Lurk0526/autonomous-water-transport-robot/hardware/README.md

# 硬件

- [第二版机械文件](cad/v2/README.md)：原件、配件解压文件和校验清单。
- [硬件清单](BOM.md)：现有记录及尚缺型号/数量，不作为采购订单或结算单。
- [电气与通信资料](electronics/README.md)：等待实际接线与设备手册。

最新设计、CAD 实际几何与装配实物尚未完成三方核对，尺寸说明以 [机械设计文档](../docs/mechanical-design.md) 的范围为准。
