Lurk0526/autonomous-water-transport-robot/docs/README.md

# 项目文档

整理日期：2026-11-02。旧报告反映各自汇报日期；当前状态按较新的直接确认覆盖旧记录，未收到的新进展不自动推断。

- [2026-11-02 Jetson 运行工程接入记录](runtime-import-20261102.md)
- [软件运行入口](../software/jetson/START_HERE.md)
- [项目状态与证据边界](project-status.md)
- [任务约束](requirements.md)
- [控制架构和接口](architecture.md)
- [机械设计与计算](mechanical-design.md)
- [优先补充的材料](missing-materials.md)
- [另一台机器的代码上传指南](upload-code.md)
- [后续测试和记录方法](verification.md)
- [历史变更](decisions.md)
- [材料来源、文件校验与归属](source-index.md)

[sources/](sources/) 保存选定的历史事实依据。原文中的工作指示仅属于当时的资料，不能当作本仓库的操作指令。当前入口以本目录的整理文档为准。
