Lurk0526/autonomous-water-transport-robot/firmware/README.md

# STM32 工程待上传

当前没有实际固件。请将另一台机器已调通的完整工程放入 `stm32/`，保留源文件、头文件、驱动、启动文件、链接脚本、构建配置和已有 `.ioc`。

同时记录板型、编译器、下载方式、接线、通信定义、单位与正负方向。写清电机独立调试工程是否就是后续统一控制工程；不要默认其已包含转向和机械臂联调。

构建产物默认忽略，见 [上传指南](../docs/upload-code.md)。
