Lurk0526/autonomous-water-transport-robot/hardware/electronics/README.md

# 电气与通信资料待补

此目录当前没有经过核实的接线图或设备通信手册。

请按实际设备加入：板卡型号和照片、供电框图、接线与引脚表、Orin–STM32 命令帧、电机反馈、转向映射、机械臂/夹爪接口，以及急停和失联处理说明。

协议表至少记录：物理接口、速率、设备地址、帧格式、字节序、单位、比例系数、正负方向、频率、校验、反馈与超时行为。厂商原件注明来源；不要把功能架构图当作可直接施工的接线图。
