Lurk0526/autonomous-water-transport-robot/assets/images/README.md

# 图像来源与用途

| 文件 | 来源 | 能说明什么 |
| --- | --- | --- |
| [vehicle_cad_reference.png](vehicle_cad_reference.png) | P5 已有的整车/机械臂 CAD 截图 | 历史布局参考；未经核对，不当作本次 v2 或 650 mm 制造尺寸证据 |
| [gripper_prototype.jpg](gripper_prototype.jpg) | P5 用户提供的四爪实物照片 | 夹具实物外观；基于供应商设计，不证明安装完成或承载通过 |
| [vision_bench.jpg](vision_bench.jpg) | P4 用户提供的台架照片 | 台架设备布置，原照片保留 |
| [vision_tracking.jpg](vision_tracking.jpg) | P4 用户提供的近景照片 | 台架近景；动态随动依赖团队报告，视频和日志待补 |

没有为图片添加检测框或合成试验结果。原始来源路径及文件哈希记录在 [导入清单](../../docs/import-manifest.json)。
