Lurk0526/autonomous-water-transport-robot/hardware/cad/v2/README.md

# 第二版机械文件

2026-11-02 接收，原始文件修改时间为 2026-10-26。版本“v2”沿用用户本次描述，没有通过 SolidWorks 几何比较确认与旧版的差异。

| 路径 | 内容 |
| --- | --- |
| `native/成品车.SLDASM` | 用户提供的整车总装，原字节保留 |
| `source_archives/机械臂配件.zip` | 用户提供的配件原包，原字节保留 |
| `arm_parts/机械臂配件/` | ZIP 解压的 25 个零件与 7 个子装配，保留原名称 |
| [manifest.json](manifest.json) | 原件、解压文件的大小、SHA-256 和 ZIP 目录信息 |

ZIP 的文件完整性已检查，中文文件夹名按原包的 GBK 编码还原。原有下划线文件名保持原样；未经 CAD 引用核对不改名。

**未完成 SolidWorks 打开、引用解析、装配重建、尺寸测量或干涉检查。** 当前不能保证配件 ZIP 包含整车所有依赖，也不能把文件名“成品车”当作实物整车完工证明。

优先补充从整车总装生成的完整 Pack and Go ZIP，以及同版 STEP。具体要求见 [待补材料](../../../docs/missing-materials.md)。
