Lurk0526/autonomous-water-transport-robot/docs/mechanical-design.md

# 机械设计与计算依据

## 最近确认的设计输入

2026-10-25 修订：2 根 650 mm 的 6060 纵梁，3 根 240 mm 的 4545 横梁；亚克力板 650 × 360 × 4 mm。供应商米重分别按 2.38 kg/m 和 1.50 kg/m。实际型材合金、热处理状态、整车孔位和完整质量尚未核对。

P5 此前确认车架已装配，但没有证明已装配的就是切短后的版本。2026-11-02 收到的第二版 CAD 尚未在 SolidWorks 中打开测量，不自动视为上述尺寸的制造定稿。

设备布置意图是前部机械臂、中部 Orin、后部电池，利用已有电池质量平衡前部载荷。没有角载称重或重心测量。悬架载荷应通过金属连接件传给型材，不能把亚克力板作为悬架承力支架。

## 型材与铺板质量估算

旧版型材按用户后来更正的 4545、1.50 kg/m 计算，不能沿用更早的 4040/0.94 kg/m。

```text
旧型材长度 = (840 + 2×760 + 4×310 + 4×140 + 8×61.42) / 1000
           = 4.65136 m
旧型材质量 = 4.65136 × 1.50 = 6.97704 kg
新型材质量 = 2×0.650×2.38 + 3×0.240×1.50 = 4.17400 kg

亚克力参考密度 = 1190 kg/m³
旧铺板 = 2×0.560×0.175×0.004×1190 = 0.93296 kg
新铺板 = 0.650×0.360×0.004×1190 = 1.11384 kg
```

| 范围 | 旧版估算 | 新版估算 |
| --- | ---: | ---: |
| 型材 | 6.977 kg | 4.174 kg |
| 亚克力板 | 0.933 kg | 1.114 kg |
| 合计 | 7.910 kg | 5.288 kg |

相同统计范围的估算减少约 2.622 kg，即 33.15%。未计角码、紧固件、金属安装板、橡胶和全部设备，不能写成整车实测减重 33%。旧结构也未确认实际制造。

## 四爪与末端载荷

四爪来自供应商基础设计，团队修改机械臂末端连接接口。PLA 打印件、钢适配件和橡胶接触垫的选择已经讨论；用户称实心打印，不推定为某个具体填充率。

夹具总成约 250 g 是用户回忆估计，包含舵机、连杆及紧固件，未含钢适配件，未称重。加约 650 g 碗水后为约 900 g 加适配件的初步清单，不能作为机械臂承载能力已经满足的依据。

## 支承垫与悬架初选

设备板支承垫的较新方案：4 块 60 × 60 × 5 mm 纵梁角部垫，4 块 45 × 45 × 15 mm 横梁垫。P5 确认尚未安装；硬度、预压、挠度和隔振效果待测。

汇报中的四根 6 N/mm 弹簧是初选值，允许与最终实物不同。示例假设：15–20 kg 全部视作簧载质量，四轮均分，轮端行程 50 mm，运动比 r=弹簧压缩/轮心位移=0.7，忽略预载和摩擦。

```text
轮端刚度 kw = 6 × 0.7² = 2.94 N/mm
单轮静载 = m × 9.81 / 4
静态下沉 = 单轮静载 / kw ≈ 12.5–16.7 mm
```

该计算只能解释初选思路。真实轮荷、运动比、阻尼、非簧载质量、动态冲击和触底风险都还未测量。旧记录约 720 mm 支撑跨度属于 800 mm 车架，不能用于 650 mm 新版。

原始确认见 [质量重算](sources/p5/frame_mass_recalculation_confirmed.md)、[悬架初选](sources/p5/suspension_preliminary_choice_6Nmm.md) 和 [P5 较新修订](sources/p5/revision_v4_current_basis.md)。
