Lurk0526/autonomous-water-transport-robot/software/jetson/requirements-jetson.txt

-c constraints-jetson.txt
-r requirements-cuda129.txt
torch @ https://pypi.jetson-ai-lab.io/jp6/cu129/+f/f36/0db283b1249b3/torch-2.8.0-cp312-cp312-linux_aarch64.whl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
torchvision @ https://pypi.jetson-ai-lab.io/jp6/cu129/+f/255/341cb5beb4673/torchvision-0.23.0-cp312-cp312-linux_aarch64.whl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
ultralytics==8.4.178
onnx
onnxruntime
onnxslim
pyorbbecsdk2==2.0.18
pyserial
pyyaml
scipy
matplotlib
cuda-python>=13.2,<13.3
cffi
