Lurk0526/autonomous-water-transport-robot/software/jetson/requirements-labelme.txt

# Independent annotation environment; do not install into the Jetson Torch venv.
labelme==7.8.1
