Lurk0526/autonomous-water-transport-robot/software/jetson/requirements-road.txt

-c constraints-jetson.txt
transformers==4.57.1
huggingface-hub==0.35.3
safetensors==0.6.2
tokenizers==0.22.1
tqdm==4.67.1
