Lurk0526/autonomous-water-transport-robot/reports/p5/speaker-script.md

# AstraGO P5 中英讲稿

对应修改后的10页正文，英文约589词。建议按每分钟115—120词排练，配合翻页与指图停顿，目标约5分半。只朗读英文；中文用于理解。第11—12页为备用页。

## 第1页 开场

**English**

Good morning. We are Group Two. AstraGO transports an open water bowl through continuous robotic gripping. Our design combines lightweight construction with vibration control, focusing on material selection, frame geometry, load distribution, manufacturing and battery sizing.

**中文**

大家好，我们是第二组。AstraGO通过机械臂持续夹持敞口水碗完成运输。我们的设计将轻量化与振动控制结合，重点介绍材料选择、车架结构、载荷分布、制造方法和电池容量。

---

## 第2页 材料选择

**English**

Each material serves a specific function. Aluminium profiles provide a low-density frame with reusable mounting slots. PLA enables low-cost custom fingers and supports our lightweight arm-end design. Steel is concentrated at the arm interfaces to retain the required connections. Acrylic makes the equipment deck convenient to cut and drill. This combination considers material, geometry and manufacturing together, giving each part a clear role in the vehicle.

**中文**

每种材料承担明确功能。铝型材提供低密度车架和可重复使用的安装槽；PLA便于低成本制作定制夹指，服务于末端轻量化设计；钢件集中用于机械臂接口，保留所需连接；亚克力便于铺板切割和钻孔。这样的组合把材料、几何和制造方式一起考虑，让每个部件各司其职。

---

## 第3页 车架减重

**English**

The frame provides our main calculated weight reduction. The original design used forty-five-millimetre profiles throughout. We removed the uprights and braces, reducing profile pieces from nineteen to five and brackets from eighteen to eight. Both longitudinal rails were shortened from eight hundred to six hundred and fifty millimetres, together with the deck. Calculated profiles plus acrylic decrease from seven point nine one to five point two nine kilograms, a saving of about two point six two kilograms, or thirty-three percent.

**中文**

车架是主要的计算减重来源。旧版全部采用4545型材，我们取消立柱和斜撑，型材从19件减少到5件，角码从18个减少到8个。两根纵梁由800毫米缩短到650毫米，铺板同步缩短。型材与亚克力的计算质量由7.91公斤降到5.29公斤，减少约2.62公斤、约33%。

---

## 第4页 载荷平衡

**English**

The battery also contributes through its position. The front arm and suspended bowl place load towards the front, so we position the battery at the rear to help balance them. One necessary component then performs two functions: energy storage and load balance. This is our approach to avoiding a separate ballast block and the extra mass added solely for balance.

**中文**

电池的位置也参与轻量化设计。前端机械臂和悬空水碗使载荷趋向前部，因此把电池放在后端参与平衡。这样一个必需部件同时承担储能和配重两个功能，目标是避免专门增加配重块，省去只为平衡而增加的质量。

---

## 第5页 3D打印与行业参考

**English**

Three-dimensional printing suits our small batch and custom finger geometry. We adapted the supplier-based mechanism at its arm interface. Solid PLA forms the fingers, while rubber pads provide bowl contact. A 2025 Fraunhofer IWU and MOSOLF vehicle shelf shows how integrated printing can reduce extra attachments. The useful principle is to consider geometry and mounting together.

**中文**

3D打印适合我们的小批量定制夹指。我们在商家机构基础上适配机械臂接口，实心PLA形成夹指，橡胶垫用于接触水碗。Fraunhofer IWU与MOSOLF在2025年的汽车置物架案例表明，集成打印能够减少额外安装件。我们借鉴的是将几何形状与安装功能一起考虑的原则。

---

## 第6页 电池选择

**English**

We select a forty-eight-volt, twenty-amp-hour pack for our design. The two motors reach a combined two-kilowatt peak only during acceleration. We therefore distinguish short power demands from the energy required over the task. The selected pack offers thirty amps continuous and a specified sixty-amp peak, with nine hundred and sixty nominal watt-hours. A forty-amp-hour pack doubles that stored energy. Our sizing approach uses the smaller capacity within its operating envelope, avoiding capacity beyond the task requirement.

**中文**

本次设计选择48伏20安时电池。两个电机合计两千瓦是加速时的短时峰值，因此选型时区分瞬时功率与整个任务的能量需求。所选电池持续放电30安、标示峰值60安，标称储能960瓦时；40安时则使储能翻倍。我们的选型思路是在工作范围内采用较小容量，避免超出任务需求的容量配置。

---

## 第7页 扰动传递

**English**

We control disturbance along its transmission path: from the road, through the wheels and suspension, to the frame, arm and bowl. Suspension responds to bumps, deck pads provide compliance, and rubber jaw pads support stable contact. Smooth starts and stops complement these mechanical measures.

**中文**

我们沿扰动传递路径布置措施：从路面到车轮与悬挂，再到车架、机械臂和水碗。悬挂响应颠簸，铺板垫块提供柔性，夹爪橡胶垫保持接触稳定，并通过平缓起停配合这些机械措施。

---

## 第8页 悬挂设计

**English**

Our preliminary spring selection is six newtons per millimetre at each wheel. Using a design mass of fifteen to twenty kilograms, fifty millimetres of wheel travel and an assumed motion ratio of zero point seven, calculated static sag is thirteen to seventeen millimetres. This uses about twenty-five to thirty-three percent of the travel, leaving upward movement for bumps. The spring provides support and compliance, while damping controls rebound, balancing rough-ground response with carrying stability.

**中文**

四轮弹簧初选为每根6牛每毫米。按15至20公斤设计质量、50毫米轮心行程及0.7的运动比假设，计算静态下沉约13至17毫米，占总行程约25%至33%，保留应对颠簸的上跳空间。弹簧提供支撑和柔性，阻尼控制回弹，兼顾越野响应和持碗稳定性。

---

## 第9页 橡胶支撑

**English**

Our deck-support design uses eight rubber pads: four at the rail corners and four on the crossmembers. The two sizes match these different interfaces. The pads form a compliant layer between the frame and equipment deck. Their placement combines distributed support with the aim of reducing transmitted disturbance, while the jaw pads address bowl contact.

**中文**

设备板支撑方案采用八块橡胶垫：纵梁四角四块、横梁四处四块，两种尺寸分别匹配不同接口。垫块在车架与设备板之间形成柔性层，通过分布支撑减少传递扰动；夹爪垫片则处理与碗的接触。

---

## 第10页 总结

**English**

Our design combines a shorter frame, functional material choices, balanced equipment placement, custom printing and appropriate battery capacity. The profiles and deck achieve about thirty-three percent calculated mass reduction. Suspension and compliant interfaces complete our approach to stable water-bowl transport. Thank you.

**中文**

我们的设计结合了缩短车架、按功能选材、平衡设备布局、定制打印和适当电池容量。型材与铺板的计算减重约33%，悬挂和柔性接口共同服务于稳定运水。谢谢。
