Lurk0526/autonomous-water-transport-robot/docs/project-status.md

# 项目状态

> 2026-11-02 运行工程更新：已补 Jetson 软件、相机/ROS 感知、训练工具、模型索引及本机仿真证据。下面保留此前资料整理时的逐项状态；同日软件与相机更新以 [接入记录](runtime-import-20261102.md) 为准，未完成的实车验证继续有效。

汇总日期：2026-11-02。物理进度的最近文字依据主要来自 2026-10-19 的 P4、2026-10-24/25 的 P5。2026-11-02 新增的是机械文件接收与整理，不能据此推定硬件功能已有新进展。

“团队报告”表示此前由用户说明；“材料在库”表示本次收录了文件；“待验证”表示没有收到足够的运行、测量或测试证据。

| 子系统 | 目前能确认的内容 | 尚缺内容 |
| --- | --- | --- |
| 车架 | P5 团队报告车架已装配；纵梁后续改短至 650 mm | 当前整车照片、最新版孔位、完整 BOM、实测质量；装配记录未说明是否为切短后的版本 |
| 第二版 CAD | 收到 `成品车.SLDASM` 和 `机械臂配件.zip`，原件及校验值已归档 | 总装关联的全部车体零件、SolidWorks 重建与依赖检查、STEP 导出 |
| 四爪 | 已加工；有实物照片；修改了与机械臂连接的接口 | 是否已安装、开合范围、工具中心、质量/重心、持续承载及防滑测试 |
| 视觉模型 | 团队报告 500 多张图像，YOLO11n-seg 微调，随机 8:1:1 划分 | 确切数量、标注、训练配置、权重、评估输出；随机划分不能替代独立场景验证 |
| 视觉跟踪 | 团队报告 OpenMV 图像经 Orin 处理、STM32 控制机械臂随动；台架照片在库 | 原始代码、动态视频、延迟与跟踪误差记录；未确认三维定位与抓取 |
| 驱动 | 团队报告 STM32 已实现电机启停、正反转、调速、转速读取 | 工程、命令帧、原始日志、反馈单位；未确认速度闭环 |
| 转向 | 前轴舵机转向为当前方案 | 舵机型号、接口、电源、标定、闭环与驱动转向联调 |
| Orin | 已购 Jetson Orin Nano 8GB，启用 Super 模式并刷机 | JetPack/L4T、依赖版本和实际环境检查输出 |
| 导航相机 | P4 报告 Orbbec Gemini Pro Plus 已到货 | 准确 SKU、SDK、固件、取流及户外深度效果 |
| Isaac Lab | P4 报告环境已安装 | 机械臂导入、URDF/资产、场景配置、实际仿真日志 |
| ROS 集成 | 已讨论作为后续集成框架 | 工作空间、节点、启动配置与运行证据 |
| 电源 | P5 偏向 48 V 20 Ah；供应商称 30 A 持续、最高 60 A 峰值 | 是否已购、化学体系、BMS、峰值持续时间、整车功耗和接线 |
| 急停 | 人工远程紧急下电为计划功能 | 实际接线、停止行为、通信失联和断电测试 |

以下均没有在现有材料中得到完整验证：自动取放碗、整车自主导航/绕障、持续载水运输、达到课程速度要求、振动改善、整车减重比例、Sim-to-Real 完成。

## 本次仓库整理完成的内容

第二版文件原样归档并生成 SHA-256 清单；配件 ZIP 完整性检查和文件目录整理；选定 P1–P5 汇报归档；整理阶段事实、设计计算、照片来源、补件清单及跨机器代码目录。当前新增的是资料组织，不是运行功能。
