Lurk0526/autonomous-water-transport-robot/docs/runtime-import-20261102.md

# Jetson 运行工程接入记录

日期：2026-11-02。来源：自动运水项目在 Jetson 上已有的工作工程。按仓库原有代码上传约定，完整放入 `software/jetson/`，保留模块导入和配置间的相对路径。

## 本次新增

- 小车输入适配、黑/白/黄循迹、无标线备用导航、参数来源校验、录制与只读监测。
- 道路语义分割的训练/评估/导出、ROS RGB-D 几何关联、TensorRT 部署与故障处理工具。
- OpenMV 主机取流、碗实例分割、机械臂跟随、串口通信、标注与 Windows/4060 工具。
- 无硬件导航仿真、抓放任务流程和奖励审计、现有测试及配置。
- 原 Jetson 部署、相机与跟随记录、测定表、模型/数据索引和软件测试证据。
- 本机已有 CAD 资产及其原始清单，保存在运行工程内部，未覆盖仓库第二版 CAD。

原仓库 `hardware/`、`reports/`、`assets/images/` 及其校验记录保持原样。`software/jetson/README.md` 保留原工作工程说明；先从 [START_HERE](../software/jetson/START_HERE.md) 进入。

## 状态修订与证据

| 历史待补项 | 本机补充的内容 | 仍未完成 |
| --- | --- | --- |
| Jetson 与 ROS 仅为方向 | Python 依赖锁、ROS launch/参数、环境验证程序与部署记录 | 新机器重新安装与环境验收 |
| 导航相机型号待确认 | 本机记录为 Gemini MAX；RGB-D、内部 TF、回放与故障恢复记录 | 与机械资料中的 Pro Plus 名称差异须按同一实物铭牌核对；最终外参、户外及装车精度 |
| 没有视觉运行代码 | 碗识别、OpenMV 主机链路和机械臂随动实现 | 独立板上脚本、完整标注数据和动态实机视频；自动三维抓取 |
| 没有导航/仿真实现 | 循迹主方案、备用路径控制、绕障、输入失效及任务模拟 | 真实底盘驱动、反馈闭环、实测车体与制动参数 |
| 没有训练/评估材料 | 道路/碗训练工具、道路部署清单与已有测试指标 | 本仓库未收录模型二进制与完整原始数据；现场测试 |
| 只有机械二版材料 | 本机另有命名为 chassis-v3 的 CAD 资产 | 跨版本对应、650 mm 实车一致性与 SolidWorks 重建 |

道路记录中的 2,095 张独立测试、排除水类后的六类 mIoU 79.62%、铺装 IoU 94.41% 来自既有离线评估输出，本次整理没有重新训练或重算精度。测试图像仍含水面场景；不能解读为专用砖路现场性能。

截至 2026-11-01 的任务优先级为循迹主导航、无标线备用。原记录里更早的“未确认赛道线”保留为历史背景，以后续更新为准。旧 P1–P5 汇报继续反映各自日期，不能用本次代码上传回写当时成果。

## 文件选择

收录实际源码、配置、依赖、文档、相关原生 CAD 和小型软件证据。不上传虚拟环境、`work/` 全目录、ROS build/install/log、完整公开数据集、rosbag、重复发行 ZIP、训练权重或 TensorRT engine。模型和原始记录使用文件大小与 SHA-256 索引；它们仍存原 Jetson/训练交付文件中，索引不是可下载权重。

厂家资料目录不等于团队定制底盘固件，本次不把厂家 STM32 例程填成已完成的实车控制工程。所有导入动作只操作文件；验证不启动相机服务、不打开串口、不发送机器人运动目标。

## 仍需联调

STM32 协议与真实转向/速度/IMU/里程计、相机到车体的实测安装关系、赛道线形和站点规则、有效距离参考、机械臂与夹爪的关节/负载/工具坐标、真实抓放和洒水记录仍待补。仿真假设继续明确标注，未知实车参数保持 null。
