Lurk0526/autonomous-water-transport-robot/docs/decisions.md

# 主要历史变更

| 日期 | 变更或澄清 | 当前如何使用 |
| --- | --- | --- |
| 2026-09 | 必须用自制铝型材底盘，不能直接用 RC 成品底盘 | 作为结构要求保留 |
| 2026-09 | 碗不能加盖，运输全程机械臂持续夹持，禁止车载碗托 | 不引入托碗卸载方案 |
| 2026-10-10 起 | 方案改为双电机后驱、皮带传动、前轮机械转向 | 覆盖旧四独立电机/滑移转向讨论 |
| 2026-10-15 | Orin 和众灵 MV4 机械臂已购；导航相机名称按用户原称保留 | 覆盖旧“尚未购入”状态；不擅自改相机 SKU |
| 2026-10-19 | STM32 统一承担下位指令；四爪加工但安装未确认；视觉随动和电机独立控制已有报告 | 功能架构与已实现链路分别标明 |
| 2026-10-24 | P5 确认车架已装配；实际夹具照片在库 | 不再把车架一概写成待加工；仍需新装配照片 |
| 2026-10-24 | 抓碗后相对车体保持姿态 | 不写成已实现主动调平、主动减振或自动收臂 |
| 2026-10-24 | 垫片改为 60×60×5 mm 和 45×45×15 mm，尚未安装 | 覆盖早期 50×50 / 40×40 平面尺寸 |
| 2026-10-25 | 旧型材更正为全 4545；新纵梁 800→650 mm，铺板随之缩短 | 覆盖更早质量对比与旧支撑跨度 |
| 2026-10-25 | 48 V 20 Ah 作为倾向方案，6 N/mm 弹簧作为汇报初选 | 均不视为实测性能或已装车参数 |
| 2026-10-26 | P5 汇报采用用户修改及案例合并版 | 归档该版，保留历史计算假设 |
| 2026-11-02 | 用户提供第二版整车总装和机械臂配件 ZIP，要求整理 GitHub，代码另机上传 | 原件保留，依赖待核实，代码目录标待补 |

较新的文字设计输入不自动证明 CAD 和实物已同步；三者需要版本对照。
