Lurk0526/autonomous-water-transport-robot/software/jetson/docs/bowl-follow-fast-20261022.md

# 重新摆姿后的第二档跟随测试（2026-10-22）

用户确认手动重新摆过机械臂，肘部由原标定区间移动至约 P1741。
旧配置的关节范围及图像响应不能直接用于该姿态。期间未因报错而扩大肘部范围；
已经停止的主轴执行过受限测量、记录实际位置后才恢复跟踪。

## 本次实际采用的标定

新主轴双向标定已通过，测量数据为
`work/bowl-follow/calibration-20261022-213842/report.json`。
局部图像响应矩阵（行 x/y，列 000/003，单位 px/实际 P）：

```
[ 1.966956, -0.027066 ]
[-0.073875,  0.969621 ]
```

条件数 2.0364。对应测量姿态约：000 P1627、001 P1331、002 P1742、
003 P959、004 P1473、005 P1508。肩部曾在新姿态下的小幅试动中出现回落，
并导致目标移出完整画面，故本轮没有把未通过的新五轴数据标为成功。
当前只有底座和腕部执行图像纠偏，其他四轴查询位置并保持。

## 第二档速度策略

底座和腕部单步指令上限 100 P，位置指令时间 500 ms。图像偏差小则降低有效位移，
并在中心区停止，不把所有动作都强制放到最大。主轴正在运动、图像偏差至少 30 px、
方向不变且查询确认已经位移至少 3 P 时，允许约 0.4 s 后提前续接同向轨迹。
小误差、停滞、旧图像、承重关节动作不启用续接。反向移动、居中及丢失目标可以中断。
续接仍检查软限位、参考姿态窗口、单步位移与累计行程，不自动回中或释放力矩。
行程按实际位移与剩余目标计数，避免多次续接重复累计同一段运动。

另修复接近窗口边缘时，最小死区补偿步长可能大于剩余可用位移的问题；
不能发送的最小动作显示受限，不再发出动作后触发会话位置窗口故障。
腕部参考窗口覆盖当前软件范围，所有目标仍受绝对边界限制。

## 实机结果及后续上移暂停诊断

高速档已触发实际提前续接，首轮连续记录中 `retarget_count` 达到 21。
用户明确反馈“这次速度可以了”，但随后报告仍不能抬头。该时刻读取状态为
`low_confidence`，腕部约 P979、正向剩余约 69 P，控制仍使能；因此该段暂停
有直接的识别门槛证据，不能直接归为关节到限位。
诊断和完整状态分别保存在 `work/speed-validation-current/upward-stop-diagnostics.json`
及 `live-test.json`。

已添加同一碗的短时连续性门槛：先由至少两帧置信度 0.75 的有效检测建立信任；
最近 0.35 s 内，中心距离不超过 40 px、框重合度至少 0.3、面积比 0.5～2 时，
允许置信度降至 0.60。低分检测不能建立新目标，也不能延长信任有效期；
无检测、多个无法区分的目标或超过宽限时间仍停止。重启会话的目标锁定仍需 0.85。
这仅缓解模型已输出的同一目标短暂降分，不提供看不见目标时的盲目运动。

修改后 91 项离线测试通过。后续上移实机记录保存在
`work/speed-validation-current/upward-continuity-test.json`；应结合最后用户反馈评估。
没有把测试数目或启动成功当成实机跟随验收。

## 肘部接力与范围实测（后续）

用户再次报告上移卡住后，完整状态捕获到 `limited`：腕部 P1044、正向余量 2 P，
肘部 P1727、负向余量 2 P。此前置信度下降的暂停也存在，但不能将它说成全部原因。
停住时的原始连续状态保存为 `upward-continuity-test.json` 与 `elbow-handoff-live.json`。

用户把碗放远后，底座、肘部、腕部的双向标定全部通过；当前启用轴为 000、002、003，
其余三个轴保持并读回位置。肩部未在这次重新启用。成功测量文件为
`work/bowl-follow/calibration-20261022-220301/report.json`，响应矩阵列顺序 000/002/003：

```
[1.635474, -0.139658, 0.031597]
[0.004349, -1.245609, 1.146236]
```

条件数 1.0878。肘部负向约 45 P 指令偏差使原始小范围限制过早耗尽有效位移。
肘部指令单步上限 65 P，并进入有边界的分配器；底座、腕部仍为 100 P，
保留图像闭环减速、居中停止、失去观测停止和反馈故障停止。

补测分步扩展：对肘部最多每步 65 P、600 ms 指令，约 950 ms 后读取位置，
同时检查新鲜目标、非移动关节稳定性和图像方向。最低实际发送 P1600，
位置反馈 P1643（起点 P1659），碗中心纵坐标约 76.09→96.05，
响应 1.2475 px/P，与双向标定方向一致。因此将肘部软件下界从 P1679 改为 P1600。
上界 P1859 保持。所有原始步骤、图像响应及时间记录保存在
`work/speed-validation-current/elbow-extension*.json`。

采用 `apply_measured_elbow_extension()` 校验同一模型、测量时效、步幅、实际位置，
并重新计算图像响应，只有通过的原始记录才能扩展配置。失败或不一致记录不能扩大范围。
软件下界不等于机械硬限位，也不承诺在任意碗位置都有剩余自由度。

标定恢复同时修正了两个问题：保留各轴原始测量锚点，不能被中断后重新启动时的位置覆盖；
没有实际位移的试验不能成为方向样本。中断报告也保留名义正负幅度及原始锚点。
标定窗口会剔除超过时间范围的旧帧，避免低一些的帧率被旧的第九帧长期卡住。
对同一碗的高度重叠重复检测，沿用已锁定框关联；无法区分的多个候选仍拒绝。

新配置已实际启动。等待用户向上越过原停止点的验证，连续状态保存在
`work/speed-validation-current/expanded-range-live.json`。不以启动成功替代移动验收。

## 腕部与肘部协同扩展（又一轮）

用户反馈仍在“90 度附近”卡住，当时状态腕部约 P1048、肘部约 P1650，
两轴均接近软件边界。不能根据用户角度描述把它认作机械硬停。

进行小幅腕部正向与肘部正向补偿的协同试动。已完成并核对的一段数据：
腕部 P1120→P1156，指令 P1185；肘部 P1779→P1810，指令 P1798。
碗中心约 (173.22,85.03)→(172.59,85.56)，实际图像位移很小，与两轴相互补偿一致。
所有其他关节反馈保持稳定。这证明实际腕部能够继续运动到 P1156，
不证明协议全范围都是本机可用的机械行程。

后续更小的一步在发出前被指令边界检查拒绝，未把那一步计入可用范围。
原始中止报告保留于 `work/speed-validation-current/pitch-extension.json`；
已完成前缀的独立记录 `pitch-extension-completed-prefix.json` 带原报告 SHA256、
中止原因与完成范围说明。`apply_measured_pitch_extension()` 重新校验每步位置、
模型、图像位移和实际最大指令，只将腕部软件上界改到已发出且完成核对的 P1185。
其他未经测量的上界没有放开。肘部范围仍为 P1600～1859。

这一轮恢复后已居中约 (159.71,121.67)，腕部实际约 P1151，控制仍使能。
上移验收等待用户实测确认，记录位于 `pitch-extension-live.json`。

## 本轮最终验收

用户最终确认：“能越过原位置，停后也稳”。本轮上移卡点及停稳测试按该实机反馈记为通过。
101 项离线测试通过，完整配置与证据已保留。验收状态和时间见
`work/speed-validation-current/final-acceptance.json`。跟随保持运行，GUI 停止按钮仍可随时停止。
