Lurk0526/autonomous-water-transport-robot/software/jetson/docs/bowl-transport-simulation-20261023.md

# 满水碗搬运：仿真与训练方案 v0.1

> 历史初稿：当前决策以 [v0.2 复审](bowl-transport-review-v0.2.md) 为准。行驶中展开现默认关闭；本机验证入口为 `sim/bowl_transport/preflight.py`。不能将此稿中的设想或示例时长视为已验收性能。

2026-10-23。目标是底盘接近平台时提前准备机械臂，停稳后抓取；抬离平台后平滑回收并降低携碗高度；接近目的平台时提前准备放置，停稳、承托确认后松爪。优先减少洒水，再在合格动作中缩短任务及停车时间。

## 已知条件与当前交付范围

用户确认：碗口外径约 156 mm，高约 60 mm，碗加满水总重 650 g，水加到碗口；抓取与放置接触阶段车辆静止。示意图平台高度约 300–400 mm；顶面长宽未定，路线起伏没有实测尺寸。

总装 ZIP 已解压到 `assets/cad/chassis-v3/`：77 个文件，其中 64 个 CAD 文件。已读取本次包内总装的引用树，按文件名核对 64 项引用全部存在。这仅证明引用文件覆盖，尚未证明完整几何转换、配合、关节轴线或动力学正确。文件校验清单位于该目录的 `manifest.json`。

| 本次产物 | 已完成内容 | 能证明什么 |
| --- | --- | --- |
| 参数表 `sim/bowl_transport/scenario.json` | 已知尺寸、总重、满水条件与待测项分开 | 输入来源清晰；未知值不冒充测量 |
| `flow.py` | 13 阶段监督逻辑，包含停车、时效、夹持、承托、超时条件 | 可测试阶段切换逻辑；没有硬件连接 |
| `demo.py` | 合成观测驱动的流程预演、CSV 与 HTML 报告 | 演示提前准备的顺序；不是机器人仿真结果 |
| `build_scene.py` / `.usda` | 参数化碗、两个平台、地面、质量与碰撞定义 | 可作为 Isaac 场景起点；碗型为暂定截面 |
| 云端安装/场景启动脚本 | 固定 Lab 源码提交及其 Sim 依赖，提供启动命令 | 已核对上游版本和语法，待 RTX 机器运行验收 |
| 机器人及训练策略 | 本次只完成设计 | 尚无验证过的机器人 USD/URDF、PPO 任务或训练权重 |

当前生成的水面是明确标记的视觉圆盘，没有流体物理。USD 中留有空的 RobotMount，尚未接入你们的机械臂。流程预演里的成功信号是合成输入，不能用于宣称抓取成功或减少了多少实际停车时间。

## 工具分工与租赁建议

本项目采用 Isaac Sim 做机器人接触、相机、场景和少量液体验证，Isaac Lab 做批量任务、随机化、策略训练和评估。Isaac Lab 新版本也有不依赖 Sim 的后端；这里选 Sim/PhysX 是为了保持场景、接触和液体验证路径一致。已有 YOLO 分割继续负责检测，不因加入 Lab 就重新训练一个端到端视觉模型。

租赁优先：单张 RTX 4090 24GB，Ubuntu 24.04 x86_64，64GB 系统内存，至少 16 个可用 CPU 线程，300GB 持久 SSD；若要长期保存相机训练数据，建议 500GB。RTX 5080 16GB 也可作为候选，但先以显存余量选择 4090；这不是声称 4090 对所有算子都更快。首轮只租按小时计费的一台，先通过驱动、Vulkan/RTX、场景和训练示例检查，再开始长任务。

机器需要实际 GPU 图形/Vulkan 能力、可用的远程桌面或 Isaac 远程显示方式、SSH、持久磁盘和出站 HTTPS。仅能运行 CUDA 的 notebook 服务未必满足要求。A100/H100 没有该渲染路径所需 RT 核，不作为本方案的替代选择。驱动按所选 Isaac Sim 版本的官方兼容检查通过后记录；不在未知租赁镜像上盲目升级驱动。

当前 Jetson Orin Nano 用于已有视觉和最终执行、本次逻辑预演；官方当前 Isaac Sim ARM 支持列为 DGX Spark，不能把它等同于支持 Orin Nano 本地完整 Sim。

已固定的候选软件组合：Isaac Lab `release/3.0.0` 在提交 `961760bcb91e3af48e7d116292e57e8ecaefc31e` 的快照，上游 pyproject 指定 Isaac Sim `6.2.0.0`、Python 3.12、RSL-RL 5.5.1。详见 `versions.json`。云端尚未安装和测试，不宣称已验证这组依赖在租赁镜像上可运行；遇到兼容问题按固定提交排查，不混用旧版 2.x 教程。

## 对原始思路的调整

### 定位：分割、碗沿和标记各自承担清楚的任务

已有模型的碗轮廓与置信度用于找目标、保持跟踪。分割掩膜的质心不是倾斜视角下的三维碗口中心，不能直接作为机器人抓取点。近距离应提取碗沿候选、拟合椭圆，并结合标定过的相机、已知直径和平台几何求目标位姿；遮挡或残差过大时拒绝进入接触阶段。

已验收的碗跟随 v1.0.0 是机械臂的图像跟随。它可复用识别和已有串口控制经验，但尚不提供底盘导航、车辆停靠或三维抓取坐标。底盘驱动、里程计、定位和制动反馈需要独立接入；本方案中的行驶阶段还没有连接到实体车辆。

碗底中心的红色标记保留为辅助观测：颜色候选只能在目标碗区域内关联，过滤反光、多个红色物体、突跳和遮挡。装水后折射会改变所见位置，水面反光/波纹也会导致误差；应分别采集空碗和满水的验证数据。不能用水下红点的像素位置当作准确的三维位置或独立深度传感器。

若规则允许，在平台边缘或碗外侧贴干燥的 AprilTag/ArUco 类标记作为定位基准更容易标定。它不能被默认为比赛允许；不允许时使用碗沿与已知平台。已有 OpenMV 是单目相机，当前项目尚无已核实的深度和手眼外参；如换深度相机，对水和亮面碗的失效区域仍须实测。相机若随臂移动，定位必须使用图像时刻对应的关节位置和相机外参。

### 抓取角度：以碗口法线作为接近方向，搜索可行的车位和夹爪转角

首选候选是碗保持水平、夹爪从上方接近、各指在碗沿外侧向下进入夹持区。这里“从上方”指工具接近轴对准碗口法线，不能直接换算成某个舵机 P 值。转动夹爪朝向及调整车辆停靠位置，以避免夹指碰碗沿、平台或机械臂本体，并让机械臂尽量缩短承重力臂。

最终角度需同时满足：开口能包络 156 mm 碗及定位误差；闭合时接触稳定；不会把手指伸入满水区域；关节可达且远离限位；路径不碰撞；载荷有余量。CAD 的配合状态不能替代实际夹爪开度测量。若当前夹爪无法容纳碗口，应评估在较低外壁夹持或增加托底/托沿附件，不能依靠算法弥补几何不匹配。

外壁斜度、釉面和湿润会影响夹持，夹紧后可能滑动。对于满水碗，带软垫的承托结构值得优先做机械验证；不能仅依据摩擦假设就认定不会掉落。抓取姿态搜索先枚举停靠位置、工具方向与接触高度，过滤可达性和碰撞，再比较接触稳定、关节力矩、轨迹平滑程度和动作耗时。

650 g 负载在肩部水平力臂 0.25 m 时，单独由碗贡献的静态力矩约为 `0.65 × 9.81 × 0.25 = 1.59 N·m`，还未包含夹爪、臂段与运动负载。这个估算用于提醒必须核对真实关节能力，不作为现有舵机可承受的结论。现有标准控制链是五个臂关节加夹爪，不应假定能任意实现六维末端位姿。

### 携碗：降低位置、缩短力臂，控制加速度和晃动

抬起时先给碗底留出平台边缘的净空，再回收并下降。最低携带位置由车体、轮胎、路面净空、关节可达范围和稳定性共同决定；不会预设一个高度就是最优。

轨迹采用连续速度和加速度、受限 jerk 的时间参数化，同时控制碗口姿态。车速稳定但经过凸起仍可引起碗倾斜；因此最终携带控制需用底盘姿态/角速度观测（例如 IMU）和关节反馈。若没有 IMU，先验证固定低位姿态与较保守的底盘速度，不宣称已具备主动抗颠簸能力。

工程筛查可使用小角度近似：半径 r 的水平容器在水平加速度 a 下，液面单侧上升量约 `r·a/g`；静态倾角 θ 对应约 `r·tan(θ)`。程序把二者及一个简化波动项相加，作为偏保守的风险代理，既不是完整流体解，也不能换算为洒水克数。

用碗口半径 78 mm 粗估，1° 倾斜就对应约 1.36 mm 的边缘高差。加到碗口时名义余量为 0，轻微姿态与加速扰动都可能洒水。表面张力、真实内壁、碗沿和润湿会影响结果，因此不能声称任何非零加速度必然产生某个固定洒水量，也不能保证零洒水。目标应是最小化实际损失，并明确比赛允许的损失指标。

## 动作阶段与减少停车时间的方法

| 阶段 | 车辆 | 机械臂/碗 | 转移依据 |
| --- | --- | --- | --- |
| APPROACH_PICK | 接近并制动 | 在验证过的空间内展开至预抓取姿态，保持净空 | 预抓取动作完成，进入停靠区域 |
| PICK_WAIT | 静止 | 最后定位修正 | 目标新鲜、位姿可信、路径清晰、底盘和臂已稳定 |
| DESCEND | 静止 | 沿接近方向进入夹持位置 | 到达预定位置 |
| CLOSE | 静止 | 闭爪并确认夹持 | 夹持证据成立，不能只靠计时 |
| LIFT | 静止 | 水平抬离台面 | 碗底和边缘净空确认 |
| RETRACT | 静止 | 平滑回收到低位携碗状态 | 碗固定、车体碰撞净空确认 |
| CARRY | 行驶 | 保持低位、限制晃动 | 进入可提前准备放置的路段 |
| PREPLACE | 减速接近 | 平滑抬升/展开至预放置位置 | 预放置完成，保持平台净空 |
| PLACE_WAIT | 静止 | 最后定位与稳定检查 | 目的平台位姿及稳定条件成立 |
| LOWER | 静止 | 缓慢下降直到承托成立 | 碗已由平台支撑 |
| OPEN | 静止 | 松爪 | 承托持续成立、松脱验证 |
| RETREAT | 静止 | 撤离碗与平台 | 不再干涉，允许底盘离开 |

首版只将预抓取和预放置与底盘行驶重叠，抓后回收也先保持停车。待实机证据和联合仿真充分，再评估是否允许在低速直线路段同步回收。PREPLACE 不在急转弯、路面凸起、视野丢失或受载姿态不稳时展开。

准备时机根据到达时间估计与机械臂动作时间决定：当剩余行驶时间接近“准备动作时间 + 制动/定位裕量”，且扫掠空间清晰时启动准备。越过平台或姿态不满足时，减速或延后接触；不是无条件靠近固定距离就展开。

静止判断使用底盘线速度、角速度、加速度和连续稳定窗口。配置中的 5 mm/s、约 1°/s、0.05 m/s²、0.5 s 是最初调试门限，不是已验收值；策略不得为追求快而取消检查。若存在轮滑或悬架震动，零轮速不等于机械臂基座已稳定。

夹持、承托和松脱需要定义实机可获取的证据：夹爪开合位置结合视觉跟随/小幅试抬；如有可靠电流/力传感则增加接触证据。现有串口位置回读不能冒充力传感器。保持抓力的 HOLD 是监督逻辑状态，实际停车和稳定姿态控制需由底层控制器实现，不能直接把实验程序的 HOLD 映射成卸力。

## 三层仿真与训练安排

### 第一层：机构与动作基线

导入总装后，按一起运动的刚体合并固定零件，省略不影响碰撞的螺纹和细小紧固件。保持机械臂、夹爪连杆、底盘和轮悬架的必要运动关系，建立关节轴、零位、正方向、限位、质量惯量和驱动。

夹爪中的连杆/齿轮耦合要明确独立驱动自由度与从动关系，不能把每个 CAD 配合都当成可独立控制关节。闭链需要仿真支持的约束建模或经验证的等效机构。首先验证空载运动，再验证夹持接触和 650 g 等效负载；不直接用刚性“粘住碗”作为抓取成功的证据。

现有 USD 起始场景给碗整体设置 0.65 kg，并用分片凸碰撞保留碗口空腔。几何内外壁、壁厚和碗底尺寸均为占位；加真实水粒子前必须改成实测空碗质量，再添加相应水质量，避免重复计重。场景无机器人时只用来检查资产加载和单位。

### 第二层：Isaac Lab 批量训练

先用已验证的逆运动学/规划和状态机收集成功示范。若这一基线已能达到比赛指标，可以直接部署它；若对地形、定位误差或时机变化仍不够稳，再使用候选方案“基线动作 + 有界残差 PPO”。训练主要改善速度缩放、携带高度/姿态的小幅修正与提前准备时机。

策略输入：关节位置/估计速度、夹爪状态、底盘线角速度和 IMU、阶段、目标相对位姿及不确定度、到平台距离/到达时间、最近动作。任何未安装的传感器不能直接出现在部署策略输入中。仿真可给教师/价值函数额外真值，但部署学生必须使用实际观测，并验证噪声、延迟和丢帧。

策略输出：受限的关节目标修正或可达任务空间小幅修正、底盘速度倍率、准备动作触发建议。关节目标仍由限位、碰撞、可达性与平滑轨迹约束检查；闭爪、松爪和接触准入由监督器决定。不会以力矩控制训练后直接部署到现有仅已验证位置指令的串口控制链。

代价考虑任务完成、洒水风险代理、夹持滑动、碗倾斜/角速度、末端水平/垂直加速度、jerk、关节负载、用时和停车时间。掉碗、碰撞、失去夹持、关节越界属于失败；不要用高完成奖励抵消大量洒水。最终评估按约束与指标逐项报告，不能只看训练 reward。

课程从固定平台和明确目标位姿开始，依次加入定位扰动、目标位置变化、低速直线路面、转弯制动、实测起伏、满水边界。可在学习早期用较低水位，但最后测试必须使用加到碗口工况。当前随机化总重 0.60–0.70 kg 只是初始鲁棒性设计范围，中心为实测总重 0.65 kg；空碗质量和水质量不能在未知时虚构。

先 16 个环境检查重置/接触/观测，再按显存与吞吐测试扩到 64、256、512，数量由性能实测决定。物理步长 1/240 s、策略 20 Hz 是候选起点，接触和执行链路校准后调整。相机不必在所有并行环境全分辨率实时渲染，可先训练结构化状态，之后少量相机环境验证感知闭环。

### 第三层：少量物理液体与实机验证

在 Isaac Sim/PhysX 中选少量场景加入 GPU PBD 水粒子，核对壁面漏水、粒子间距、接触偏移、碗口几何和有效容量。减小粒子间距及时间步后结果应趋于稳定；否则洒水估计不能采信。该验证不与数百并行训练环境同时全量开启。

统计越过碗沿后离开容器的粒子质量并检查质量守恒；与实机同轨迹前后称重对比，标定简化晃动模型。满水650 g只确定总重，空碗未称前无法给出真实水质量和水保留百分比。绝不能把视觉水面圆盘、固定附着水块或风险代理当作实际液体损失。

实机先确认夹爪和 650 g 载荷，再做低水位、平地慢速验证，最后按满水比赛工况测试。低位携带、制动和预放置抬升要分别测试；先核对实机执行延迟、回差和目标跟踪，再验证联合流程。

## 验收与对照实验

对照方案 A：车完全停下后才准备抓/放；方案 B：在行驶中提前准备，但接触准入条件与 A 相同。使用相同路线、初始水量、碗位置和随机种子，不通过放宽安全条件让 B 看起来更快。

记录完整任务时间、两处停车各阶段用时、抓放成功率、掉碗/碰撞次数、前后水质量差、最大姿态误差、关节跟踪误差。分别报告均值、离散程度和高分位，不只取最好一次；仿真留出未参与训练的碗位置、地形和光照组合。初步设计每个主要工况至少 20 次重复，正式样本量按波动和比赛要求调整。

最终目标数值等待赛事的洒水评分/容忍度和实机测量确定。本次不承诺某个抓取成功率、训练小时数或停车缩短百分比。

## 尚需补齐的实测项

1. 空碗重量、碗底/内壁截面；水质量由 650 g 减空碗重量取得。
2. 夹爪最大/最小开口、闭合映射、湿碗夹持稳定性，650 g 负载下各关节跟踪能力。
3. 关节轴线、工具中心、实际安装变换，底盘外形和机械臂扫掠空间。
4. 平台高度/顶面范围和路线起伏；未知平台先扫 30/35/40 cm，顶面和间距明确为占位参数。
5. 相机标定、时序、IMU/里程计可用性，定位标记是否允许。

现在已有完整原生 CAD 包，不需要重复上传相同零件。云端可用兼容 CAD 转换器转换几何；若该环境不支持原生 SolidWorks，才由 SolidWorks 导出保留部件的 STEP，或使用明确关节轴的机器人导出流程。几何转换后仍必须建立关节和验证驱动，不能宣称改扩展名就完成数字孪生。

## 官方资料

- [Isaac Sim 硬件与平台要求](https://docs.isaacsim.omniverse.nvidia.com/latest/installation/requirements.html)
- [Isaac Lab 版本兼容表](https://github.com/isaac-sim/IsaacLab/blob/main/README.md)
- [Isaac Lab 安装](https://isaac-sim.github.io/IsaacLab/release/3.0.0/source/isaaclab/installation.html)
- [固定提交的 pyproject](https://github.com/isaac-sim/IsaacLab/blob/961760bcb91e3af48e7d116292e57e8ecaefc31e/pyproject.toml)
- [机器人关节、驱动和抓放验证流程](https://docs.isaacsim.omniverse.nvidia.com/latest/robot_setup_tutorials/tutorial_manipulator_workflow.html)
- [PhysX GPU 粒子与液体](https://docs.omniverse.nvidia.com/kit/docs/omni_physics/latest/dev_guide/particles/particles.html)
- [RTX 5080 官方规格](https://www.nvidia.com/en-us/geforce/graphics-cards/50-series/rtx-5080/)
- [RTX 4090 官方架构与规格](https://images.nvidia.com/aem-dam/Solutions/geforce/ada/nvidia-ada-gpu-architecture.pdf)
