Lurk0526/autonomous-water-transport-robot/software/jetson/docs/smooth-current-pose-follow-20261023.md

# 当前位置启动与平顺三轴跟随

本版承接 2026-10-23 后续要求：保留底座、肘、腕三轴，改善交接与速度，程序重启后无需恢复初始姿态。
此前限位、串口恢复及中间版本记录见 `current-pose-follow-20261023.md`。

普通“开始/继续跟踪”读取六路实测位置，从已通过双向测量的姿态模型库中选取最接近当前肩、肘、腕、相机旋转姿态的响应矩阵。
模型来自 `work/bowl-follow/calibration-*/report.json`；启动前重新用原始试验计算矩阵，失败或不一致记录不参与选择。
锁定新鲜目标、以当前六路位置建立会话后即可运动，不要求摆回保存的位置，不在普通重启时重新探测。
`--calibrate` 保留为主动重新测量入口。没有任何有效三轴模型时才需要先测量；本项目已经保存了多组模型。

运动仍使用昨晚的主控制结构、500 ms 位置指令与实测方向偏差补偿。
主轴单步指令上限 100 P；肘部正向指令 65 P、负向补偿指令最多 100 P，预计实际位移仍限制为每步 65 P。
额外负向指令量用于补偿实测约 42～46 P 的负载偏差，不允许把更大指令直接当作更大实际位移。
本版在腕部接近边界前连续调整分配权重，让肘部提前分担，平滑相邻规划的实际位移向量。
用户反馈肘部仍不积极后，正常分配权重改为底座/肘/腕 `[1,1.35,1]`，接近腕部边界时肘部进一步参与。
无法实现的过小承重关节动作不强行放大成明显跳动，微小误差交给其他可用关节。
居中、丢目标和操作员停止仍立即中断动作，不等待平滑尾部。

同向续接间隔由 0.4 s 改为 0.22 s，允许已读到真实进展的肘部参与协同续接。
续接也能缩短仍在运动方向上的目标，实现减速；停滞、反向、旧图像、过大位移仍拒绝续接。
规划周期为 0.08 s；这些是软件更新间隔，不表示舵机能在该间隔完成动作。

命令范围维持底座 P1100～1900、肘部 P1437～2447、腕部 P650～1800，保持关节与反馈保护不变。
肘部下界来自已成功的 `calibration-20261022-200630`：命令 P1437、实测 P1473，
避免把昨晚另一姿态的 P1600 局部下界错误当作这台舵机的固定机械下界。
这里的“当前位置启动”适用于该运行范围和相机可见的目标；不会取消机械范围、串口及反馈检查。
打开界面仍只开启视觉，重启后点击“开始跟踪”即可，不设置开机自动运动。

131 项离线测试通过，覆盖模型选择、改变姿态后的直接重启、渐进肘腕交接、承重轴续接、减速、停滞与立即停止，
并验证额外偏差补偿指令不会突破实际单步位移上限。
肘部停止后已重复捕获约 14 P 的负载回弹；其最后已知运动轨迹使用不超过 25 P 的回弹包络，
并要求相邻反馈变化、实际位移与绝对范围同时通过检查。其他关节不扩大该包络。
首次直接启动与再次启动的时间、是否生成探测记录，以及连续运行状态分别保存在
`work/smooth-follow-20261023/`。实机平顺性与速度以本轮用户实测反馈评估，不以测试数代替验收。

实机已完成“停止→重新启动”：7.11 s 恢复就绪，`new_probe_reports=0`，
没有恢复初始姿态或重新探测。重启后的前 36 条运动命令中已实际续接 14 次，
随后丢失目标时状态为 `no_target` 并保持停止，控制会话未故障。

## 初版验收

用户最终确认：“不卡了，成功，把这次调参定位初版”。据此定为 **v1.0.0**。
参数与三个通过校验的实测姿态模型已经保存到 `config/`，不依赖临时工作目录中的模型记录。
启动缺少 `work/bowl-follow/current-trial.json` 时，也可从初版参数读取当前位置并建立会话；
固定参数不保存或强制某个初始关节位置。
132 项离线测试通过，版本源码、参数、模型与实机验收记录保存在 `releases/bowl-follow-v1.0.0.zip`。
