Lurk0526/autonomous-water-transport-robot/docs/sources/p5/content_basis_v2.md

# AstraGO P5 / Week 9 V2 content basis — 2026-10-24

This file records direct confirmations in the current P5 conversation. These override older P4 procurement and frame records. No full-vehicle performance has been established.

## Delivery

- 10 slides, 7–8 minutes, English slide copy and bilingual speaker notes.
- Continue warm ivory, graphite and burnt-orange style.
- Required: lightweight justification; four explicit approaches (material selection, load distribution, simpler joints, additive manufacturing); disturbance path and intervention locations; concise recent-technology critique; validation.
- V2 narrative: task need, four design approaches, disturbance transmission, rubber supports, critical appraisal, validation. Mass audit sits within simpler joints, with follow-up decisions about section size and deck coverage.
- No additional Vehicle Materials method or reference-format requirements reported.

## Revised frame and mass

- Single layer, 800×360 mm overall frame plan.
- 2×800 mm 6060Q single-slot rails, supplier mass 2.38 kg/m.
- 3×240 mm 4545Q crossmembers, supplier mass 1.50 kg/m.
- Supplier labels nominal wall thickness 1.3 mm; this is not a claim that every rib has identical thickness. Extrusion alloy/temper unknown.
- Crossmembers vertically centred relative to 60 mm rails; upper face 7.5 mm lower.
- 8×4545 brackets, ADC12 die-cast aluminium, sandblasted. Each uses 2 bolts and 2 slot nuts. Bolt size and hardware mass unknown.
- Revised acrylic deck: 800×360×4 mm. Four corner bolts fix it to longitudinal rails.
- 4×50×50×5 mm rubber pads at rail-corner deck bolts.
- 4×40×40×15 mm rubber pads at crossmembers: front/rear midpoint one each; middle crossmember ends one each. Nominal 2.5 mm interference before compression. No measured preload. Rubber grade/hardness unknown; isolation performance unverified.

## Previous frame

- User calls it a double-layer design. All profile pieces 4040Q at supplier mass 0.94 kg/m.
- Lengths: 840×1, 760×2, 310×4, 140×4, 61.42×8 mm.
- The last 8 pieces are additional braces, NOT 8 weld joints. Original 11-piece count omitted them; total is 19 pieces.
- 18×4040 brackets, 4.3 mm version, ADC12 die casting. Each uses 2 bolts and 2 nuts. Other support plates/hardware need inventory.
- Welded upright/brace connections were discussed as intended construction. Physical old-frame completion is not established.
- Two side-by-side acrylic panels, each 560×175×4 mm, split by middle rail. Earlier 560×390 description was corrected; there are no upper/lower deck panels.
- Mass calculations (1190 kg/m³ acrylic reference density): old profiles 4.3722784 kg, old deck 0.93296 kg, subtotal 5.3052384 kg. New profiles 4.888 kg, new deck 1.37088 kg, subtotal 6.25888 kg. Increase 0.9536416 kg within this limited scope. Not a complete frame or vehicle mass.

## Equipment and gripper

- Arm front centre; Orin Nano middle; battery rear, resting on its largest face on the acrylic deck. Lower installation height and balancing the front arm are design intentions, no measured balance.
- User confirms transport posture: arm extends, downward-facing gripper takes the bowl, then holds its pose relative to the vehicle during transport. Bowl remains suspended. No arm retraction, active levelling or active vibration compensation implemented.
- Arm retains a 2 mm cold-rolled steel base. Six outer bolts fix it to acrylic deck. Hole span 230×140 mm; plate outline and steel grade unknown.
- Acrylic chosen mainly for ease of fabrication.
- Four-finger parts use PLA 3D printing; steel arm adapter; rubber bowl-contact pads. Chosen for low cost, convenient manufacture and intended end-effector mass reduction.
- Gripper manufactured, not installed or load-tested. Supplier CAD is a reference model, not a photo of team manufacture. Team contribution is adapted mounting interface, not whole gripper invention.
- All four wheels have spring-damper units of the same stated dimensions, not proven equal rates. Rear belt-driven modules: supplier 6374 outrunner, 1000 W each, 36–48 V, 8-inch pneumatic tyre, claimed 45 km/h. No achieved vehicle-speed claim.
- 48 V battery is planned only. Capacity, current capability, chemistry and model not selected. Controller advertisement: up to 16S/67.2 V and 70 A, 95×70 mm; electrical meanings and purchased variant unverified.
- Smooth starts/stops and secure gripping are planned. No measured vibration reduction.

## Suspension connection and analysis boundary

- Support bolt locations reported about 40 mm from rail ends, giving approximately 720 mm longitudinal support spacing. This is not verified wheelbase.
- Corrected from one bolt per module to four mounting holes in a 2×2 pattern.
- Initial proposal was tapping into the profile's thin wall. This has NOT been accepted as adequate.
- User accepted a metal adapter approach with anti-rotation location, to be fitted/verified before fabrication. Exact plate thickness, hole layout, fastener specification and section-local strength remain open. Deck must not be treated as the suspension bracket.
- 100 kg load rating was admitted to be a guess. 40 kg equipment mass also unsubstantiated. Neither is a measured/design-approved load.
- Prior calculations are conditional beam-screening examples only, with assumed 6063-T5, simple supports, equal rail load, chosen factor 2 and 2 mm deflection. They do not validate complete-frame strength, joints, PMMA, or dynamic use, and are omitted from the deck's headline claims.

## Latest assembly status and evidence

- User now confirms frame assembled. Arm/gripper installation incomplete. No new assembly photographs received in this turn; V2 keeps CAD and labels it as design evidence.
- User previously expected frame, arm and gripper photographs before Week 9.
- No actual complete-mass, gripping load, vibration or vehicle-speed results supplied.
- The latest assembled-frame confirmation supersedes the 23 October anticipated-delivery status. It does not establish whole-vehicle operation.

## Images and sources

- image-01.png: P4 chassis isometric CAD, reference.
- image-02.png: current conversation arm-on-deck CAD, reference.
- image-03.png: old frame CAD with uprights and braces.
- image-04.png: P4 updated-frame plan CAD, reference.
- image-05.png: arm steel-base CAD, outer six-hole arrangement.
- image-06.jpg: supplier four-finger model, reference.
- image-07.png: supplier rear suspension-drive module, unverified performance claims remain supplier claims.
- External material/engineering sources are cited in each slide's notes and the bilingual script.

## Review corrections

- Repaired embedded images using concrete data URLs; original source bytes preserved.
- Slide 5 footnote moved below table; steel adapter not assigned an unconfirmed cold-rolling process.
- Slide 10 says weigh revised frame and reconcile complete BOMs, since old hardware existence is unknown.

## V2 graphics

Native editable engineering schematics show approximate front/middle/rear equipment layout, a mechanical disturbance transmission path, and all eight pad support locations. Footprints and pad positions are explanatory, not released fabrication drawings. Four-corner pad sizing and crossmember height facts follow user confirmations.
