Lurk0526/autonomous-water-transport-robot/docs/sources/p5/frame_mass_recalculation_confirmed.md

# 第四页质量重算：已确认输入

## 本次用户更新（2026-10-25）

- 原第二页删除，等待统一改稿时执行。
- 旧版型材全部是4545，用户确认与现版4545横梁同款，米重1.50 kg/m；覆盖此前4040及0.94 kg/m的记录。
- 新版两根6060纵梁分别从800 mm切短至650 mm。
- 新亚克力铺板同步改为650×360×4 mm。
- 保留此前确认的旧版长度清单、旧铺板尺寸、新版三根240 mm横梁以及6060米重2.38 kg/m。

## 计算

旧版型材总长=(840+2×760+4×310+4×140+8×61.42)/1000=4.65136 m。

旧版型材=4.65136×1.50=6.97704 kg。

新版型材=2×0.650×2.38+3×0.240×1.50=4.17400 kg。

沿用亚克力参考密度1190 kg/m³：旧铺板=2×0.560×0.175×0.004×1190=0.93296 kg；新铺板=0.650×0.360×0.004×1190=1.11384 kg。

| 统计项 | 旧版 | 新版 | 新减旧 |
| --- | ---: | ---: | ---: |
| 型材 | 6.977 kg | 4.174 kg | -2.803 kg |
| 亚克力铺板 | 0.933 kg | 1.114 kg | +0.181 kg |
| 小计 | 7.910 kg | 5.288 kg | -2.622 kg |

同一统计范围内估算减量2.622 kg，约33.15%。仅型材减量2.803 kg，约40.18%。

## 后续PPT同步修订

- 旧第4页及质量计算备用页更正全部数据，原“5.31→6.26 kg”和“尚未减重”的结论已被最新输入取代。
- 建议标题改为：A shorter, simpler frame reduces estimated mass。正文可用7.91→5.29 kg；减重约2.62 kg、约33%，旁注明Profiles + acrylic only / calculated estimate。
- 页面删减后统一重排页码和备注，不提前修改当前PPT。
- 新版650 mm车架的设备布置和图示需要同步核对。现有800 mm CAD不得无说明作为650 mm尺寸证据，也不通过拉伸图片伪造更新后的几何。
- 不沿用原约720 mm悬挂支撑间距；新孔位与间距未提供。
- 全部质量是供应商米重、几何尺寸及参考密度的计算估算，未包含角码、螺栓、槽内螺母、其他安装件、橡胶垫或车载设备，不能称为整车减重约33%。
