Lurk0526/autonomous-water-transport-robot/docs/sources/p5/revision_v4_current_basis.md

# V4 current authority — 2026-10-25

User authorised the accumulated edits with 开始优化ppt吧. This file and the confirmed calculations supersede older materials where they conflict.

Old frame: all 4545 at 1.50 kg/m, historical lengths unchanged. New frame: two 650 mm 6060 rails at 2.38 kg/m plus three 240 mm 4545 crossmembers; acrylic now 650×360×4 mm. Estimated profiles plus acrylic: 7.910→5.288 kg, −2.622 kg (33.15%); no complete-vehicle claim.

Delete old slide 2. Retain and refocus load-distribution page: use existing rear battery mass to balance the front arm/bowl and avoid dedicated ballast. Do not claim measured avoided ballast. Add separate 48 V 20 Ah versus 40 Ah battery selection. The user prefers 20 Ah for short acceleration peaks; 30 A continuous confirmed, ≤60 A peak advertised with duration unresolved. Treat suitability as proposed sizing within the stated duty envelope, not validated load/energy sufficiency. No measured pack weights.

Add suspension page using suspension_selected.jpg supplied in the authorising message, replacing the earlier proposed suspension photo. Preliminary four equal springs: 6 N/mm. Mass 15–20 kg and wheel travel 50 mm are estimates. r=0.7, uniform corner loads and no preload are explicit modelling assumptions. Calculated wheel rate 2.94 N/mm; sag 12.5–16.7 mm (about25–33%). This is an illustrative preliminary selection, not an optimised or tested suspension.

13 slides: 11 main and 2 backup. English presentation with bilingual notes and expanded Q&A. Former full-vehicle CAD is a component-arrangement concept; new native schematics carry the 650 mm dimensions without distorting source CAD.
