Lurk0526/autonomous-water-transport-robot/docs/sources/p5/suspension_preliminary_choice_6Nmm.md

# 悬挂弹簧：汇报初选值

用户授权在缺少运动测量的情况下，选一个计算自洽、与最终实物可不同的汇报方案。

初选：四根同规格线性弹簧，每根k=6 N/mm（6000 N/m）。该值为设计选择，不是实测值。

计算假设：整车15–20 kg为用户估算，暂全部按簧载质量四轮均分；轮端总行程50 mm为用户估算；运动比r=弹簧压缩量/轮心垂直位移，暂取0.7，明确为未测量的设计假设；忽略预载、摩擦和局部几何非线性。

轮端等效刚度kw=6×0.7²=2.94 N/mm。

15 kg时单轮负载36.7875 N，静态下沉12.5128 mm，占50 mm的25.03%。
20 kg时单轮负载49.05 N，静态下沉16.6837 mm，占50 mm的33.37%。

汇报可取整：静态下沉约13–17 mm，约占总行程25–33%，留下约33–37 mm上跳行程。这里只是静态初筛，不能推出越野不触底或减振效果已经验证。

建议英文：Preliminary spring selection: 6 N/mm per wheel. With an assumed motion ratio of 0.7, the estimated static sag is 13–17 mm for a 15–20 kg vehicle. This balances compliance with remaining bump travel; the final spring and damping setup will be tuned on the assembled vehicle.

PPT只保留初选值、简短依据和假设说明；详细式子放备注或备用页。四根同k不代表真实四轮轮荷相同。预载改变车高/工作点，不改变线性弹簧k。

仍等待统一改稿指令，当前不改PPT。
