Lurk0526/autonomous-water-transport-robot/docs/sources/p5/user_update.md

# P5 rebuild: direct user update, 2026-10-24

- Six supplied images archived unchanged. Images 1–5 are CAD; image 6 is a gripper photograph.
- Equipment-deck rubber pads are not installed. User confirms the previously discussed arrangement will be used.
- Rail-corner pad plan dimensions change from 50×50 mm to 60×60 mm.
- Crossmember pad plan dimensions change from 40×40 mm to 45×45 mm.
- User explicitly confirms thicknesses remain unchanged: four rail-corner pads 60×60×5 mm; four crossmember pads 45×45×15 mm. Locations unchanged. This supersedes the old pad dimensions in the V1/V2 source records.
- Do not infer installation, preload, isolation performance, loaded grasping, or complete-vehicle operation from these images.

## Gripper printing clarification

- User states the gripper is solid printed. Detailed slicing settings, wall thickness/perimeter count are unknown. Treat solid printing as user-reported; do not infer exact slicer settings such as 100% infill.
- Remove hollow/internal-infill lightweighting claims from the planned manufacturing slide.
- Separate material choice (PLA: user reasons are low cost, fabrication convenience, intended reduction of end-effector mass) from process choice (3D printing for custom geometry and interface adaptation).
- Neither solid printing nor additive manufacturing alone establishes mass reduction or adequate load capacity. Do not claim topology optimization, optimized infill, measured mass saving, or team invention of the full supplier-based gripper.
- User requests a defensible explanation on each of the four guideline slides: functional need, selection rationale, connection to lightweighting, supporting evidence, and trade-offs.

## Gripper mass clarification

- User estimates approximately 250 g from memory for the gripper assembly, including servo(s), links and fasteners. This is not a scale measurement.
- Steel adapter mass is unknown and excluded from that estimate.
- Do not present 250 g as measured mass, use it to calculate a reported lightweighting percentage, or claim load capacity. Omit the estimate from main-slide quantitative evidence; retain this provenance for any later calculation.
- A nominal 650 g bowl/water payload plus the estimated gripper mass would be approximately 900 g before the adapter; this is only a preliminary load inventory, not a tested capacity or a verified design load.
