Lurk0526/autonomous-water-transport-robot/reports/p3/AstraGO_P3_20261010.pptx

AUTOMOTIVE DESIGN / GROUP 2

P3 · DETAILED DESIGN

AstraGO

Autonomous water
transport vehicle

From layout to mechanical detail.

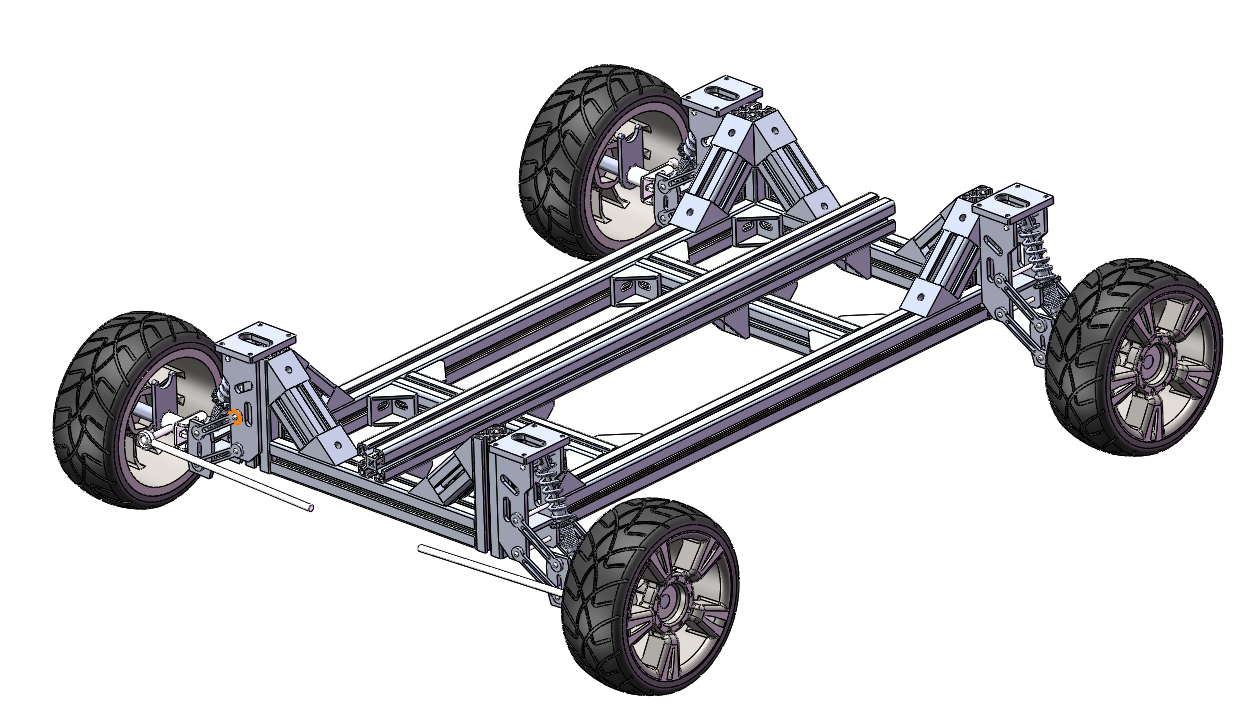
[picture p7: figure]

Current team chassis CAD · Arm and electronics to be integrated

Frame · Running gear · Arm integration

4040

1

level

2

motors

profile

AstraGO / P3 / 2026

01

Notes: Good morning. Today we present the detailed design of AstraGO, our autonomous water transport vehicle. It uses a single-level frame made from forty-by-forty millimetre aluminium profiles and two independently driven rear wheels. This is our current chassis CAD model, before arm and electronics integration. I will explain the mechanical design, our Orin Nano debugging progress, and the remaining integration work.

大家好，今天我们汇报 AstraGO 自动运水车的详细设计。我们采用单层 4040 铝型材车架，两个后轮分别由独立电机驱动。图中是目前的底盘 CAD 模型，尚未加入机械臂和电子设备。接下来，我会介绍机械结构、Orin Nano 的调试进展，以及后续需要完成的集成工作。

## Slide 2

One frame level. One geometry baseline.

01 / FRAME GEOMETRY

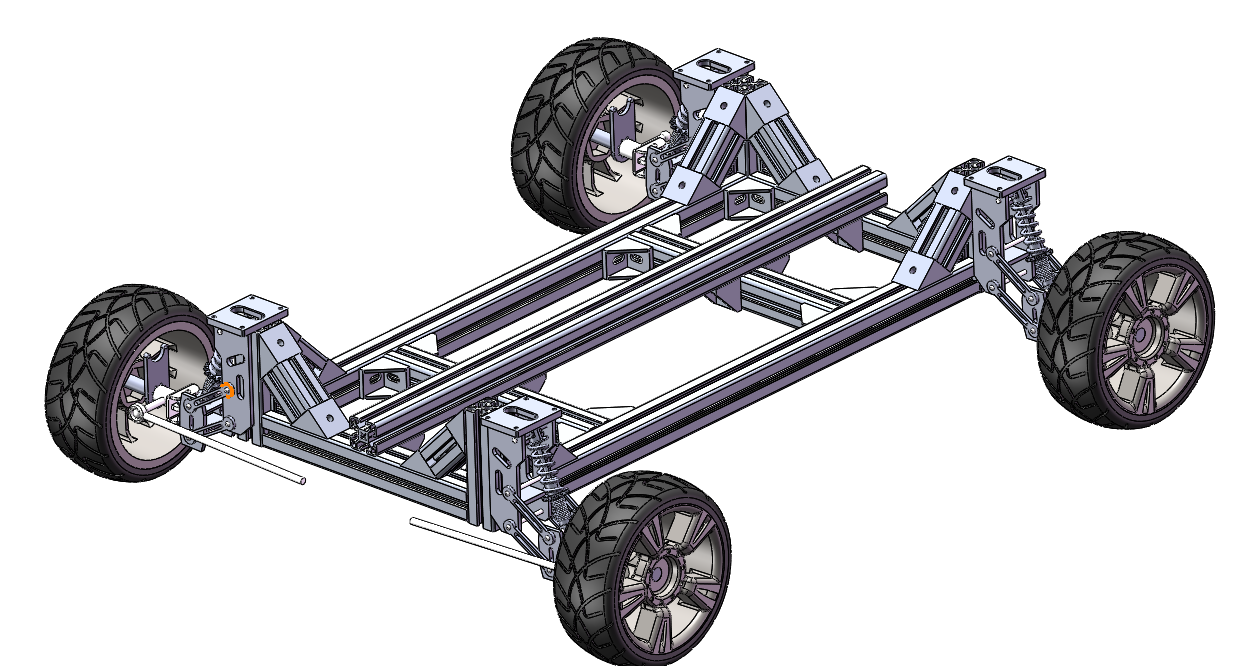
[picture p8: figure]

Frame footprint ≠ complete vehicle envelope.

CONFIRMED CONSTRUCTION

40 × 40 mm

Single-level aluminium frame

LEGACY DIMENSIONS · TO CONFIRM

Frame plan: 800 × 350 mm

Track: 750 mm

Ground clearance: 100 mm

New height and tyre OD: open

Source: team CAD and legacy P2 dimension sheet. Old two-level heights are not transferred.

02

Notes: The frame is now single-level, using forty-by-forty profiles. The earlier drawing gives an eight-hundred-by-three-hundred-and-fifty millimetre frame plan, a seven-hundred-and-fifty millimetre track, and one hundred millimetres of ground clearance. These dimensions still need checking against the updated CAD. We have not transferred the old two-level heights or tyre diameter. The frame footprint is also different from the complete vehicle envelope, which includes the wheels, suspension, arm and bowl.

现在车架已经确定为单层 4040 型材。旧图中的车架平面尺寸是 800×350 毫米，轮距是 750 毫米，离地间隙是 100 毫米，这些数值还需要与更新后的 CAD 核对。原来双层结构的高度和轮径没有直接沿用。另外，车架平面尺寸不等于整车外廓，还需要考虑轮胎、悬架、机械臂和水碗伸出的范围。

## Slide 3

Carry loads through the rails and joints.

02 / FRAME & CONNECTIONS

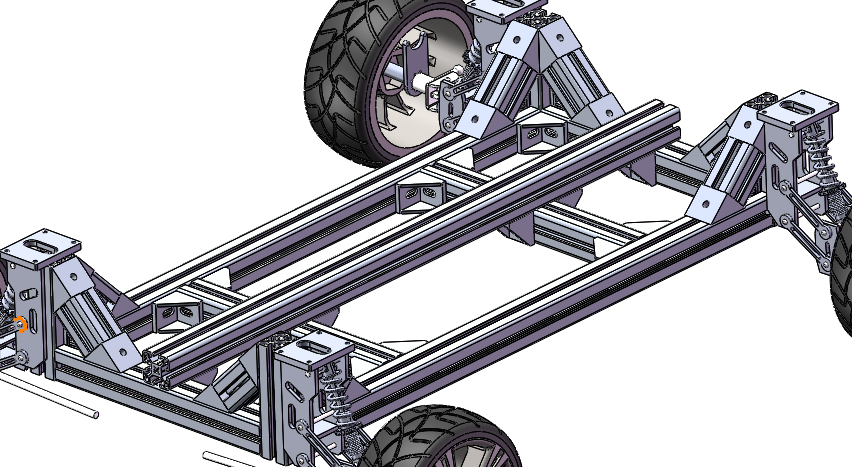
[picture p9: figure]

Longitudinal rails

Main supports for the
equipment and arm mount.

Crossmembers

Connect the rails and locate
the mounting interfaces.

Brackets & fasteners

Define hole patterns, plate
thickness and joint restraint.

Design check: arm mount → crossmembers → main rails

Source: team CAD detail. Mounting and joint checks are proposed work, not completed strength verification.

03

Notes: This detail shows the frame connections. The longitudinal rails support the equipment, while crossmembers connect the rails and provide mounting locations. Brackets and braced supports connect the wheel modules. Our proposed arm adapter should distribute its load across both rails through the crossmembers. Next, we need to define hole patterns, plate thickness and fasteners. The profile size alone does not establish the strength of the assembled frame.

这张局部图展示车架的连接方式。纵梁承担设备载荷，横梁连接两侧纵梁，并提供安装位置。轮端模块则通过支架和斜撑接入车架。机械臂转接件计划通过横梁，把载荷分散到两侧纵梁。下一步需要确定孔位、板厚和紧固件，不能仅凭型材尺寸，就认定整个车架的强度已经满足要求。

## Slide 4

Steer at the front. Allow wheel travel.

03 / SUSPENSION & STEERING

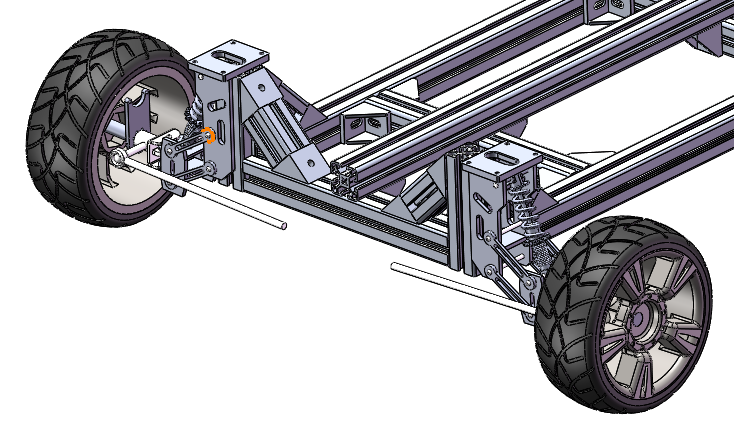
[picture p10: figure]

Two motions to check

Suspension: vertical wheel travel
Steering: front wheel angle

Front servo and final linkage geometry
remain to be selected and checked.

CHECK THE COMBINED ENVELOPE

Bump + rebound + steering
Tyres, linkage, brackets and cables

Source: team CAD. Rear carriers must retain wheel direction while allowing suspension movement.

04

Notes: The front assembly must accommodate suspension travel and steering together. We need to check bump, rebound and steering extremes for interference between tyres, linkage, brackets and cables. The steering servo and final linkage geometry remain open. At the rear, the carriers must retain wheel direction while allowing suspension movement. The CAD shows our current arrangement; checking the combined motion envelope is the next step.

前轮总成需要同时满足悬架运动和转向。我们要检查悬架压缩、回弹以及极限转向角度下，轮胎、连杆、支架和线缆之间是否干涉。转向舵机和最终连杆几何尚未确定。后轮轮座则需要在允许悬架运动的同时约束车轮朝向。这里展示的是当前布局，下一步要检查这些运动叠加后的空间范围。

## Slide 5

A compact drive module at each rear wheel.

04 / REAR DRIVE MODULE

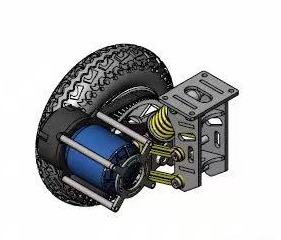
[picture p11: figure]

SPECIFICATIONS SHOWN IN SUPPLIER IMAGE

Brushless outrunner motor

6374

1000 W

Listed motor power

36–48 V

Listed voltage range

8-inch pneumatic wheel · Belt transmission

45 km/h is a supplier claim.

Vehicle speed has not been measured.

Source: user-supplied supplier module drawing and product graphic. Electrical configuration still needs checking.

05

Notes: Each rear wheel uses this compact drive module. The supplier identifies a sixty-three-seventy-four brushless outrunner motor, with one thousand watts of listed power, thirty-six to forty-eight volts, and an eight-inch pneumatic wheel. These are supplier specifications. The advertised forty-five kilometres per hour is not a measured speed for our vehicle. We still need the exact motor configuration and compatible controller details before integration.

两个后轮分别采用这种紧凑的驱动模块。商家标注的电机是 6374 无刷外转子，功率为 1000 瓦，电压为 36 到 48 伏，配有 8 寸充气轮。这些数值来自商家资料，其中宣传的最高时速 45 公里，并不是我们整车的实测速度。集成前还需要确认电机的具体配置，以及兼容的控制器参数。

## Slide 6

Trace power from the motor to the wheel.

05 / POWER TRANSMISSION

Motor pulley

Drive belt

Wheel pulley + wheel

One independent path per rear wheel

Confirm pulley teeth, alignment and belt tension.
Check belt geometry through suspension travel.
Allow different left / right wheel speeds in a turn.

Wheel rpm = motor rpm / belt ratio

Ratio and loaded motor speed are still unconfirmed.

Source: supplier module drawing. Functional transmission path; no assumed pulley ratio or vehicle speed.

06

Notes: Power passes from the motor pulley, through the belt, to the wheel pulley. Each rear wheel has an independent drive path. Wheel speed equals motor speed divided by the transmission ratio, so pulley teeth counts and loaded motor speed must be confirmed. We also need to check belt alignment and tension through suspension travel. During turns, the control system must allow suitable differences between the left and right wheel speeds.

动力从电机带轮经过皮带，传到车轮侧带轮，左右后轮各有独立的传动路径。轮速等于电机转速除以传动比，因此还需要确认带轮齿数和电机的带载转速。同时，要检查悬架运动过程中皮带的对齐和张紧情况。转弯时，左右后轮经过的路径长度不同，控制系统也需要允许两侧轮速合理变化。

## Slide 7

Use the selected arm. Design the integration.

06 / ROBOTIC ARM

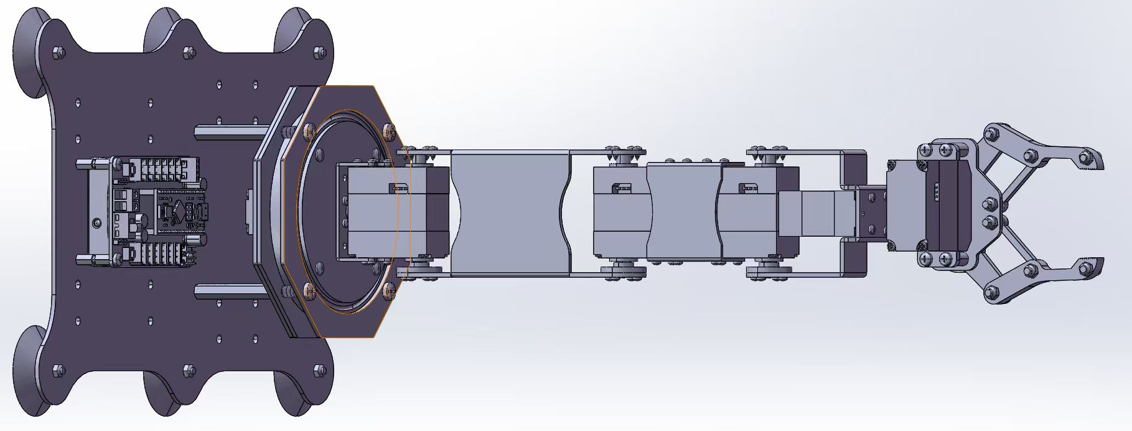
[picture p12: figure]

Zhongling Technology open-source arm

Supplier's original model shown

Custom four-finger gripper

CAD model in progress

Source: user-supplied Zhongling Technology arm CAD. Exact model, reach, payload and interfaces still to verify.

07

Notes: We selected a Zhongling Technology open-source robotic arm. This is the supplier's original model, including its two-jaw gripper. Our team will design a four-finger gripper, but that CAD model is not complete yet. We still need to verify the arm's exact version, working reach, payload and control interface. Our integration work focuses on mounting the arm, developing the gripper and choosing a compact transport posture.

我们选择了众灵科技的开源机械臂。这里是商家提供的原装模型，末端仍是原装两爪。我们准备自行设计四爪夹具，但四爪 CAD 目前还没有完成。后续需要核实机械臂的具体版本、工作范围、负载能力和控制接口。我们的集成重点是机械臂安装、夹具设计，以及适合运输的紧凑姿态。

## Slide 8

The bowl stays held throughout transport.

07 / CUSTOM GRIPPER

Original two-jaw model · reference only

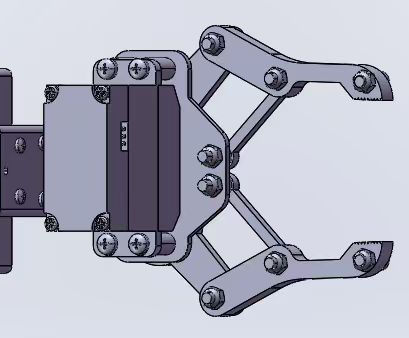
[picture p13: figure]

Our design: four fingers, top-down grasp

Custom CAD model in progress

156 mm

Maximum bowl diameter

≈0.65 kg

Bowl + water only

Add gripper and adapter mass to the arm load.
No vehicle tray; continuous grip during transport.

Locate

Descend

Grip

Test lift

Hold & transport

Place

Source: supplier's original arm model + team gripper plan and bowl requirements. Four-finger geometry is not yet complete.

08

Notes: Our four-finger gripper will approach the bowl from above. The maximum bowl diameter is one hundred and fifty-six millimetres, and the bowl plus water weighs about zero point six five kilograms. Gripper and adapter mass must also count toward the arm's load. The sequence is locate, descend, grip, test lift, transport and place. Throughout transport, the arm must keep holding the bowl, without a vehicle tray supporting it.

我们计划让四爪夹具从上方接近水碗。水碗最大直径为 156 毫米，碗和水合计约 0.65 千克。机械臂的负载还要加上夹具和转接件的重量。动作顺序是定位、下降、夹紧、小幅试提、运输和放置。整个运输过程都由机械臂持续夹持，不使用车载碗托承重。

## Slide 9

Make the arm mount part of the chassis.

08 / ARM MOUNTING INTERFACE

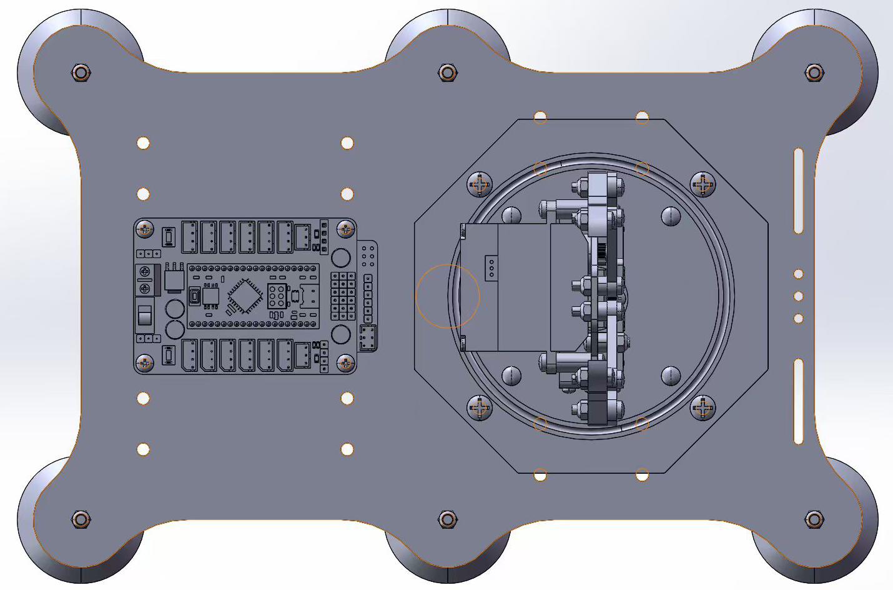
[picture p14: figure]

Bridge both frame rails

Design an adapter plate around
the actual base hole pattern.

Check the working envelope

Reach the platform and bowl.
Keep a compact transport pose.

Keep access for service

Board, fasteners and cable routing.

Final mounting position, plate thickness and fasteners remain to be defined.

Source: user-supplied arm base CAD. Existing holes and controller layout are references, not verified vehicle interfaces.

09

Notes: We propose an adapter plate bridging both frame rails, designed around the arm base's actual hole pattern. Its location must provide access to the platform and bowl, while allowing a compact transport posture. The board, fasteners and cables also need service access. Mount position, plate thickness and bolt arrangement remain to be defined, considering the changing load and reach as the arm moves.

我们计划根据机械臂底座的实际孔位，设计连接两侧纵梁的转接板。安装位置既要保证机械臂能够到达平台和水碗，也要允许它在运输时收拢。同时，还要保留控制板、紧固件和线缆的操作空间。最终位置、板厚和螺栓布置，需要结合机械臂运动时不断变化的载荷和工作范围来确定。

## Slide 10

Orin Nano bench debugging is underway.

09 / COMPUTING & SYSTEM INTERFACES

Our actual bench setup · Debugging in progress

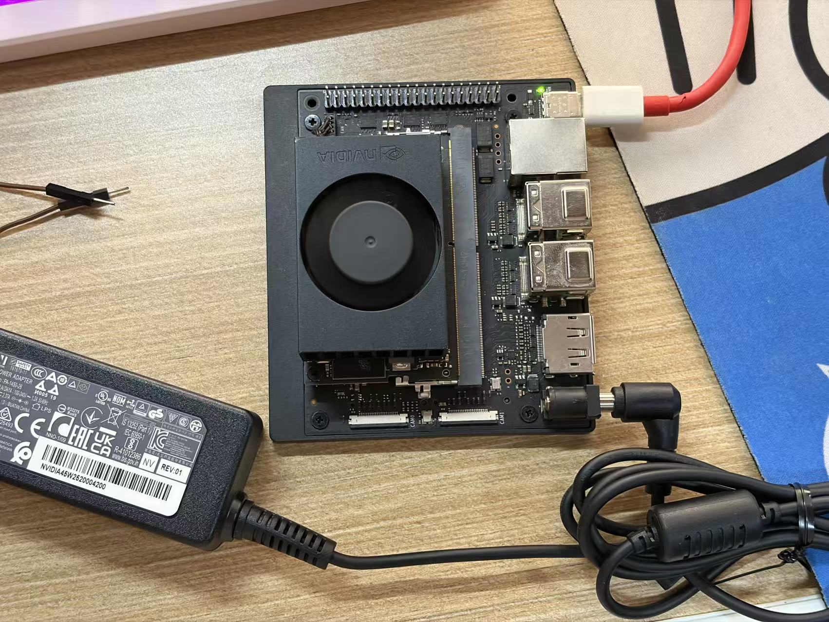
[picture p15: figure]

Jetson Orin Nano

Planned: perception + path planning

Vehicle supply and actuator interfaces: next

PROPOSED POWER CONNECTIONS

Rear drive controllers

Suitable arm supply

Regulated auxiliaries
Orin + other devices

Battery

+ protection

Battery, controllers, servo and cameras:
selection still open.

Source: team bench-debugging photograph. Vehicle integration and autonomous operation remain to be verified.

10

Notes: We have started bench debugging of the Jetson Orin Nano. This photograph shows our actual setup. Its planned role is perception and path planning; vehicle integration comes next. The proposed battery and protection system will supply the rear drive controllers, arm and regulated auxiliaries, including the Orin. Battery, controller, servo and camera choices remain open. Before connecting them, we must confirm power requirements, commands, feedback and fault handling. Debugging is underway; autonomous operation has not yet been verified.

我们已经开始调试 Jetson Orin Nano，照片展示的就是实际调试现场。它计划负责感知和路径规划，下一步再接入整车。供电方面，拟由电池和保护系统向后轮驱动器、机械臂，以及包括 Orin 在内的辅助稳压电路供能。电池、控制器、舵机和相机仍未最终确定，连接前需要核实供电要求、指令、反馈和故障处理方式。目前正在进行调试，整车自主运行尚未得到验证。

## Slide 11

Verify the interfaces, then integrate.

10 / VERIFICATION & NEXT WORK

1

2

3

4

Geometry

Drive module

Loaded arm

Integration

Dimensions
Mounting holes
Motion clearances

Belt alignment
Tension through travel
Wheel support

Platform reach
Four-finger grip
Continuous hold

Power interfaces
Low-speed steering
Controlled stop

Checked CAD · Measured interfaces · Loaded-grip video · Low-speed test logs

Evidence for the next review

Planned verification sequence. CAD screenshots and supplier specifications are not completed physical tests.

11

Notes: Our next steps are to confirm CAD dimensions and mounting clearances, check belt tension and wheel support, then test arm reach and continuous gripping with the intended load. After confirming the power interfaces, we will perform low-speed steering and controlled-stop tests. Evidence for the next review should include checked CAD, measured interfaces, a loaded-grip video and test logs. These are planned checks, not completed test results.

下一步，先确认 CAD 尺寸和安装空间，再检查皮带张紧和车轮支撑，然后在预期载荷下测试机械臂的可达性与持续夹持能力。核对供电接口后，再开展低速转向和受控停车测试。下一次汇报应提供检查后的 CAD、接口实测尺寸、带载夹持视频和测试记录。这些是接下来要完成的验证，并不是已经取得的测试结果。

## Slide 12

A defined chassis. Clear integration work.

ASTRAGO / P3

Single-level 4040 frame

Independent rear belt drives

Selected open-source arm

Custom four-finger gripper: CAD in progress

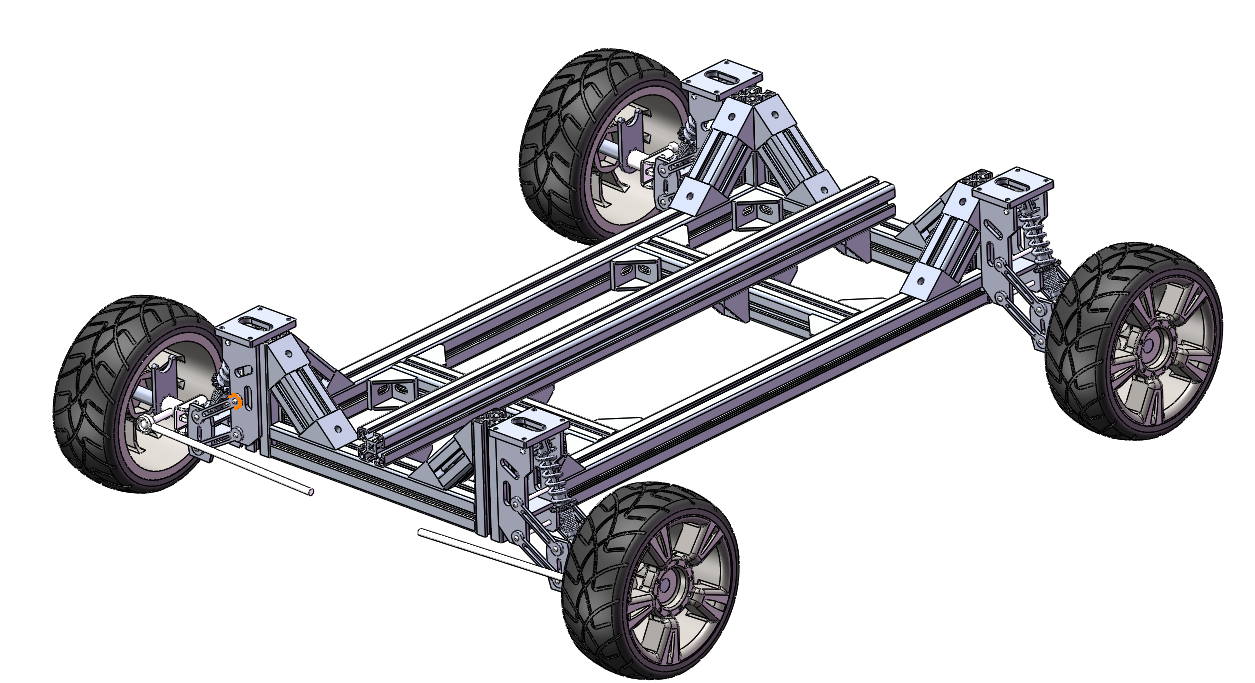
[picture p16: figure]

Checked mounts, reliable grip
and compatible interfaces.

NEXT MILESTONE

Questions & Discussion

Automotive Design / Group 2

12

Notes: Our design now combines a single-level forty-by-forty frame, independent rear belt drives and a selected open-source arm. The four-finger gripper is still being modelled, and Orin Nano debugging has started. Our next milestone is checked mounts, reliable gripping and compatible interfaces. Thank you. We welcome your questions.

目前，我们的方案采用单层 4040 车架、左右独立的后轮皮带驱动，以及选定的开源机械臂。四爪夹具还在建模，Orin Nano 已开始调试。下一阶段的目标是确认安装结构、验证可靠夹持，并打通各系统接口。谢谢，欢迎老师提问。
