Lurk0526/autonomous-water-transport-robot/reports/p5/AstraGO_P5_UserEdit_20261026.pptx

AstraGO

Lightweight design & vibration isolation

Carry the task.
Justify the choices.

Materials · Structure · Layout
Manufacturing · Battery sizing

GROUP 2 / WEEK 9
Automotive Design + Vehicle Materials


Assembly concept / component arrangement

P5 / DESIGN RATIONALE

01

Notes: Good morning. We are Group Two. AstraGO transports an open water bowl through continuous robotic gripping. Our design combines lightweight construction with vibration control, focusing on material selection, frame geometry, load distribution, manufacturing and battery sizing.

大家好，我们是第二组。AstraGO通过机械臂持续夹持敞口水碗完成运输。我们的设计将轻量化与振动控制结合，重点介绍材料选择、车架结构、载荷分布、制造方法和电池容量。

## Slide 2

Different jobs need different materials

01 / MATERIAL SELECTION

Aluminium profiles

Low-density, modular frame construction.
Profile geometry combines support and mounting.

Easy cutting and drilling for equipment mounting.

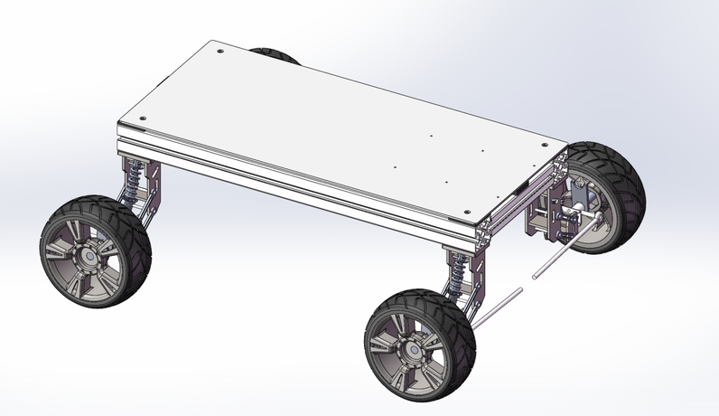
[picture p23: figure]

Acrylic deck

PLA fingers

Low-cost custom fingers.
Lightweight material
for the arm-end design.

Retain and adapt the arm connections.
Use metal where the mounting interface needs it.

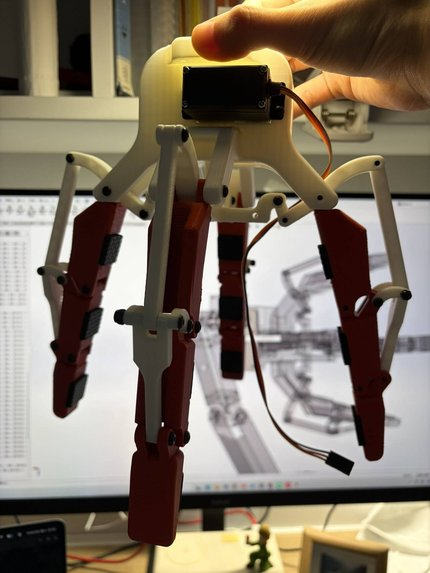
[picture p24: figure]

Steel interfaces

Material selection: Match each material to its role, geometry and manufacturing needs.

02

Notes: Each material serves a specific function. Aluminium profiles provide a low-density frame with reusable mounting slots. PLA enables low-cost custom fingers and supports our lightweight arm-end design. Steel is concentrated at the arm interfaces to retain the required connections. Acrylic makes the equipment deck convenient to cut and drill. This combination considers material, geometry and manufacturing together, giving each part a clear role in the vehicle.

每种材料承担明确功能。铝型材提供低密度车架和可重复使用的安装槽；PLA便于低成本制作定制夹指，服务于末端轻量化设计；钢件集中用于机械臂接口，保留所需连接；亚克力便于铺板切割和钻孔。这样的组合把材料、几何和制造方式一起考虑，让每个部件各司其职。

Sources: European Aluminium, https://european-aluminium.eu/wp-content/uploads/2022/11/aam-design-2-design-with-aluminium.pdf ; Prusa, https://help.prusa3d.com/article/pla_2062 .

## Slide 3

A shorter, simpler frame reduces mass

02 / STRUCTURE AND CONNECTIONS

PREVIOUS / ALL 4545 PROFILES

19 profile pieces / 18 brackets

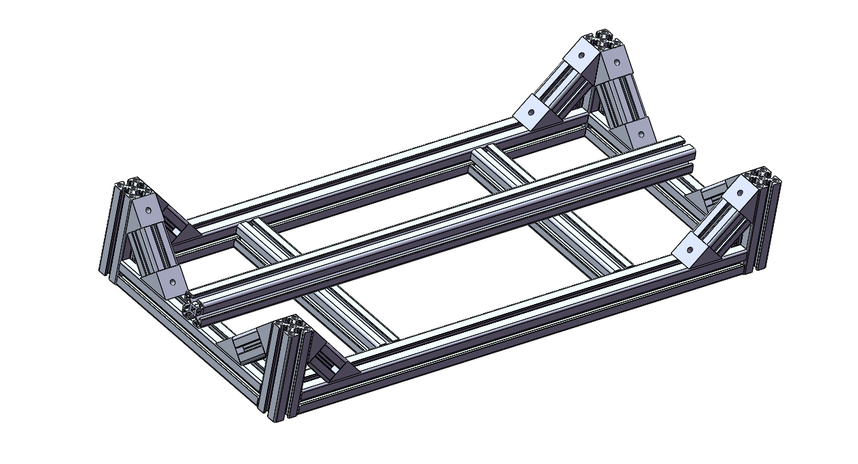
[picture p25: figure]

REVISED / SINGLE LAYER

3 × 240 mm 4545 crossmembers

650 × 360 mm plan schematic

650 mm

2 × 650 mm 6060 rails

Remove uprights and braces; shorten both rails by 150 mm. Revised: 5 pieces / 8 brackets.

7.91 → 5.29 kg

Calculated profiles + acrylic

−2.62 kg / about 33%

Same comparison scope; larger deck partly offsets profile savings.

03

Notes: The frame provides our main calculated weight reduction. The original design used forty-five-millimetre profiles throughout. We removed the uprights and braces, reducing profile pieces from nineteen to five and brackets from eighteen to eight. Both longitudinal rails were shortened from eight hundred to six hundred and fifty millimetres, together with the deck. Calculated profiles plus acrylic decrease from seven point nine one to five point two nine kilograms, a saving of about two point six two kilograms, or thirty-three percent.

车架是主要的计算减重来源。旧版全部采用4545型材，我们取消立柱和斜撑，型材从19件减少到5件，角码从18个减少到8个。两根纵梁由800毫米缩短到650毫米，铺板同步缩短。型材与亚克力的计算质量由7.91公斤降到5.29公斤，减少约2.62公斤、约33%。

Calculation scope: aluminium profiles + acrylic deck. Supplier linear masses: 4545 1.50 kg/m, 6060 2.38 kg/m. Acrylic reference density: 1190 kg/m³.

## Slide 4

Use battery mass to avoid extra ballast

03 / LOAD DISTRIBUTION

One necessary component, two functions

Equipment arrangement schematic; 650 mm frame revision.

Battery

Power + balance

Arm

Front load

Orin

REAR

FRONT

Lightweighting mechanism: make existing equipment perform the balancing function.

Layout objective: combine energy storage and load balance in one necessary component.

04

Front arm and suspended bowl

Create a front-biased loading tendency.

Position the battery at the rear

Use required mass to balance the load.

Avoid a dedicated ballast block

Balance through placement,
without adding mass just for balance.

Notes: The battery also contributes through its position. The front arm and suspended bowl place load towards the front, so we position the battery at the rear to help balance them. One necessary component then performs two functions: energy storage and load balance. This is our approach to avoiding a separate ballast block and the extra mass added solely for balance.

电池的位置也参与轻量化设计。前端机械臂和悬空水碗使载荷趋向前部，因此把电池放在后端参与平衡。这样一个必需部件同时承担储能和配重两个功能，目标是避免专门增加配重块，省去只为平衡而增加的质量。

## Slide 5

Print the custom geometry we need

04 / ADVANCED MANUFACTURING

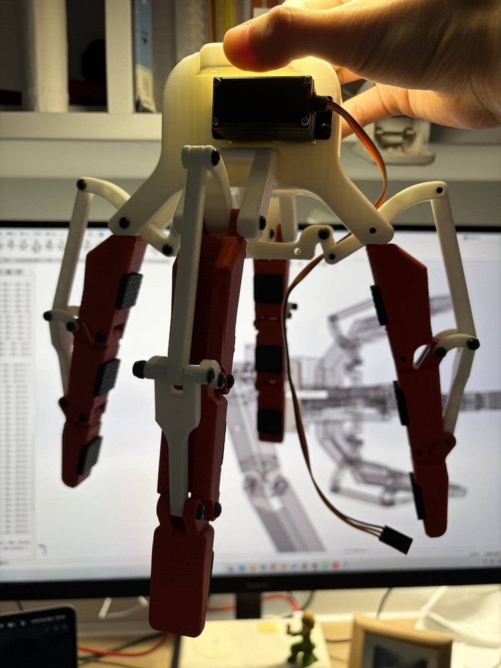
[picture p26: figure]

gripper

Why this process?

Small-batch finger and linkage geometry.

Low-cost fabrication and interface adaptation.

Adapt the gripper to our arm.
Team-developed mounting-interface adaptation.

Solid PLA + rubber contact pads

PLA forms the fingers; printing delivers the custom geometry.
Rubber contact pads support secure bowl contact.

2025 reference: Fraunhofer IWU + MOSOLF printed Vito shelf.
Design lesson: combine geometry with mounting functions.

05

Notes: Three-dimensional printing suits our small batch and custom finger geometry. We adapted the supplier-based mechanism at its arm interface. Solid PLA forms the fingers, while rubber pads provide bowl contact. A 2025 Fraunhofer IWU and MOSOLF vehicle shelf shows how integrated printing can reduce extra attachments. The useful principle is to consider geometry and mounting together.

3D打印适合我们的小批量定制夹指。我们在商家机构基础上适配机械臂接口，实心PLA形成夹指，橡胶垫用于接触水碗。Fraunhofer IWU与MOSOLF在2025年的汽车置物架案例表明，集成打印能够减少额外安装件。我们借鉴的是将几何形状与安装功能一起考虑的原则。

Source: Fraunhofer IWU, 12 November 2025. https://www.iwu.fraunhofer.de/en/press/2025-fraunhofer-iwu-experts-present-new-materials-for-additive-manufacturing-at-their-self-printed-booth.html

## Slide 6

Match battery capacity to the duty cycle

05 / BATTERY CAPACITY SELECTION

48 V / 20 Ah

DESIGN SELECTION

960 Wh · 30 A continuous

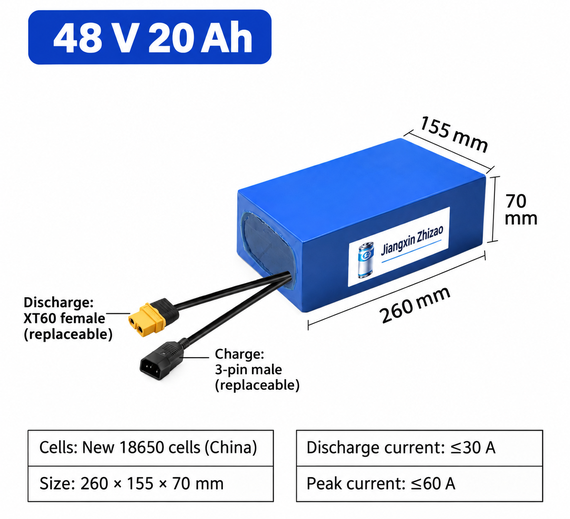
[picture p27: figure]

48 V / 40 Ah

LARGER-CAPACITY OPTION

1920 Wh · peak ≤100 A

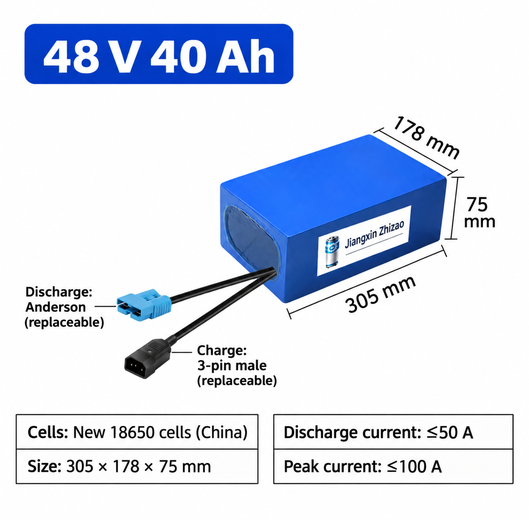
[picture p28: figure]

2 × 1000 W is peak demand

Used briefly during hard acceleration.

Peak-demand calculation

2000 W ÷ 48 V ≈ 41.7 A

Basis: 2 kW traction electrical input at 48 V.

20 Ah pack: specified peak ≤60 A.

Choose only needed capacity

40 Ah doubles nominal energy.
Extra mass is not necessary.

Sizing basis: normal total draw ≤30 A; acceleration peaks within the supplier’s rated duration.

Select capacity for task energy; use peak-current capability for short acceleration demands.

06

Notes: We select a forty-eight-volt, twenty-amp-hour pack for our design. The two motors reach a combined two-kilowatt peak only during acceleration. We therefore distinguish short power demands from the energy required over the task. The selected pack offers thirty amps continuous and a specified sixty-amp peak, with nine hundred and sixty nominal watt-hours. A forty-amp-hour pack doubles that stored energy. Our sizing approach uses the smaller capacity within its operating envelope, avoiding capacity beyond the task requirement.

本次设计选择48伏20安时电池。两个电机合计两千瓦是加速时的短时峰值，因此选型时区分瞬时功率与整个任务的能量需求。所选电池持续放电30安、标示峰值60安，标称储能960瓦时；40安时则使储能翻倍。我们的选型思路是在工作范围内采用较小容量，避免超出任务需求的容量配置。

Design envelope: total continuous current ≤30 A; acceleration peaks within the supplier current-duration rating; usable pack energy covers task demand. Slide calculation uses 2 kW traction electrical input at 48 V. Source: supplier nameplates supplied by the team.

## Slide 7

VIBRATION CONTROL / TRANSMISSION PATH

Treat disturbance along its path

Road input

Deck + arm

Gripper + bowl

Wheels +
suspension

Frame

2

1

3

Three intervention locations along the disturbance path.

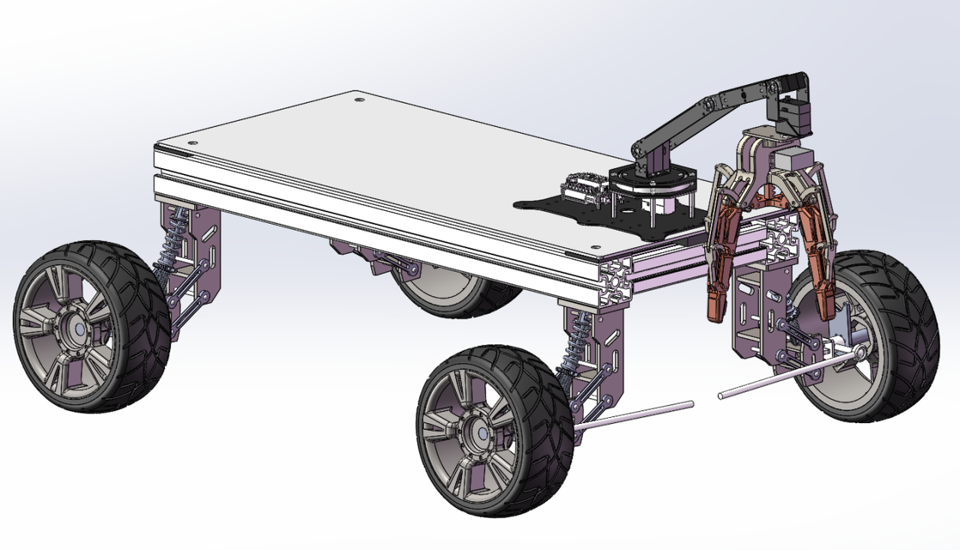
[picture p29: figure]

Design focus: wheel-end response, deck support and stable bowl contact.

07

1 Wheel-end response

Four spring-damper units.

2 Deck support

Rubber pads provide compliant support.

3 Secure bowl contact

Rubber jaw pads resist slip.

Smooth starts and stops complement
the mechanical measures.

Notes: We control disturbance along its transmission path: from the road, through the wheels and suspension, to the frame, arm and bowl. Suspension responds to bumps, deck pads provide compliance, and rubber jaw pads support stable contact. Smooth starts and stops complement these mechanical measures.

我们沿扰动传递路径布置措施：从路面到车轮与悬挂，再到车架、机械臂和水碗。悬挂响应颠簸，铺板垫块提供柔性，夹爪橡胶垫保持接触稳定，并通过平缓起停配合这些机械措施。

## Slide 8

SUSPENSION / PRELIMINARY SPRING SELECTION

Allow wheel movement, retain bump travel

Selected suspension CAD / spring and linkage

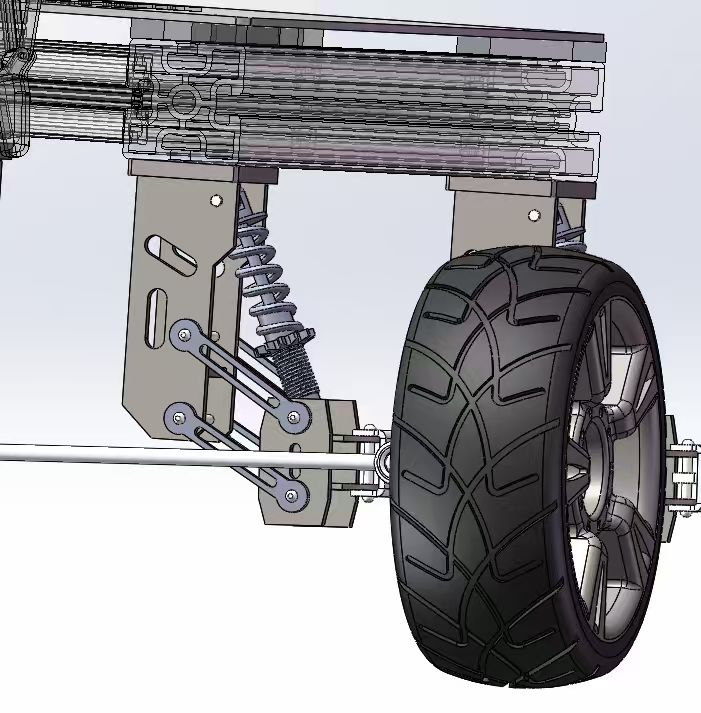
[picture p30: figure]

6 N/mm

per spring · four matched springs

A compliant starting point for rough-ground travel.

13–17 mm calculated static sag

About 25–33% of 50 mm travel

Leaves about 33–37 mm for upward wheel travel.

Spring: supports load and allows movement.

Damping: controls rebound and repeated oscillation.

Calculation basis: 15–20 kg; equal corner loads

08

Notes: Our preliminary spring selection is six newtons per millimetre at each wheel. Using a design mass of fifteen to twenty kilograms, fifty millimetres of wheel travel and an assumed motion ratio of zero point seven, calculated static sag is thirteen to seventeen millimetres. This uses about twenty-five to thirty-three percent of the travel, leaving upward movement for bumps. The spring provides support and compliance, while damping controls rebound, balancing rough-ground response with carrying stability.

四轮弹簧初选为每根6牛每毫米。按15至20公斤设计质量、50毫米轮心行程及0.7的运动比假设，计算静态下沉约13至17毫米，占总行程约25%至33%，保留应对颠簸的上跳空间。弹簧提供支撑和柔性，阻尼控制回弹，兼顾越野响应和持碗稳定性。

Calculation model: r = spring displacement / wheel displacement = 0.7 assumed; k_wheel = 6 × 0.7² = 2.94 N/mm. Equal corner loads; total design mass approximated as sprung mass; zero preload; locally constant motion ratio. Sag = mg/(4 k_wheel). Reference: https://www.hypercoils.com/spring-rate-calculator/ .

## Slide 9

Place compliance at the right interface

RUBBER SUPPORT / INTERFACE DESIGN

Two pad sizes match the rail and crossmember interfaces.

650 × 360 mm frame plan

Eight-point support layout.

4 rail-corner pads

60 × 60 × 10 mm

4 crossmember pads

45 × 45 × 20 mm

Support stiffness matters

Compliant layer between the frame and deck.

Balance compliance with arm-base support.

Equipment deck

Rubber

Frame

Design principle: place compliance at the load-transfer interface.

09

Notes: Our deck-support design uses eight rubber pads: four at the rail corners and four on the crossmembers. The two sizes match these different interfaces. The pads form a compliant layer between the frame and equipment deck. Their placement combines distributed support with the aim of reducing transmitted disturbance, while the jaw pads address bowl contact.

设备板支撑方案采用八块橡胶垫：纵梁四角四块、横梁四处四块，两种尺寸分别匹配不同接口。垫块在车架与设备板之间形成柔性层，通过分布支撑减少传递扰动；夹爪垫片则处理与碗的接触。

## Slide 10

Reduce mass where the task allows

DESIGN JUDGEMENT

Five design approaches.

Match materials to function.

Shorten and simplify the frame.

Balance without extra ballast.

Print custom geometry.

Avoid excess battery capacity.

Assembly concept / component arrangement

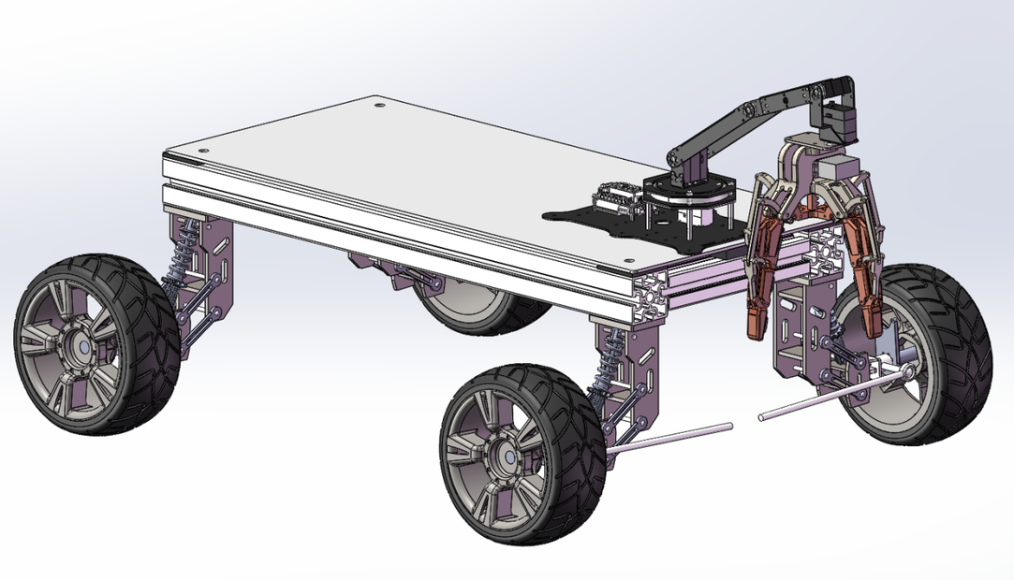
[picture p31: figure]

Profiles + deck: about 33% lower calculated mass.

Combine material, geometry and layout choices with suspension and compliant interfaces.

10

Notes: Our design combines a shorter frame, functional material choices, balanced equipment placement, custom printing and appropriate battery capacity. The profiles and deck achieve about thirty-three percent calculated mass reduction. Suspension and compliant interfaces complete our approach to stable water-bowl transport. Thank you.

我们的设计结合了缩短车架、按功能选材、平衡设备布局、定制打印和适当电池容量。型材与铺板的计算减重约33%，悬挂和柔性接口共同服务于稳定运水。谢谢。

## Slide 11

What the mass comparison includes

BACKUP / MASS CALCULATION

PREVIOUS DESIGN

4545 profiles: 4.65136 m total
4.65136 × 1.50 = 6.977 kg

Acrylic: 2 × 560 × 175 × 4 mm
2 × 0.560 × 0.175 × 0.004 × 1190
= 0.933 kg

Subtotal: 7.910 kg

REVISED DESIGN

6060 + 4545 profiles
1.30 × 2.38 + 0.72 × 1.50 = 4.174 kg

Acrylic: 650 × 360 × 4 mm
0.650 × 0.360 × 0.004 × 1190
= 1.114 kg

Subtotal: 5.288 kg

Reduction: 2.622 kg / 33.15% within this scope

Comparison scope: aluminium profiles and acrylic equipment deck.

11 / BACKUP

Notes: The calculation uses supplier linear masses and the acrylic panel dimensions. Old profiles total four point six five one three six metres at one point five kilograms per metre. New profiles combine one point three metres of sixty-millimetre rail with zero point seven two metres of forty-five-millimetre crossmember. Including the acrylic panels gives seven point nine one zero and five point two eight eight kilograms, a reduction of two point six two two kilograms, or thirty-three point one five percent.

计算采用商家米重与亚克力板尺寸。旧版4545型材总长4.65136米，米重1.50公斤；新版由1.30米6060纵梁和0.72米4545横梁组成，米重分别为2.38和1.50公斤。亚克力按1190公斤每立方米计算，两项小计分别为7.910和5.288公斤，减少2.622公斤、33.15%。比较范围为型材和亚克力。

Old length inventory: 840×1 + 760×2 + 310×4 + 140×4 + 61.42×8 mm. Old deck: 2×560×175×4 mm. New profiles: 2×650 mm 6060 + 3×240 mm 4545. New deck: 650×360×4 mm.

## Slide 12

Key reasons behind our design choices

BACKUP / DESIGN RATIONALE

How does the frame save mass?

Shorter rails and fewer members reduce material.
Profiles + acrylic: 7.91 to 5.29 kg, about 33%.

How does balance avoid extra mass?

Required battery mass performs the balance role.
A dedicated ballast block can then be avoided.

Why combine steel and PLA?

Steel preserves interfaces; PLA suits fabrication.
Printing and material choice have distinct roles.
Use each material for a specific component function.

Why select 20 Ah instead of 40 Ah?

Short peak demand does not require double energy.
Size energy and peak current for their distinct roles.

With r = 0.7 assumed, wheel rate is 2.94 N/mm.
15–20 kg gives about 13–17 mm static sag.

Why 6 N/mm?

How is disturbance controlled?

Springs support load; damping controls rebound.
Deck pads add compliance; jaw pads support grip.
Smooth starts and stops reduce abrupt inputs.

Calculation basis and source references are included in the speaker notes.

12 / BACKUP

Notes: Our choices follow component function and task demand. Frame geometry controls material use. Battery placement combines power supply with balancing, while capacity selection separates energy needs from acceleration peaks. PLA printing serves the custom gripper geometry, with steel used at the arm interface. Spring selection uses a defined mass, travel and motion-ratio model; rubber pads provide compliant interfaces along the disturbance path.

设计选择围绕部件功能和任务需求展开。车架几何控制材料用量；电池布局兼顾供能和平衡，容量选择则区分能量需求与加速峰值。PLA打印实现夹爪定制形状，钢件用于机械臂接口。弹簧初选采用明确的质量、行程和运动比模型；橡胶垫在扰动路径上提供柔性接口。
