Lurk0526/autonomous-water-transport-robot/reports/README.md

# 阶段汇报归档

每阶段选取已有的一份演示和对应讲稿，按原字节保留。阶段之间存在设计和事实变化：旧页面里的硬件、预算、速度、结构及计划不能直接作为今天的完成状态。当前入口是 [项目状态](../docs/project-status.md) 和 [机械设计](../docs/mechanical-design.md)。

| 阶段 | 选定文件 | 讲稿/补充 |
| --- | --- | --- |
| P1：早期方案，旧名 AquaGo | [P1 V6](p1/P1_AquaGo_V6.pptx) | [中英讲稿](p1/speaker-script.md) |
| P2：总体设计，2026-09-20 | [P2](p2/AstraGO_P2_20260920.pptx) | [中英批注讲稿](p2/speaker-script.md) |
| P3：机械设计，2026-10-10 | [P3](p3/AstraGO_P3_20261010.pptx) | [7 分钟讲稿 V3](p3/speaker-script.md) |
| P4：控制与定制件，2026-10-19 阶段 | [批注修订版](p4/AstraGO_P4_annotated_revision.pptx) | [对应讲稿](p4/speaker-script.md) |
| P5：轻量化与材料，2026-10-26 用户修改版 | [案例合并修改版](p5/AstraGO_P5_UserEdit_20261026.pptx) | [5 分半讲稿](p5/speaker-script.md)、[V5 计算与答辩依据](p5/calculations-and-qa.md) |

P2 保存的是选定的 9 月导出，后续其他架构修订未自动合并进去。P4 的较大演示保留一次，避免把所有迭代版本重复上传。P5 的计算材料与最终讲稿分别标明用途，旧数值以最新确认输入为准。

PPTX 仅归档并检查压缩包完整性，没有重排、渲染或修改。各文件来源和 SHA-256 见 [导入清单](../docs/import-manifest.json)。
