Lurk0526/autonomous-water-transport-robot/software/jetson/docs/bowl-follow.md

# 目标碗图像跟随

2026-10-21：用户要求先暂停实时识别，加入机械臂随碗移动的控制。相机 GUI、分割与 Isaac 服务已停止，未进行实体电机试动，OpenMV 和 STM32 闪存均未改写。控制代码写在 Jetson 项目中，运行模型仍由 Jetson 承担。

后续进展：用户已授权接管与试动；当前 Jetson 的串口复位问题已经修复，见 [驱动修复记录](arm-serial-fix-20261021.md)。已核验当前 CBM 固件与厂家磁编码位置控制格式，完成 004 往返反馈与 003 低头试动。用户要求进一步下俯接近 90°，当前腕部反馈 P992。实时视觉已启动，自动运动跟踪仍等待目标碗放稳后的局部校准。

## 小范围联调的新流程

`tools/calibrate_bowl_follow.py` 仅在存在连续稳定、完整且置信度至少 0.85 的唯一目标碗时，才允许通过 `--execute` 测量 000/003 各 ±30 P 的局部图像响应。按真实位置反馈求 2×2 图像雅可比，要求正负方向一致且矩阵条件良好；无法确认目标、图像位移或关节响应时停止，不生成可用标定。

受监督联调配置使用 `supervised_trial=true` 和本次实测标定记录，并锁定人工放置的目标；不会把尚未通过的独立负样本精度标为通过。它要求新鲜目标锁定、正确模型哈希、可重新计算的正负方向标定、实测姿态和局部限位。仅用于当前姿态附近的短时小范围试验。

联调模式每步最多 20 P、动作 400～1000 ms、单次 60 秒、每轴累计最多 240 P、相对参考姿态不超过 40 P，同时受配置的更窄关节范围限制。目标丢失超过 0.6 秒后锁定停止。GUI 增加“停止机械臂跟踪”按钮及当前状态。原先的通用预览默认仍为每步 3 P；该幅度不足以保证当前实体底座有可见响应，不能把预览计划视为已完成实体跟随。

## 位置判定

采用图像闭环对准：让固定在机械臂上的相机朝向碗，使碗的可见分割掩膜质心接近画面中心。这个版本只调整朝向，不控制相机到碗的距离，不计算毫米坐标，不进行抓取。

- 坐标原点：图像左上，x 向右、y 向下。
- 320×240 图像的对准点：`(160,120)`；其他尺寸自动取宽高的一半。
- 误差：`ex=(cx-W/2)/(W/2)`、`ey=(cy-H/2)/(H/2)`。
- 对准区：x 误差不超过 ±12 像素，y 不超过 ±10 像素；对准后停止调整。
- 唯一目标、置信度至少 0.85、连续 5 个不同时间戳的稳定帧才允许产生移动计划。使用 EMA 平滑，系数 0.35；过大的位置跳变重新积累稳定帧。
- 源图年龄不超过 350 ms；框不能贴边；掩膜面积占画面 2%～65%。无目标、多目标、低置信度、非有限坐标或旧消息均不产生运动计划。
- 横向误差分配给底座 000，纵向误差分配给腕部 003。每次至多 3 个 P 单位，移动时间 400 ms，两次计划间隔至少 500 ms。

轴选择参考本机厂家 `J1-OpenMV颜色跟随-240106.py`，但没有照搬其自动摆姿、瞬时 T0000、绝对中位或大范围限位。预览的两个方向符号暂取厂家示例的 -1；实际相机朝向/舵机模式可能改变符号，必须实体标定后启用。

上述阈值是保守的首版控制参数，不是已验证的识别精度指标。当前检测阈值仍是 0.5，跟随准入更严格为 0.85，因此一些已经显示轮廓的目标也会被跟随器拒绝。阈值不能保证排除误检，必须补充负样本验证。

## 默认只预览

```bash
# 当前摄像头与模型已按用户要求暂停，下面仅示例后续使用。
./start_bowl_vision.sh
# 另一个终端：只计算跟随计划，默认不打开串口。
./start_bowl_follow.sh
```

订阅 `/openmv/bowl/detections`，发布 `/openmv/bowl/follow_status`，写入 `work/bowl-follow/status.json`。预览状态中的 `delta_p` 是建议增量，不代表电机已执行。`motion_enabled=false` 表示串口未打开。Ctrl+C 停止跟随器；视觉用 `./start_bowl_vision.sh stop` 停止。

`start_bowl_vision.sh` 不会启动电机跟随；单独运行跟随器也不会自动重启相机。需要离线复现时，`./start_bowl_follow.sh --replay RECORDS.jsonl` 读取检测记录，按记录的相对时间检查规则，始终禁止硬件输出。

## 实体输出入口与当前限制

真实串口输出已经实现，但必须显式传入 `--enable-motion --config 配置文件`。模板 `config/bowl-follow.example.json` 故意保留空的实测位置和限位，不能直接用于运动。需要实际测量而非仅修改开关：

1. 相机刚性固定在机械臂上，确认运动方向，测定 000、003 的有效 P 限位与当前六关节基准姿态。
2. 查清并解决此前 CH340 打开时控制板复位/全舵机回中位的问题。代码在 open 前设置 DTR/RTS，但这不能单独证明硬件问题已解决；本次未打开该端口测试。
3. 补充真实负样本，确认当前工作区域的识别足够稳定。已发现的支架误检案例保存在部署目录，尚未完成此项。

实际启用时只接受显式指定的 CH340 `1a86:7523` 端口，保持长连接，不自动重连。启动只查询位置，六个关节必须都返回实测 P 值且接近标定基准；不会自动回零或摆姿。不能把 `$GETA!` 握手成功或查询回显当作位置反馈。

输出前检查当前反馈、单步限制、标定软限位、相对启动位置 ±40 P 窗口，以及每轴累计移动不超过 40 P；会话最多 60 秒。反馈偏差超过 8 P、限位或会话超时会锁定故障，不能靠后续新帧自动恢复。丢失目标、数据过期或正常退出时发送 `$DST!` 尝试停止，保留力矩，不自动回中，不使用 PULK。

串口断线时无法保证停止命令到达；该软件逻辑不能替代实体断电/急停与碰撞防护。当前代码没有环境碰撞模型，也没有对 000/003 进行本轮实体跟踪验收，因此本次只完成代码接入和离线验证。

## 验证

```bash
source ./activate_project.sh
python -m unittest discover -s tests -v
```

跟随专项测试覆盖稳定帧、居中保持、丢目标、重复/过期消息、低置信度、多目标、边缘目标、非法坐标、模拟闭环收敛、启动姿态检查、限位、反馈不一致、串口回显隔离，以及禁止把 OpenMV 端口用作机械臂端口。全部使用模拟数据/模拟传输对象，未连接实体串口。

独立 ROS domain 91 的预览消息集成测试使用合成检测记录，检查产生动作建议、停止输入后失效以及 `motion_enabled=false`。证据位于 `work/deployment-20261021/follow-integration-verification.json`；它证明软件消息链路，不证明实物运动方向或安全工作范围。

## 2026-10-21 六通道扩展（待完成实机验收）

本轮用户要求扩大幅度、加快跟随并使用全部六路。旧进程已触发
`session_travel_limit`，已停止退出，视觉进程保留。新增实测中，001 正向
26 P 使场景中心下移约 23.5 px；002 正向 51 P 使场景中心上移约
44.8 px。两轴的反馈存在明显且不同的方向偏差。多轮标定因场景匹配
失败或局部行程保护中止，不能将这些单向数据当作完整方向标定。

代码支持显式六路串口输出，000～004 的实测 2×N 图像响应矩阵，以及
阻尼最小二乘分配。005 为开合机构，居中时保持开度并轮询反馈；000～004
中未对画面中心产生可靠响应的轴，其矩阵列设为零，不为了凑轴数运动。
所有参与轴仍须双向实测，配置校验会重新计算矩阵。

新配置生成器支持最多 65 P 指令、400 ms 动作、900 秒会话、每轴累计
12000 P、参考姿态窗口 90 P，并保留局部软限位及反馈故障停止。实际位移
取决于方向补偿；没有把协议 500～2500 P 当作机械安全行程。累计行程
按预计的实际位移计数，不再把克服舵机死区的指令量重复计入。

新增图像匹配采用 SIFT、比值筛选、分布检查和 RANSAC，并保存失败动作的
前后帧，方便排查反光、人员运动或纹理不足。夹爪默认没有自动开合动作。
用户确认碗放稳后，执行五轴双向标定，再生成新配置及验证居中。未完成
标定前不使用新增承重轴做自动跟踪，也不把准备好的配置称为运行成功。
