Lurk0526/autonomous-water-transport-robot/software/jetson/docs/bowl-transport-review-v0.2.md

# 满水碗搬运方案复审 v0.2

2026-10-23。本版修正 v0.1 的决策顺序：先证明机构、观测和控制基线可行，再决定是否训练。当前 `TRAINING_READY = false`，建议暂不租训练服务器。Isaac Sim 仍适合后续接触与传感器仿真，Isaac Lab 留作有明确收益时的训练工具；软件选型不会补齐缺失的机构参数。

## 最先需要纠正的判断

原流程演示由合成观测逐步给出“已抓住”“已承托”等成功信号，它只能展示状态切换。画面顺畅、流程全绿、官方训练示例可运行，均不能证明本机械臂抓得住满水碗，更不能证明提前展开节省了真实时间。

已确认的只有碗外径约 156 mm、高约 60 mm、加到碗口时碗水总重 650 g。空碗质量未知，水质量必须保留未知；不得把 650 g 全部当水，再叠加碗质量。图片不能确定内壁截面和容量。真实液体场景必须同时符合内腔容积、水量及总重，不能用互相矛盾的参数训练。

五个臂关节不能默认满足任意六维末端位姿。停车位置、夹持高度和工具方向应联合搜索，先筛掉不可达、贴近奇异位形、力矩不足的候选。650 g 对腕部和肩部的负荷还取决于偏心与水平力臂；需要计入夹爪、臂段、制动惯性，并测长时间保持时的温升、下垂、回差。额定或堵转力矩不能直接用作连续工作能力。

湿润斜壁容易滑脱，过大夹力也可能使碗跳起或损坏。若开口、接触形状和承载实测不合格，优先修改夹具。规则允许时可比较托底、托沿或车载托座，减少摩擦夹持及持续悬臂承重；但托座交接可能多一次抓放，必须计入总时间和洒水，不能默认更优。

## 提前准备与降低重心都需证明收益

行驶中展开同时改变扫掠体积、载荷力臂、相机视角和车辆稳定性。首版默认关闭提前准备，先验证“停稳后动作”的基线。只有扫掠净空、制动距离、地形、姿态、执行跟踪和负载证据均有效时，才允许在限定路段试验。证据过期、缺失或发生滑移时撤销准入；零轮速不足以证明悬架与机械臂基座稳定。接触动作仍要求连续停稳窗口，学习策略无权绕过。

降低携带高度能改善部分车辆稳定性和承重力臂，却可能增加末端水平移动、关节换向和额外液面激励。更慢的轨迹也可能延长低频激励、进入晃动共振区或暴露静摩擦问题。应比较完整“抬离—回收—运输—展开”轨迹，包括末端实测运动与最终洒水；不能只奖励低高度或低速度。

满水名义余量为零。加速时液体趋向有效重力方向，因此“碗始终对地绝对水平”和“液面始终平行碗口”并不总是一致。也不能直接按照加速度瞬间倾碗，转动本身会激发晃动。先识别车辆与机械臂传递到碗的运动，再比较受限倾斜、水平保持和轨迹整形。小幅晃动模型只做敏感性筛查，不能外推成满水溢流克数；这一限制与 [NASA 的小幅液体晃动研究范围](https://ntrs.nasa.gov/citations/19920037839)一致。

## 观测链与动作链分别验收

已有图像跟随可以复用识别能力，但底盘导航、停靠制动与三维抓取坐标仍需独立实现。水下红点受到折射、波纹和反光影响，夹指进入后又可能遮挡；它适合作为辅助候选，不能作为唯一接触定位依据。结合碗沿、已知几何和平台标定，并验证满水条件下的误差分布。相机随臂移动时，图像必须对齐采集时刻的关节数据；使用最新关节值去解释旧图像会产生运动相关偏差。

位置指令完成不等于真正夹住，闭爪计时结束也不等于抓取成功。夹持、试抬、滑移和放置承托必须对应实机可获得的证据，测试时应覆盖假阳性及反馈中断。缺少力传感时保留能力边界，不能在仿真中凭空提供部署端没有的精确信息。

当前项目记录过数百毫秒的舵机动作及异步反馈。候选 20 Hz 策略调用频率不等于机械臂有 20 Hz 跟踪能力；本机加入了延迟、滞后、限速与死区的假设刺激检查，后续需用实际记录识别参数。遮挡时可以考虑有界预测，但必须限定有效期和不确定度，不能永远沿用最后一个“看到了碗”的结果。

## 奖励设计先确定评价，再确定权重

先进行轨迹参数搜索与确定性控制，比较同初始条件下的基线；只有基线在明确工况失败，才针对该缺口引入有界残差学习。首轮不同时开放导航、全关节、抓放决策和抗晃控制。碰撞、限位、夹持与松爪准入由监督器约束，不能让完成奖励抵消违例。

奖励遵循以下原则，具体权重等测量和尺度校准后再确定：

- 连续代价按时间积分，折扣按物理时间定义，避免修改控制频率就改变偏好；成功、失败事件只记一次，并区分超时截断与真正终止。
- 如使用势函数整形，采用 `γΦ(s′)−Φ(s)` 并正确处理终止势，检查绕圈、重复接近、反复夹放是否刷分。[Ng 等的策略不变性结果](https://ai.stanford.edu/~ang/papers/shaping-icml99.pdf)依赖相应假设，不能替任意距离奖励背书。
- 晃动、姿态和加速度是代理指标，不能标为实际洒水。未知水量、未知滑移不能按零计算；较少初始水量或主动洒水变轻的策略不能获得虚假的优势。
- 同初始水量比较实际损失、成功率和总时长，先满足任务与约束，再比较耗时。用提前失败、静止不动、丢弃碗、边界振荡等对抗轨迹检查奖励漏洞。

本版奖励实现只做数学审计：软代价有界、按时间积分；阶段势采用 `γ(dt)=exp(-λdt)`。失败和不可逆失水采用固定回合代价，补偿时间折扣，避免拖延失败/洒水变得划算。成功事件必须带完整证据和明确的洒水阈值，否则完整奖励为 `null`，不会把缺测当作零损失。源码里的数值预算及测试用的 300 g 水、350 g 碗、5 g 阈值仅为攻击测试样例，绝不是本项目的测量或比赛标准。

势函数整形只有在匹配折扣和终止处理时才具有相应性质，不能裁掉负整形项来“让奖励更好看”。接入 Isaac Lab 时还需防止奖励管理器与本模块重复乘 `dt`；任务超时按任务失败终止，采样器的外部截断则保留终态价值自举，两者不可混用。

## 本机通过与训练准入分开

本机验收分为三项：逻辑检查覆盖失效反馈、时序、稳定窗口与禁止提前动作；数值检查覆盖步长敏感性、静止平衡和代理模型的适用范围；奖励检查覆盖事件重复、时间尺度与上述投机轨迹。每项给出独立结果和失败原因。这些检查可以在当前电脑完成，但只证明对应代码性质，不证明真实抓取或抗溢性能。

训练租赁另设门槛：机器人关节与碰撞模型已校验，650 g 承载和湿碗夹持已测，空碗/水量与几何一致，感知与执行误差已记录，抓放基线和观测接口可复现，并已有值得训练改善的指标。未知项必须阻止准入。资料齐备后如需短时 RTX 环境验证 Isaac 接触模型，应明确作为建模验证租用，不视作已批准长时间训练。

最终对照使用同路线、同碗位置、同初始水量与独立留出工况，分别报告掉碗、碰撞、实际失水和停车各阶段用时。只有提前准备在这些条件下获得稳定收益，才启用它；本地预演结果不能替代这一结论。
