Lurk0526/autonomous-water-transport-robot/software/jetson/docs/full-range-follow-20261025.md

# 六关节全范围启动

2026-10-25，用户明确要求：“我要求全部关节范围可启动，我确认安全”。
据此，当前运行配置使用六关节 P500～P2500，包含两个端点。
范围来自控制器支持的 P 值与用户的明确授权，不能把软件准入测试表述为已实机遍历所有组合姿态。

## 行为

启动读取全部六路实测位置并建立会话，不回中、不要求先摆到旧标定区间。
底座、肘部、腕部继续负责图像跟随，肩部、末端旋转和夹爪保持本次实测值。
原先底座 P1100～1900、肘部 P1437～2447、腕部 P650～1800 的局部运行包络不再限制当前配置。

`config/bowl-follow.runtime.json` 记录全范围策略、版本与用户授权来源，覆盖旧工作会话的范围策略。
启动、标定、规划和参考位移窗口通过 `vision/motion_limits.py` 共用范围；窗口最大 2000 P，端点只允许向内规划。
原有单步位移、反馈、目标新鲜度、丢失目标停止和停止按钮仍工作。
v1.0.0 的发布归档、原固定参数和原姿态模型保留。

启动先选择可复算的实测姿态模型。在全范围模式下，若模型匹配距离超过 1.0，或没有有效模型，
则在当前位置自动重新测量底座、肘部和腕部的方向。距离沿用模型选择中的归一化肩/肘/腕/末端旋转差值，
是模型复用条件，不是关节位置限位。测量需要碗在画面中保持静止；方向不一致或不可观测时停止，失败不覆盖旧会话配置。

## 测试和证据

192 项离线测试通过，包括：六个关节分别在 P500、P2500 启动时不发送回中目标；
当前肘部 P1229、腕部 P590 获准；P499/P2501 拒绝；端点只能向内规划；
旧会话范围迁移；远姿态关闭旧串口后原地适配；上下端点从范围内试探并通过返回运动取得双向数据。
端点标定测试使用模拟传输，没有指挥实机遍历端点。

证据与修改前副本位于 `work/full-range-follow-20261025/`，包含 `tests.log`、`targeted-tests.log`、
`live-start.log`、`live-start-retry.log` 和 `before/`。

## 实机过程

首次已从底座约 P1547、肩部 P1213、肘部 P1229、腕部 P590、末端旋转 P1495、夹爪 P1533 开始原地测量。
旧范围已不再阻止启动。底座及肘部取得双向反馈，腕部两次图像响应不一致，因此该组模型未被采用，跟随服务保持停止。
原始报告为 `work/bowl-follow/calibration-20261025-134424/report.json`。
随后重测通过，报告为 `work/bowl-follow/calibration-20261025-134609/report.json`。
新矩阵为 `[[1.375902,-0.032327,0.000056],[-0.112797,-1.068180,1.093221]]`，条件数约 1.1297。
配置成功写入 P500～P2500 的统一范围，实机跟随完成 19 条纠偏命令后居中；
连续 10 秒观察均为 `centered`，碗中心约 (161.7,124.4)，关节反馈为
000=1509、001=1213、002=1227、003=539、004=1495、005=1533，控制保持使能。

之后执行停止、重新启动视觉界面、再次开启跟随：7.18 秒恢复使能并处于 `centered`，
没有回到旧姿态，`new_probe_reports=[]`，无需重新测量。
`restart-verification.json` 保存新鲜状态与时间，`first-live-verification.json` 保存静态居中观测。
这验证了当前低位姿态的适配、静态居中和直接重启；各关节端点启动及端点规划另由离线测试覆盖。
