Lurk0526/autonomous-water-transport-robot/software/jetson/docs/responsive-follow-20261025.md

# 跟随速度和灵敏度优化

用户要求修复响应慢、灵敏度低，并继续支持各关节在完整范围内从当前位置跟随。
运行配置为 v1.2.0，`config/bowl-follow.runtime.json` 保存 `response_profile=responsive-v1` 与全范围策略。
不启用该响应配置时，代码仍能复现旧参数，便于比较和恢复。

## 原因和修改

旧居中范围 6 px，加上 1.5 倍保持系数，要偏离约 9 px 才重新动作。
旧指令耗时 500 ms，后续等待 200 ms；续接要求误差至少 30 px 且参与关节集合完全一致。
较小的误差或肘腕分配变化会等待旧动作结束，再逐关节核对反馈。

当前居中范围 4 px、保持系数 1.2，约 4.8 px 开始重新纠偏；滤波系数 0.8→0.9，
近/远增益 0.55/0.92→0.72/0.98，增益变化尺度 30→22 px。
动作时间 400 ms、额外等待 60 ms、规划周期 60 ms，续接周期 200 ms、误差门槛 12 px。
这些是控制参数，不等同于实机完成一次动作的保证时间。

肘部常规分配权重由 1.35 调为 1.15，靠近腕部边界时继续渐进交接。
在运动中改变参与关节集合时，先停止旧分配、核对真实位置与范围，再等待新图像规划。
反向、居中、目标丢失和操作员停止保持中断行为。

首轮实机还发现：小指令被反复发送，但实际位置没有变化；部分短动作因图像已进入中心区而提前停止，
原有的完整动作终点补偿没有机会学习死区。
现在只对已经取得合法停止反馈、预计有位移但实测完全未动的动作累计有效时间。
同一方向短动作的累计时间达到一段动作时间时，补偿最多增加 3 P，总补偿仍限制在 60 P；
真实进展会清除累计，间隔超过 1.5 秒也重新累计。异常位置仍停止，不作为死区学习。

首轮移动测试后用户反馈“反应迟钝而且容易跟丢”。实机日志中出现多次 `outside_locked_target`：
碗偏离旧锁定位置超过 80 px 后，即使仍在画面里，旧逻辑也可能一直拒绝恢复。
因此继续加入独立的重新捕获流程：同一模型、单个可信度至少 0.85 的碗在连续三帧中保持几何一致，
即可在画面任意位置重新锁定。弱背景提议不阻挡唯一清晰目标；多个清晰候选、旧图像或模型不符均不重新锁定。
这属于单个目标碗的重新捕获，不是对其个体外观做身份识别。

对已经连续确认的碗，提高快速移动时的连续性判断；仅因控制线程跳过部分帧而造成的采样间隔，
在仍满足 350 ms 新鲜度要求时，不重复从零确认。真正丢失、歧义或不可用图像仍停止，恢复后重新捕获。

## 全范围和不同姿态

六个关节的启动读数仍支持 P500～P2500；各轴范围、参考窗口与标定使用同一配置。
底座、肘部、腕部负责跟随，其他关节保持本次实测位置。新姿态模型差异过大时，继续在当前位置自动测量。
个别跟随关节没有可观测的图像响应时，只要其他关节的响应矩阵仍有效，就允许其承担纠偏，
零响应列不分配运动。整体无法观测或所需运动超出所有可用关节余量时，保持停止。
因此全范围启动不能表述为所有姿态都能追到任意空间目标；目标还需在视野内，并存在可行的关节运动。

## 验证

最终 206 项完整回归通过，覆盖重新捕获、快速连续移动、跳帧、歧义、模型不符和丢失停止。
新增覆盖 64 种六关节端点组合与 4 种相机图像旋转，验证可行需求能降低图像误差，且命令保持在 P500～P2500。
其他新增检查包括：7 px 小移动退出保持区、1 px 抖动保持、分配交接和越界反馈、
无进展的短动作补偿、真实进展及间隔过久不错误累计、肘部零响应时其他关节继续纠偏。

模拟比较使用 20 FPS、60 ms 图像延迟、40 ms 位置查询、固定方向偏差与线性舵机插值，不能代替真实动力学：

| 目标误差 | v1.1 达到居中的模拟时间 | v1.2 达到居中的模拟时间 |
| --- | --- | --- |
| 水平 60 / 垂直 35 px | 0.94 s | 0.76 s |
| 垂直 50 px | 0.92 s | 0.74 s |
| 反向水平 60 / 垂直 35 px | 0.94 s | 0.76 s |
| 水平小移动 7 px | 保持不动 | 约 0.10 s 开始动作 |

实机新配置已从当前位置直接启动，无需重新探测。第二次启动后的 20 秒采样以居中为主，
末次碗中心约 (157.8,121.7)，反馈为 000=1334、001=1213、002=1171、003=531、004=1495、005=1534，
运动保持使能且没有反馈故障；期间短暂的候选歧义或旧图像会停止并重新识别。
移动速度与停稳效果继续以用户移动测试评估。

重新捕获修复后，从当前已改变的肩、肘姿态再次完成测量，报告为
`work/bowl-follow/calibration-20261025-143021/report.json`，新矩阵条件数约 1.4125。
启动参考为 000=1437、001=1085、002=1033、003=553、004=1496、005=1535。
新姿态测量与重新开启均成功，移动及重新锁定记录保存在 `reacquisition-live-check.json`。

最终用户在移动测试后反馈“可以”，并询问整机断电后从任意位置重启的能力。
当前末次状态为 `centered`、运动使能，反馈为 000=1389、001=1086、002=961、003=527、004=1495、005=1535，
碗中心约 (157.9,118.7)。记录保存在 `accepted-final-verification.json`。
全范围、响应配置和 CH340 保护选项均已持久保存，启动流程会重新读取位置；重启后仍需打开界面并点击开始，
新姿态需要适配时保持碗静止。已经验证新姿态启动与服务重启，尚未进行整机断电重启实测。

本轮副本、原始日志、模拟比较与实机记录保存在 `work/responsive-follow-20261025/`：
`before/`、`before-journal.log`、`tests.log`、`final-targeted-tests.log`、`simulated-response.json`、
`first-live-command-metrics.json`、`final-live-check.json` 和启动日志。
