Lurk0526/autonomous-water-transport-robot/software/jetson/docs/water-cart-project-context.md

# 自动运水小车：已确认的任务背景

2026-10-29 回查此前聊天及原有场地方案后整理。下列已确认内容无需再次向用户询问。

## 场地与路径任务

- 场地是试验场西北角的室外砖块路段。
- 工况包括直线、颠簸、转弯、避障、加速。
- 主摄像头的视觉任务围绕该砖路场景的道路/可通行区域、边界和障碍物展开；没有确认采用黑线或色线循迹，也没有确认现场存在标准车道线。
- 数据采集应覆盖日照、树荫、砖缝、路沿、路面不平、振动和运动模糊。普通砖缝或阴影不能直接等同障碍物。

## 车辆与两路视觉

- Jetson Orin Nano 上使用 ROS 2；前轮拉杆转向，后轮驱动，STM32 控制，通过 USB 连接。
- Gemini MAX 是车身主深度相机，用于道路感知、定位建图及避障。
- 机械臂/夹爪相机用于碗的近距离定位，与主摄像头任务分开。
- 整体任务是自动运水及平台上的取碗、放碗；已有机械臂碗识别工作继续复用。
- 曾提出 30 km/h 的整车识别及避障目标；此前没有机械刹车，采用电机反转，尚无实测刹停距离。该目标尚未验收，不能把当前相机约 30 Hz 的数据流验收当作车速能力验收。

## 当前安装状态（用户于 2026-10-29 确认）

- 相机还在调试，尚未固定到最终安装位置。
- 相机离地高度、安装平移和姿态留待最终安装后测量；现在不要求用户提供这些数值。
- 保留相机原始输出及相机内部 TF，暂不发布假设的 `base_link → camera_link`。
- 当前倒置画面作为调试安装状态记录，不先单独翻转 RGB；最终按安装方向统一处理图像、内参及坐标变换。
- 已完成的是相机及 ROS 2 数据环境；场地模型、车体外参和底盘闭环仍需后续验证。

## 2026-10-30 道路感知前置更新

- 用户确认仍未装到实车。不要要求现在提供安装高度或车体外参，不填猜测值。
- 4060正式训练20轮完成，已部署第8轮best；在Orin上完成2095张独立测试。排除水面类别的六类平均IoU为79.62%，铺装IoU为94.41%；用户预计使用中不涉及水面。
- 实时RGB语义、置信度、相机内部标定的RGB/深度关联、语义点云与RViz均已接入；TensorRT FP16已在Orin构建并通过8张真实验证图的数值比较。
- 录制和独立ROS域回放、缺TF/无效深度/过期/恢复/断流处理已验收。节点保持相机相对感知，`mount.enabled=false`，未启用车体地面过滤和运动控制。
- 操作入口：`./open_road_perception.sh`；详细状态、限制和装车步骤见 `docs/road-perception-preinstall.md`。

## 2026-11-01 无标线算法仿真

- 用户要求先完成当前可做的仿真，只有需要 Isaac Sim/Lab 时再告知租 GPU。本轮不需要租赁。
- 新入口 `./run_line_free_sim.sh`，报告 `sim/line_free_cart/output/report.html`；代码、配置、完整轨迹和可移植包已保留，说明见 `sim/line_free_cart/RUN.md`。
- 22 个导航场景、4 个任务流程、27 组 S 弯噪声/延迟组合符合各自预期，23 项回归测试通过；导航中的停车/拒绝出发不记为到达。
- 已实现前轮转向运动学、Pure Pursuit、速度/转向平滑、已知直走廊内候选绕障与无解停车、输入失效制动；取放流程读取运行中的模拟底盘状态。
- 全部车辆参数、定位和障碍观测为合成数据，机械臂为 mock 反馈；真实定位/建图、相机感知、三维接触、轮胎悬架和洒水性能未验收。没有调用实体运动接口，也没有运行 Isaac 或强化学习。

## 2026-11-01 后续接入与主方案调整

- 用户最新明确：大概率有赛道线，无标线只做备用；线色未确定，先兼容黑/白/黄。后续以此优先级推进，不再把无标线当主方案。
- 用户确认相机已连接，底盘/其他尚未连接。已恢复热插拔后停滞的RGB；用户调整相机后深度恢复。记录321 RGB/320深度及另一段带感知输出的真实数据，均是室内/台架，未冒充现场采集。
- `cart/`完成只读输入适配、参数来源/单位/证据检查、定位与障碍输入逻辑、现场录制、三色循迹和模式选择。真实参数未知项仍为空，未猜STM32协议、未接实车控制。
- 主方案新增10项图像闭环循迹，备用场景扩至38项，另有4项任务流程和27组噪声/延迟组合；主入口为`./run_cart_sim.sh`。
- `./cart_preflight.sh`查看真实输入/待接入项，`./cart_capture.sh`是现场人员到位后的有界录制入口；报告入口保持`sim/line_free_cart/output/report.html`。
- 底盘协议/反馈、实测尺寸/制动、相机安装外参、现场线形/路口/站点及精度参考仍需负责同学或现场提供。用户负责算法，不负责机构改造。本轮仍无GPU租赁需要。

## 记录依据

- 此前聊天《安装 Isaac Lab》中的用户原话：“测试场地定为试验场的西北角砖块路段……有直线、颠簸、转弯、避障、加速工况。”
- 原场地方案：`/home/nvidia/Documents/Codex/2026-10-12/new-chat/outputs/室外砖块路段测试方案.md`。
- 本次相机说明：`docs/gemini-max-ros2.md`。
