Lurk0526/autonomous-water-transport-robot/assets/images/vision_bench.jpg

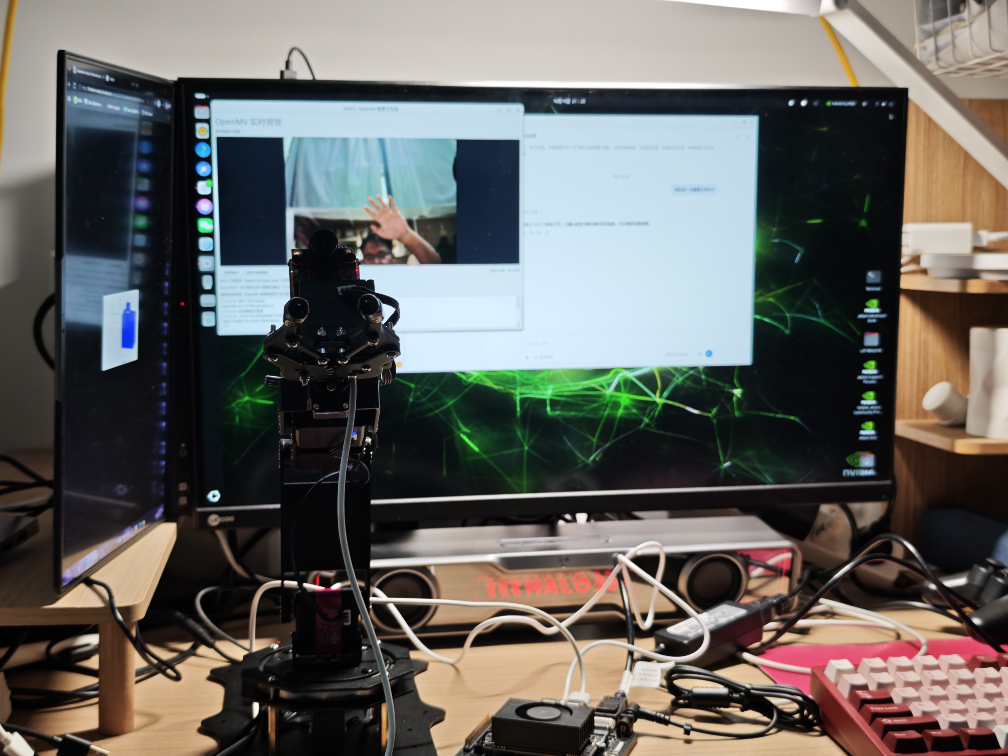
assets/images/vision_bench.jpg
