Lurk0526/autonomous-water-transport-robot/software/jetson/assets/cad/bowl-reference.jpg

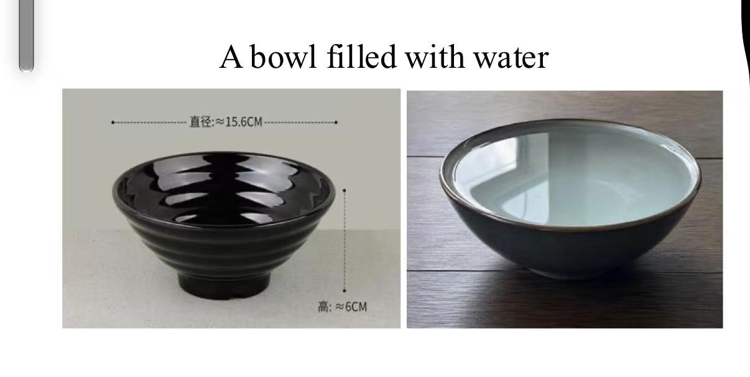
software/jetson/assets/cad/bowl-reference.jpg
