Lurk0526/autonomous-water-transport-robot/software/jetson/assets/cad/course-reference.jpg

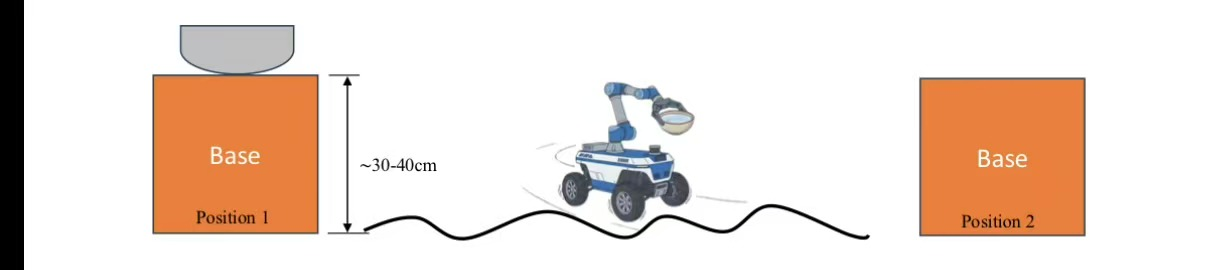
software/jetson/assets/cad/course-reference.jpg
