Lurk0526/autonomous-water-transport-robot/docs/missing-materials.md

# 待补材料

> 2026-11-02 运行工程更新：已补 Jetson 软件、相机/ROS 感知、训练工具、模型索引及本机仿真证据。下面保留此前资料整理时的逐项状态；同日软件与相机更新以 [接入记录](runtime-import-20261102.md) 为准，未完成的实车验证继续有效。

优先补能让第二版模型独立打开、让当前状态可见的材料。代码按用户安排，由另一台机器上传即可。

## 第一批：模型与实际装配

1. **第二版整车的 SolidWorks Pack and Go ZIP。** 从 `成品车.SLDASM` 出发，打包关联零件和子装配；记录 SolidWorks 版本及实际使用的配置。当前只有一份整车总装和机械臂配件，未确认包含车架、轮端、悬架、转向、传动等全部依赖。
2. **同版整车的 STEP 导出。** 用于没有 SolidWorks 的机器检查几何。注明毫米单位及装配层级；STEP 不替代原生文件和装配约束。
3. **当前实物照片。** 整车四周、俯视、底部、机械臂底座、四爪接口及电控布置。说明四爪是否已装上、是否能开合，照片对应哪个车架版本。
4. **改造件。** 团队修改的钢适配件、机械臂安装板、夹具接口及悬架连接板的原生模型/工程图；未单独建模可先补尺寸草图。

SolidWorks 官方说明 [Pack and Go](https://help.solidworks.com/2022/english/SolidWorks/sldworks/c_Pack_Go_Ovw_WPDM.htm) 用于收集相关零件、装配、图纸及引用。打包后在新文件夹中打开检查“缺失引用”，能更直接确认依赖是否齐全。本环境尚未执行这项重建检查，不能列出确定缺失的零件名。

## 第二批：硬件与接口

| 材料 | 用途 |
| --- | --- |
| STM32 板卡型号、引脚表、接线图 | 对照统一下位控制分工、通信和电源 |
| 电机控制器与转向舵机型号、手册、协议 | 确认命令、单位、反馈、供电和停止行为 |
| 众灵 MV4 手册、协议、舵机参数与可用 URDF | 确认自由度、关节限制、持续负载和仿真输入 |
| Orbbec 相机铭牌/商品型号、SDK 识别结果 | 确认准确 SKU，避免与 Gemini 2/Astra 混用 |
| 已购电池、BMS、降压模块型号和接线 | 区分 P5 选型意向与真正装车配置 |
| BOM、实际支出与收据 | 补齐完整质量和预算；提供去除个人信息的版本即可 |
| 碗、夹具、钢适配件及整车称重 | 核算末端载荷、重心和弹簧选择 |

## 第三批：证明已有功能的资料

- 黑碗随动视频、电机启停/正反转/调速与转速读取的视频或原始日志；注明日期、硬件版本和对应代码提交。
- 训练配置、数据类别、确切 train/val/test 数量、划分清单、指标输出与几张原图/标注样例。
- Jetson 环境检查输出。相机取流、抓取、转向和导航如果已经有新进展，分别给实际结果；尚未做的保留待验证即可。
- 30 km/h 测速、载水剩余量、持碗持续时间和振动记录，只在实际测试后补结果。

## 由另一台机器上传的代码

按 [上传指南](upload-code.md) 放入 Jetson/OpenMV 程序、STM32 完整工程、ROS 工作空间、训练/推理脚本和已有仿真资产。不要为了填目录而创建未实现的控制代码；没有的模块继续标待补。
