Lurk0526/autonomous-water-transport-robot/hardware/BOM.md

# 硬件清单：待补齐的 BOM

以下来自阶段材料，价格与整车质量未汇总。数量只填已明确项目；没有实际型号的条目保留未知。

| 项目 | 当前记录 | 数量/状态 | 还需补 |
| --- | --- | --- | --- |
| 纵梁 | 6060，650 mm，2.38 kg/m | 设计 2 根 | 实际牌号、孔位、是否已切短装配 |
| 横梁 | 4545，240 mm，1.50 kg/m | 设计 3 根 | 实际牌号、连接件与紧固件 |
| 设备板 | 亚克力 650×360×4 mm | 设计 1 块 | 图纸、称重、局部承载验证 |
| 后轮驱动 | 双电机、皮带传动，供应商 6374/1000 W/36–48 V、8 英寸轮胎描述 | 2 个后驱模块 | 实际型号与实测；宣传速度不计作车速 |
| 前轮与转向 | 前轴舵机转向、双叉臂 | 实际组件待列 | 舵机、拉杆、轮端型号与限位 |
| 弹簧减振器 | 四轮；6 N/mm 为初选计算值 | 4，实际刚度未知 | 真实弹簧、阻尼、运动比和轮荷 |
| 上位机 | Jetson Orin Nano 8GB Super | 已购 1 套 | 系统版本、供电与安装方式 |
| 下位控制 | STM32 | 板型/数量未知 | 实际型号、接口、源码 |
| 电机控制器 | 已报告 STM32 控制与转速回读 | 数量/确切版本未知 | 手册、命令和反馈定义 |
| 机械臂 | 众灵科技六轴视觉机械臂，总线 MV4 版 | 已购 1 套 | 真实自由度、舵机、负载、协议 |
| 四爪 | PLA 打印、橡胶接触垫、钢接口 | 已加工，安装待确认 | 改造 CAD、称重、开合与持续承载 |
| 机械臂底座 | P5 记录 2 mm 钢底座，外侧 6 螺栓，孔距跨度 230×140 mm | 记录待核对 | 轮廓、钢材牌号、当前 CAD 与真实孔位 |
| OpenMV | 已报告用于图像采集 | 已使用，型号未知 | 板型、镜头、接口与程序 |
| 导航相机 | 用户称 Orbbec Gemini Pro Plus | P4 已到货 | 铭牌、准确 SKU、SDK 与固件 |
| 电池 | 48 V 20 Ah 倾向方案；30 A 持续/≤60 A 峰值为供应商口径 | 是否已购未知 | 化学体系、BMS、峰值时长、真实重量 |
| 降压、配电、急停 | 尚缺电气资料 | 未知 | 各电源轨、保险、开关、失联与断电行为 |
| 设备板垫片 | 60×60×5 mm ×4；45×45×15 mm ×4 | 方案，P5 未安装 | 硬度、材料、压缩量与安装结果 |

完整 BOM 还需每项：确切型号、数量、供应商、单价、日期、发票/收据索引、实际质量及安装位置。
