Lurk0526/autonomous-water-transport-robot/software/jetson/assets/cad/chassis-v3/【MG23】装配体.SLDASM

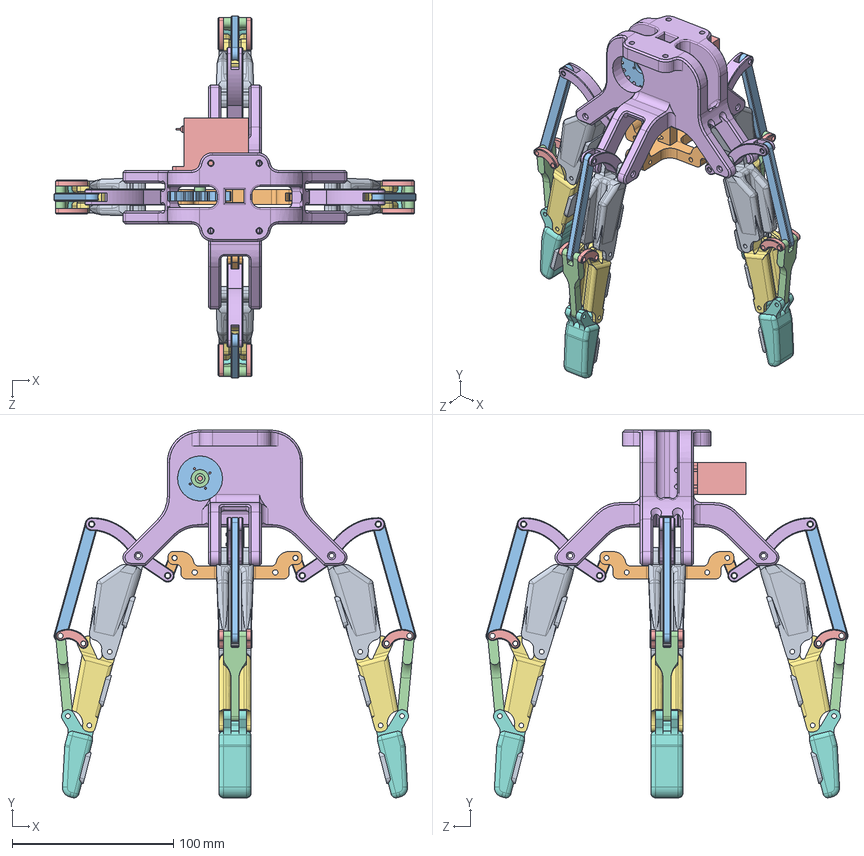
[picture p35: CAD file, 2026-11-02]
software/jetson/assets/cad/chassis-v3/【MG23】装配体.SLDASM
224.7 x 228.3 x 224.7 mm
MG23基座
MG995舵机
舵机法兰
主动-圆柱齿轮18×2
齿条30×2
指2 x 4
指1 x 4
指3 x 4
拉杆2 x 4
拉杆4 x 8
拉杆5 x 4
拉杆1 x 4
拉杆3 x 4
防撞缓冲垫 x 12
