Lurk0526/autonomous-water-transport-robot/software/jetson/assets/cad/chassis-v3/悬架带车轮装配体1.SLDASM

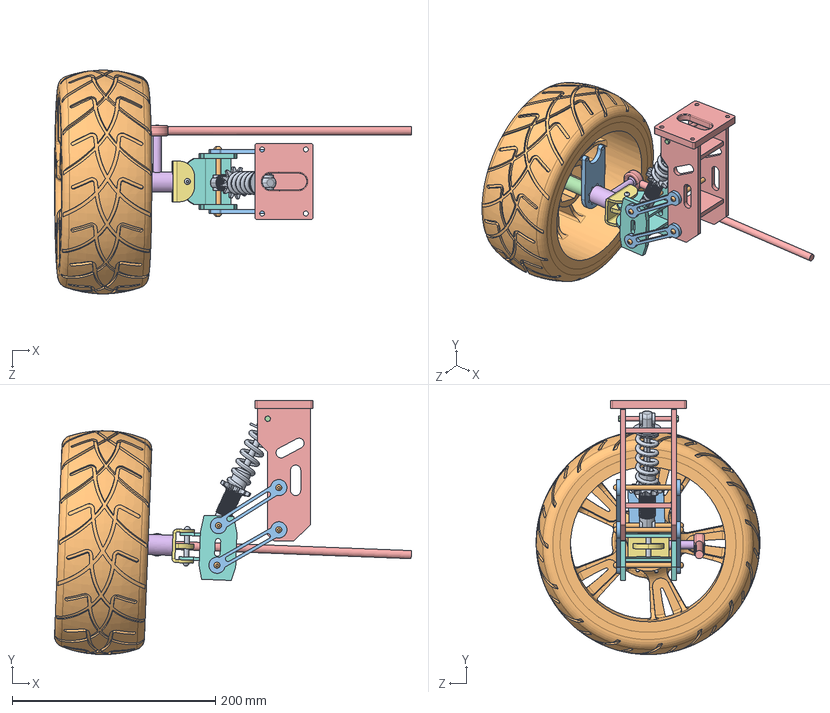
[picture p37: CAD file, 2026-11-02]
software/jetson/assets/cad/chassis-v3/悬架带车轮装配体1.SLDASM
351.0 x 249.9 x 220.0 mm
减震零件1
零件4 x 2
双连杆 x 4
螺丝 x 4
减震器
连接铁片2
钣金1
ZXLG零件1
ZXLG零件2
轮子杆
连轮子的片子
卡丁车车轮
杆件
