Lurk0526/autonomous-water-transport-robot/hardware/cad/v2/arm_parts/机械臂配件/钣金件2(1).SLDPRT

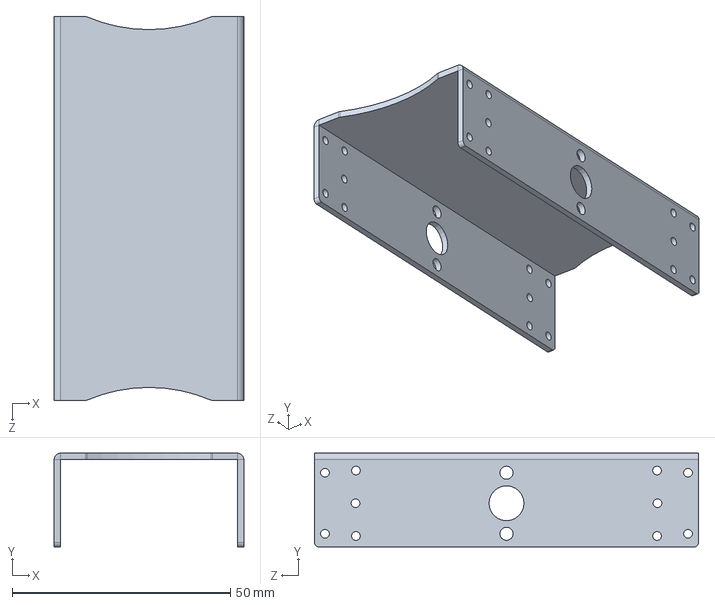
[picture p38: CAD file, 2026-11-02]
hardware/cad/v2/arm_parts/机械臂配件/钣金件2(1).SLDPRT
43.5 x 21.5 x 88.0 mm
