Lurk0526/autonomous-water-transport-robot/software/jetson/assets/cad/chassis-v3/轮子杆.SLDPRT

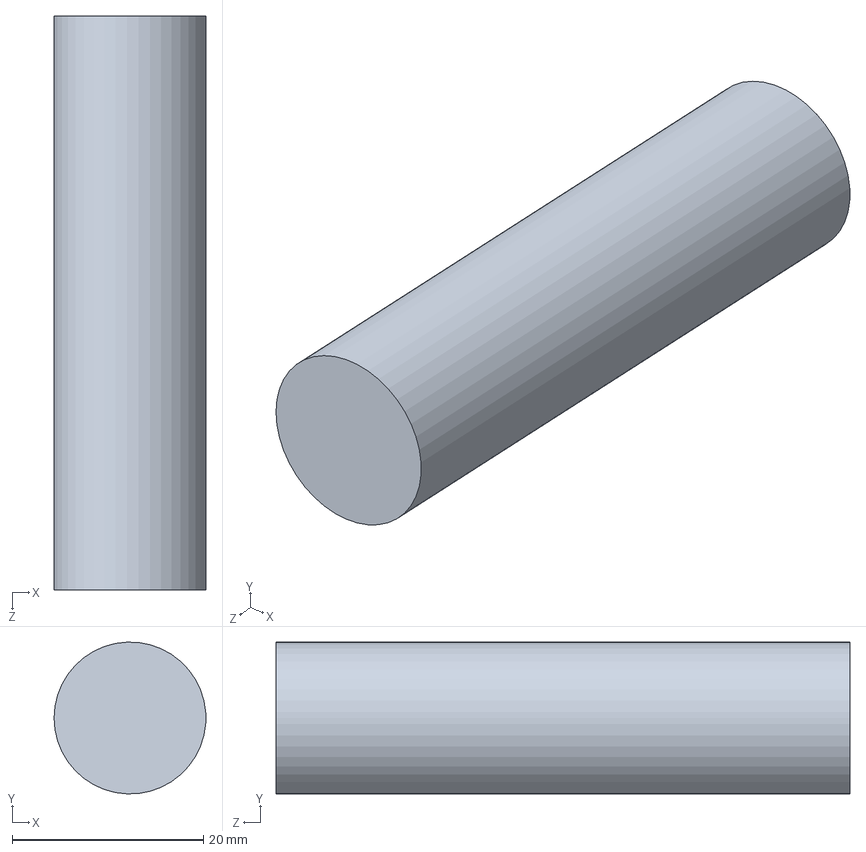
[picture p39: CAD file, 2026-11-02]
software/jetson/assets/cad/chassis-v3/轮子杆.SLDPRT
15.9 x 15.9 x 60.0 mm
