Lurk0526/autonomous-water-transport-robot/hardware/cad/v2/arm_parts/机械臂配件/钣金件1(1).SLDPRT

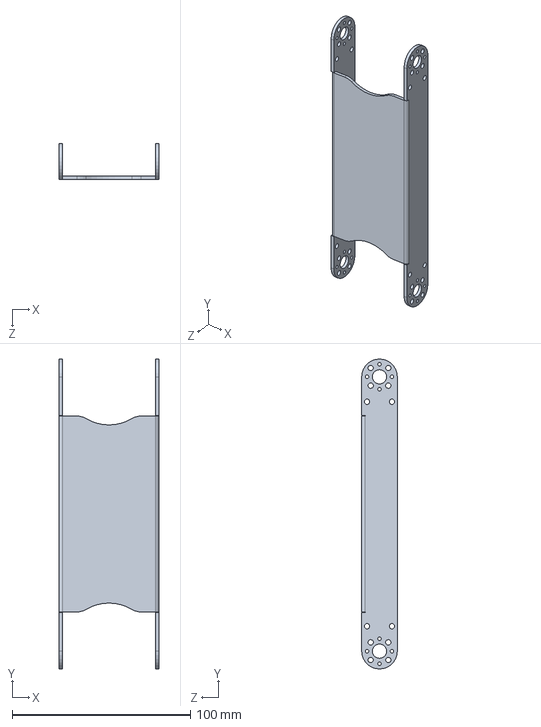
[picture p40: CAD file, 2026-11-02]
hardware/cad/v2/arm_parts/机械臂配件/钣金件1(1).SLDPRT
56.0 x 174.0 x 20.0 mm
