Lurk0526/autonomous-water-transport-robot/software/jetson/assets/cad/chassis-v3/指2.SLDPRT

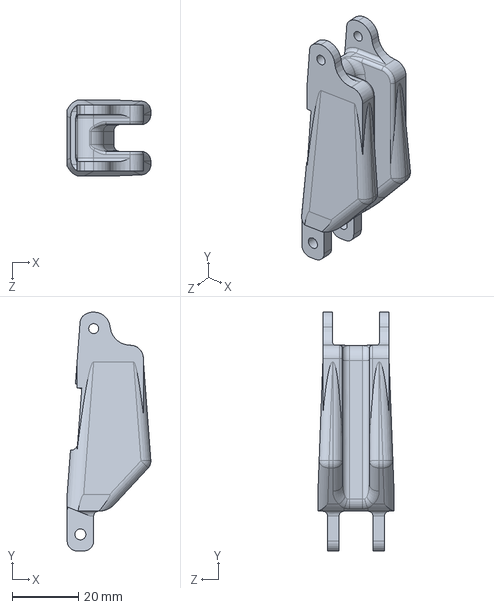
[picture p41: CAD file, 2026-11-02]
software/jetson/assets/cad/chassis-v3/指2.SLDPRT
25.2 x 72.0 x 23.0 mm
