Lurk0526/autonomous-water-transport-robot/software/jetson/assets/cad/chassis-v3/MG995舵机.SLDPRT

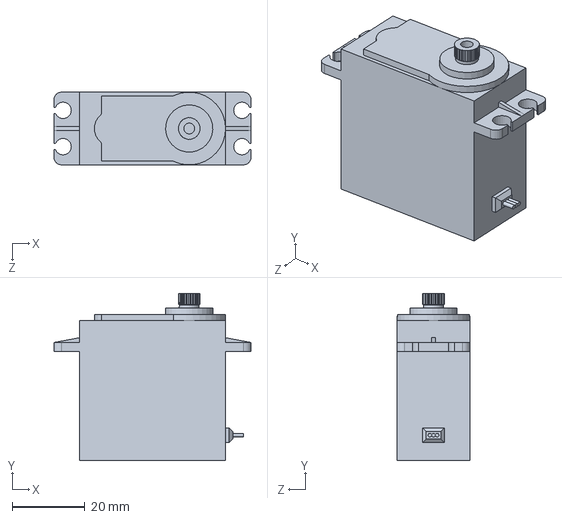
[picture p42: CAD file, 2026-11-02]
software/jetson/assets/cad/chassis-v3/MG995舵机.SLDPRT
54.2 x 46.0 x 20.0 mm
