Lurk0526/autonomous-water-transport-robot/software/jetson/assets/cad/chassis-v3/拉杆3.SLDPRT

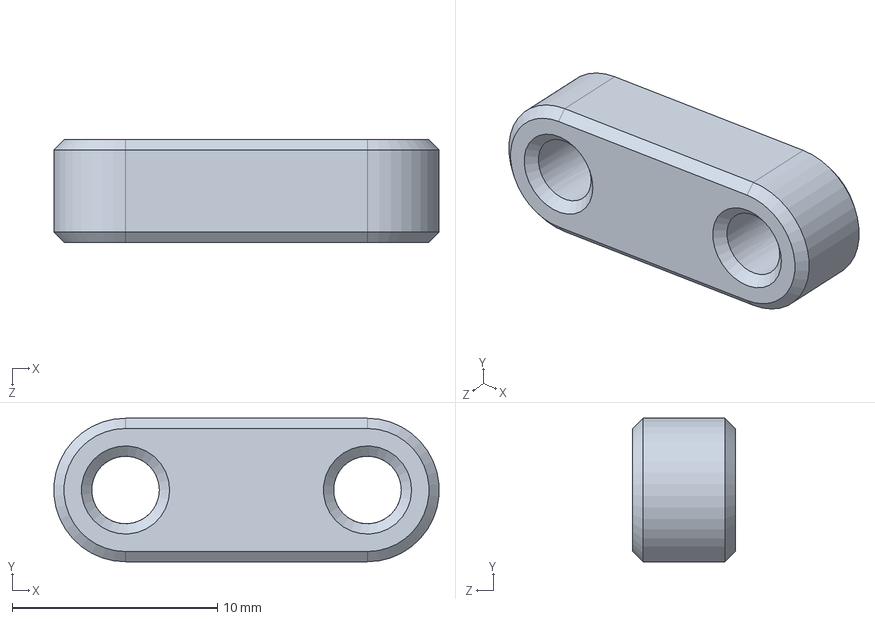
[picture p43: CAD file, 2026-11-02]
software/jetson/assets/cad/chassis-v3/拉杆3.SLDPRT
18.8 x 7.00 x 5.00 mm
