Lurk0526/autonomous-water-transport-robot/software/jetson/assets/cad/chassis-v3/拉杆2.SLDPRT

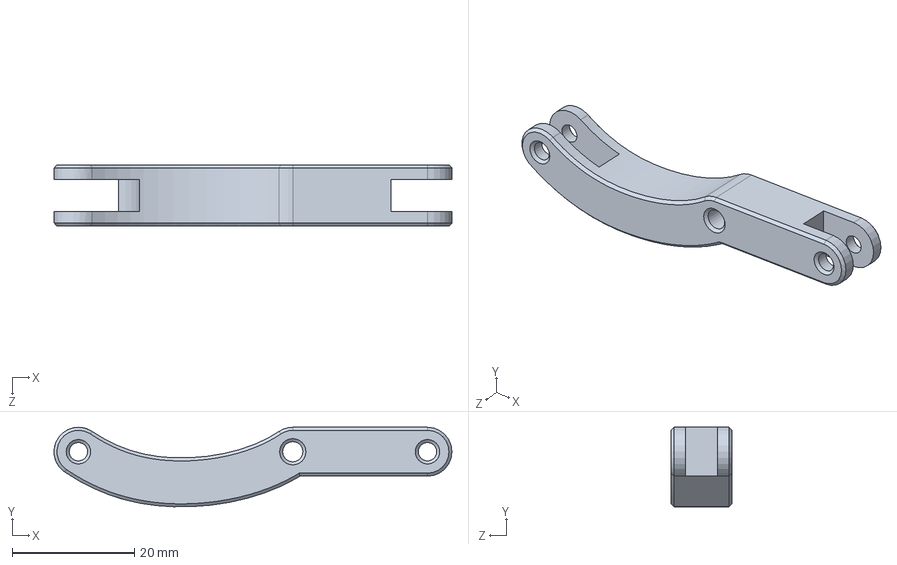
[picture p44: CAD file, 2026-11-02]
software/jetson/assets/cad/chassis-v3/拉杆2.SLDPRT
65.0 x 13.0 x 10.0 mm
