Lurk0526/autonomous-water-transport-robot/software/jetson/assets/cad/chassis-v3/杆件.SLDPRT

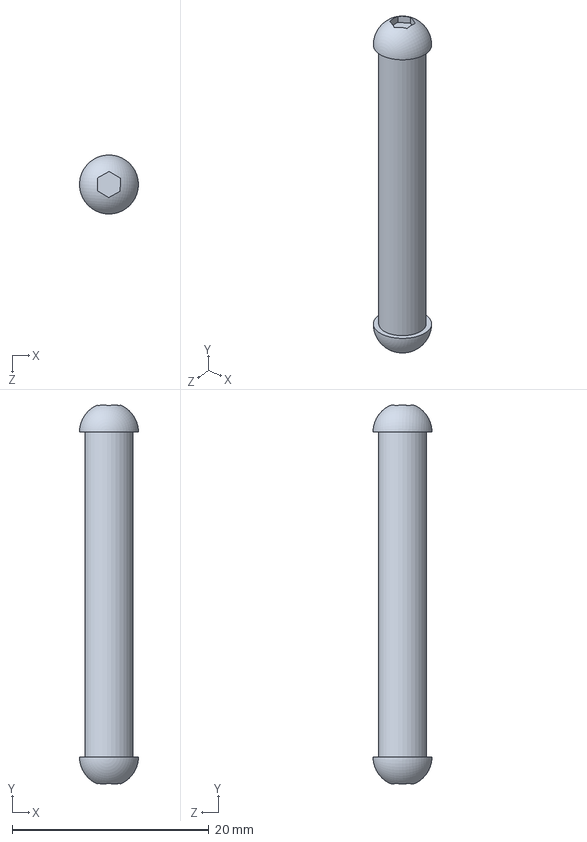
[picture p45: CAD file, 2026-11-02]
software/jetson/assets/cad/chassis-v3/杆件.SLDPRT
5.99 x 38.5 x 6.00 mm
