Lurk0526/autonomous-water-transport-robot/software/jetson/assets/cad/chassis-v3/连接铁片2.SLDPRT

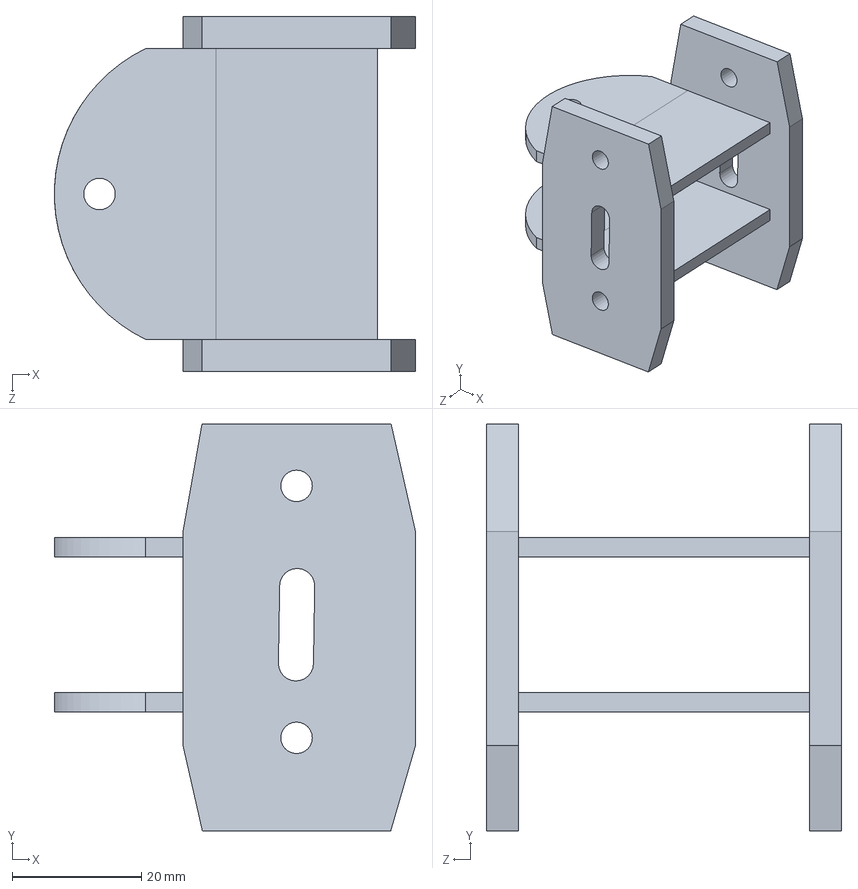
[picture p46: CAD file, 2026-11-02]
software/jetson/assets/cad/chassis-v3/连接铁片2.SLDPRT
55.9 x 63.0 x 55.0 mm
