Lurk0526/autonomous-water-transport-robot/software/jetson/assets/cad/chassis-v3/指3.SLDPRT

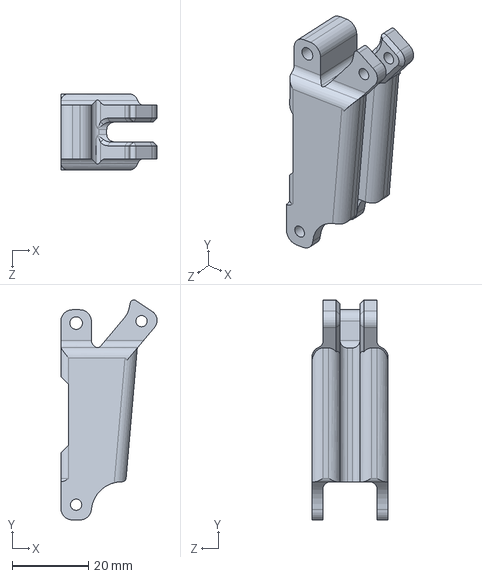
[picture p47: CAD file, 2026-11-02]
software/jetson/assets/cad/chassis-v3/指3.SLDPRT
25.2 x 57.5 x 20.0 mm
