Lurk0526/autonomous-water-transport-robot/software/jetson/assets/cad/chassis-v3/减震零件1.SLDPRT

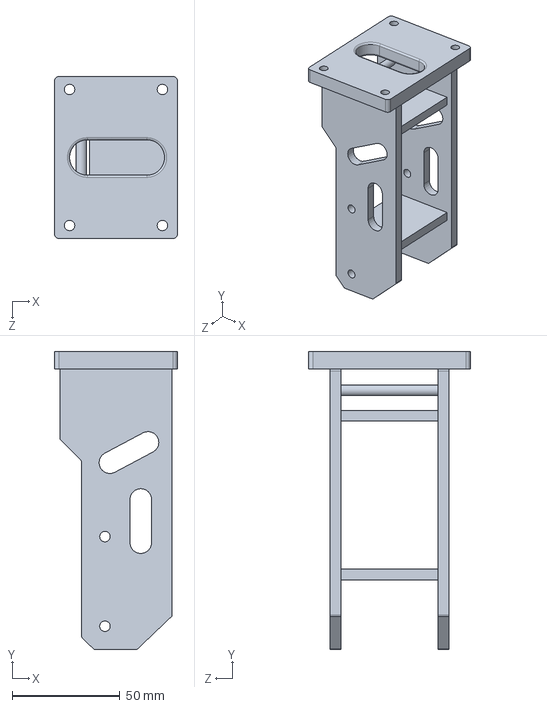
[picture p48: CAD file, 2026-11-02]
software/jetson/assets/cad/chassis-v3/减震零件1.SLDPRT
57.0 x 138.0 x 75.0 mm
