Lurk0526/autonomous-water-transport-robot/software/jetson/assets/cad/chassis-v3/ZXLG零件2.SLDPRT

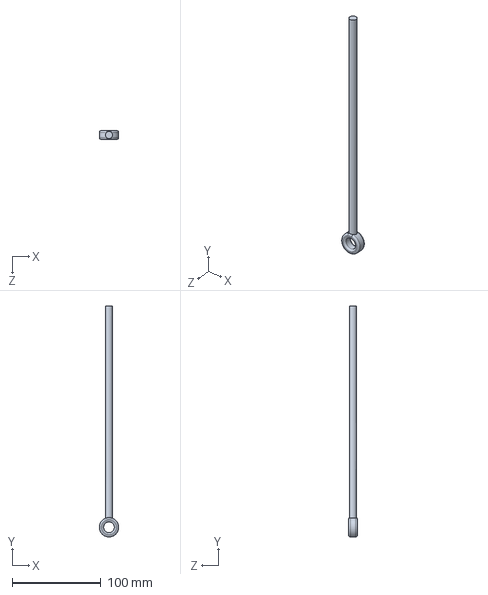
[picture p49: CAD file, 2026-11-02]
software/jetson/assets/cad/chassis-v3/ZXLG零件2.SLDPRT
22.0 x 261.0 x 10.0 mm
