Lurk0526/autonomous-water-transport-robot/software/jetson/assets/cad/chassis-v3/螺丝.SLDPRT

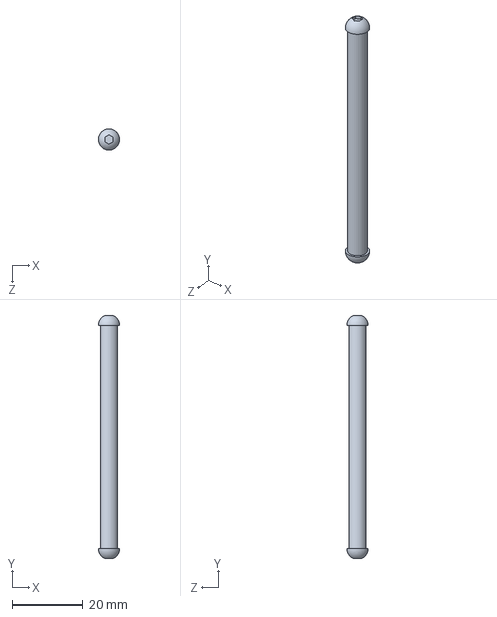
[picture p50: CAD file, 2026-11-02]
software/jetson/assets/cad/chassis-v3/螺丝.SLDPRT
5.99 x 68.5 x 6.00 mm
