Lurk0526/autonomous-water-transport-robot/software/jetson/assets/cad/chassis-v3/连轮子的片子.SLDPRT

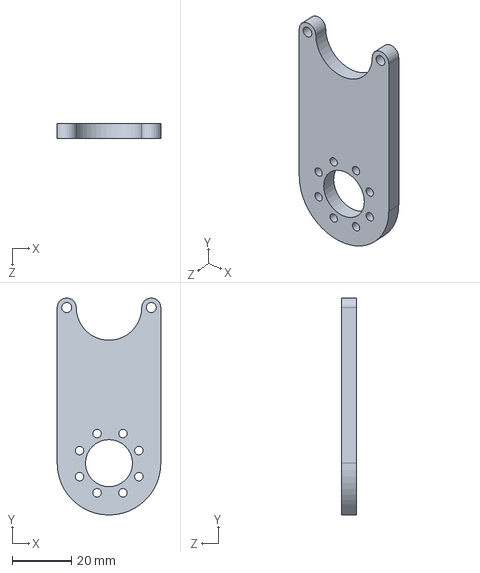
[picture p51: CAD file, 2026-11-02]
software/jetson/assets/cad/chassis-v3/连轮子的片子.SLDPRT
35.0 x 73.2 x 5.00 mm
