Lurk0526/autonomous-water-transport-robot/software/jetson/assets/cad/chassis-v3/舵机法兰.SLDPRT

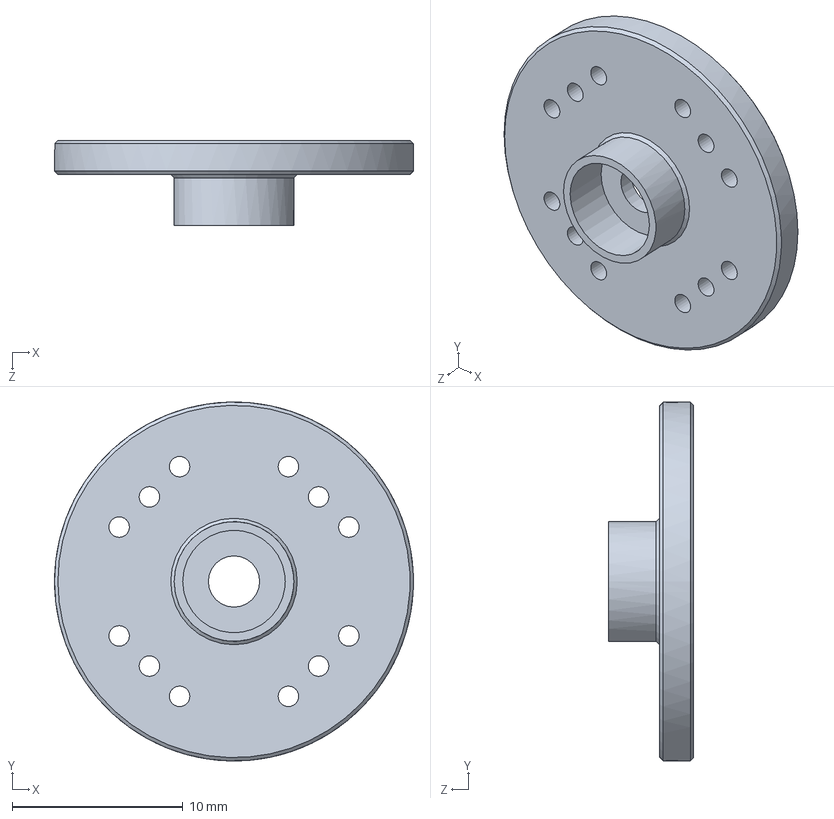
[picture p52: CAD file, 2026-11-02]
software/jetson/assets/cad/chassis-v3/舵机法兰.SLDPRT
21.0 x 21.0 x 5.00 mm
