Lurk0526/autonomous-water-transport-robot/software/jetson/assets/cad/chassis-v3/主动-圆柱齿轮18×2.SLDPRT

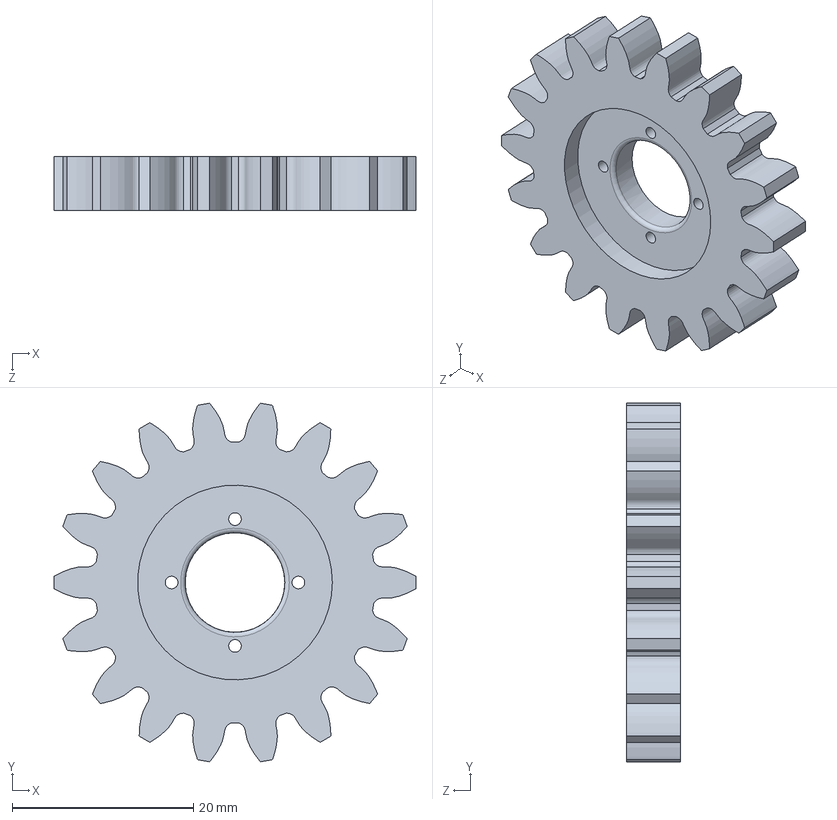
[picture p53: CAD file, 2026-11-02]
software/jetson/assets/cad/chassis-v3/主动-圆柱齿轮18×2.SLDPRT
40.0 x 39.6 x 6.00 mm
