Lurk0526/autonomous-water-transport-robot/software/jetson/assets/cad/chassis-v3/卡丁车车轮.SLDPRT

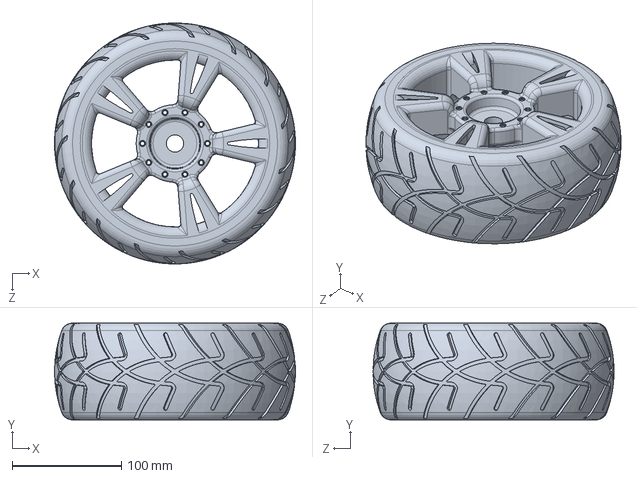
[picture p54: CAD file, 2026-11-02]
software/jetson/assets/cad/chassis-v3/卡丁车车轮.SLDPRT
220.1 x 88.5 x 220.0 mm
