Lurk0526/autonomous-water-transport-robot/software/jetson/assets/cad/chassis-v3/亚克力板.SLDPRT

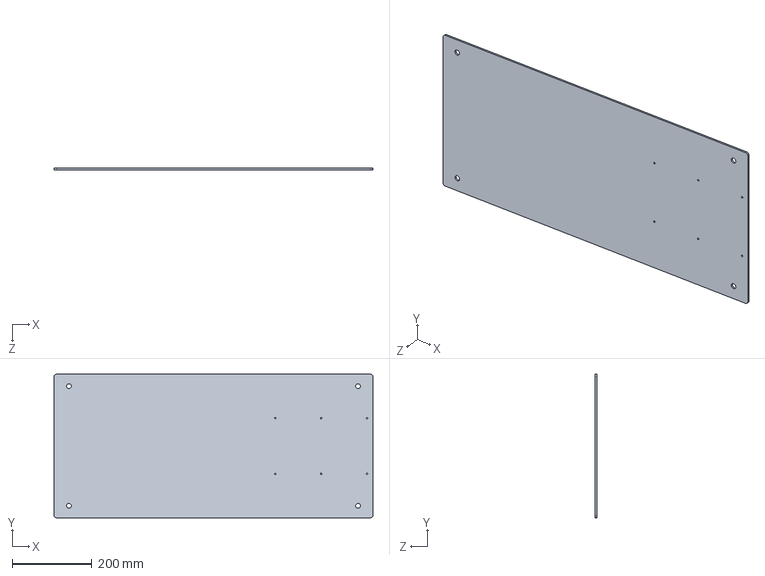
[picture p55: CAD file, 2026-11-02]
software/jetson/assets/cad/chassis-v3/亚克力板.SLDPRT
800.0 x 360.0 x 4.00 mm
