Lurk0526/autonomous-water-transport-robot/software/jetson/assets/cad/chassis-v3/零件4.SLDPRT

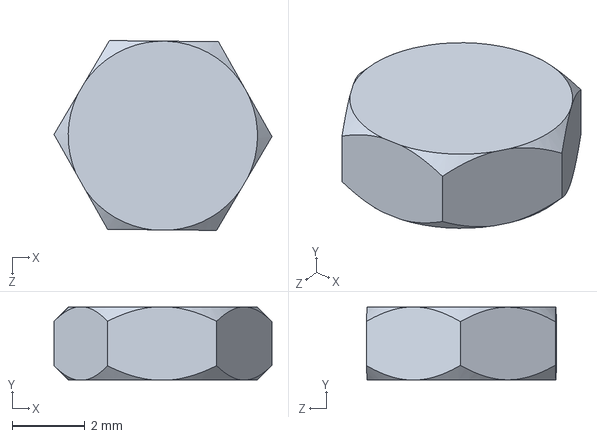
[picture p56: CAD file, 2026-11-02]
software/jetson/assets/cad/chassis-v3/零件4.SLDPRT
6.00 x 2.00 x 5.23 mm
