Lurk0526/autonomous-water-transport-robot/software/jetson/assets/cad/chassis-v3/齿条30×2.SLDPRT

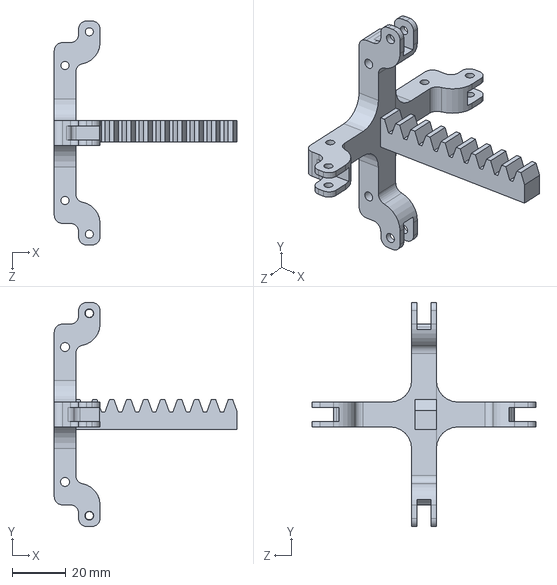
[picture p57: CAD file, 2026-11-02]
software/jetson/assets/cad/chassis-v3/齿条30×2.SLDPRT
67.6 x 83.0 x 83.0 mm
