Lurk0526/autonomous-water-transport-robot/software/jetson/assets/cad/chassis-v3/拉杆4.SLDPRT

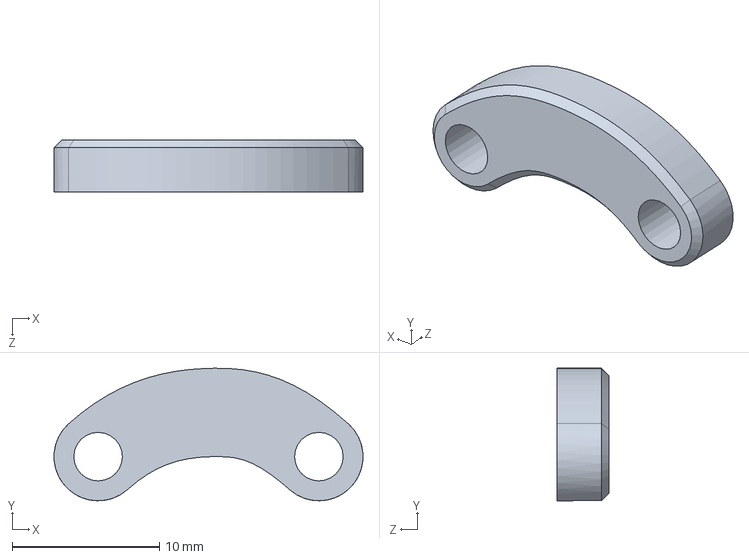
[picture p58: CAD file, 2026-11-02]
software/jetson/assets/cad/chassis-v3/拉杆4.SLDPRT
21.0 x 9.01 x 3.50 mm
