Lurk0526/autonomous-water-transport-robot/software/jetson/assets/cad/chassis-v3/新车架第三版.SLDPRT

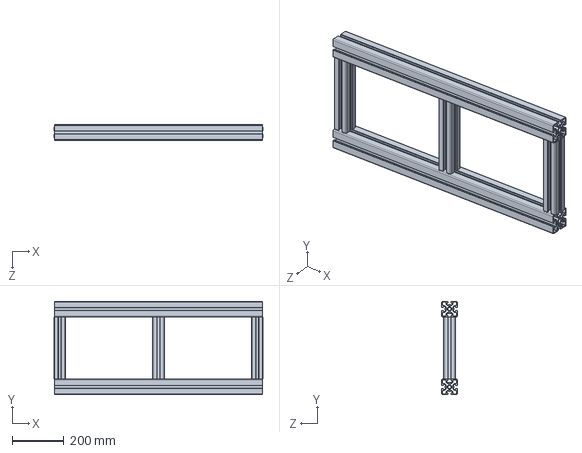
[picture p59: CAD file, 2026-11-02]
software/jetson/assets/cad/chassis-v3/新车架第三版.SLDPRT
805.0 x 360.0 x 60.0 mm
