Lurk0526/autonomous-water-transport-robot/software/jetson/assets/cad/chassis-v3/拉杆5.SLDPRT

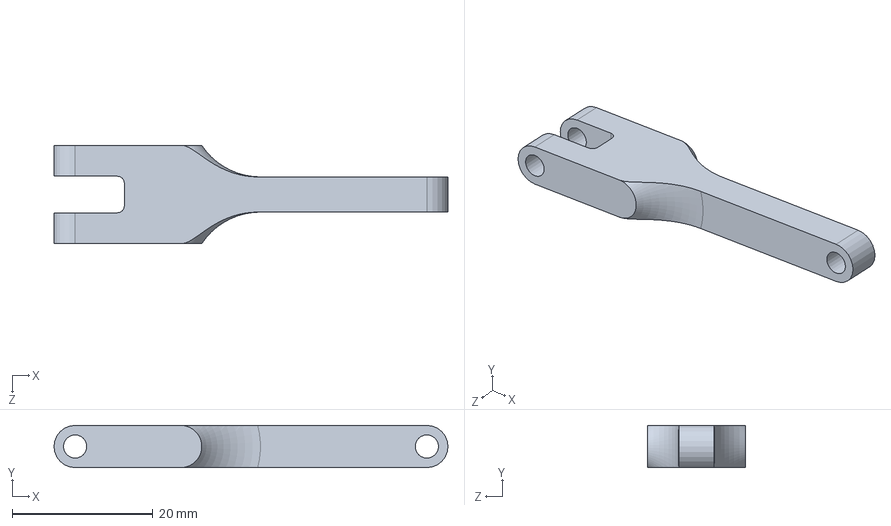
[picture p60: CAD file, 2026-11-02]
software/jetson/assets/cad/chassis-v3/拉杆5.SLDPRT
56.0 x 6.00 x 14.0 mm
