Lurk0526/autonomous-water-transport-robot/software/jetson/assets/cad/chassis-v3/双连杆.SLDPRT

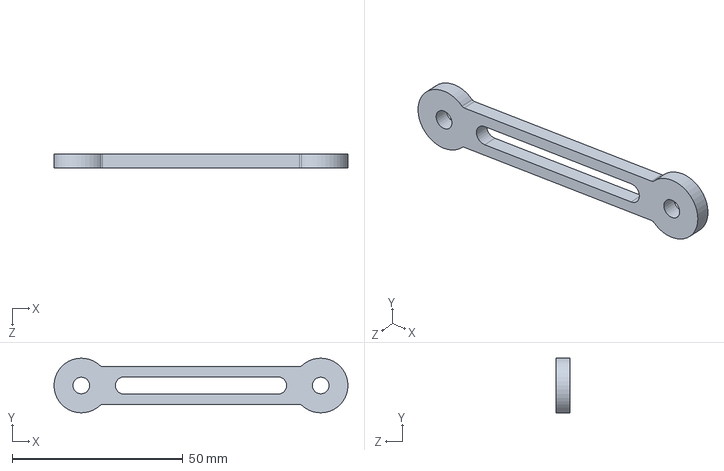
[picture p61: CAD file, 2026-11-02]
software/jetson/assets/cad/chassis-v3/双连杆.SLDPRT
86.0 x 16.0 x 4.00 mm
