Lurk0526/autonomous-water-transport-robot/software/jetson/assets/cad/chassis-v3/指1.SLDPRT

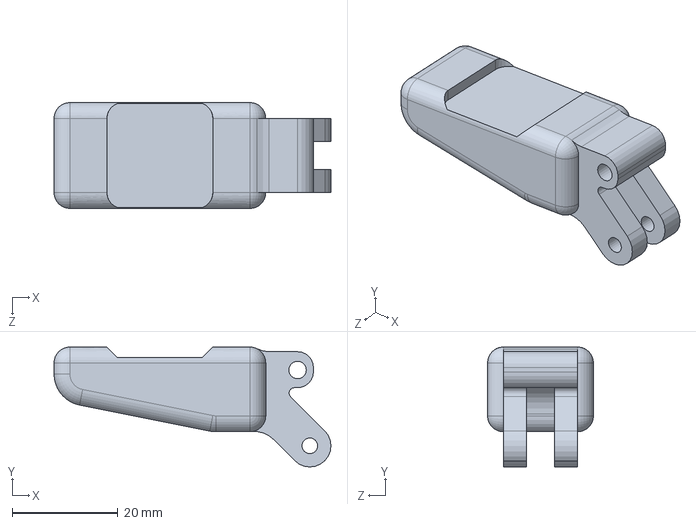
[picture p62: CAD file, 2026-11-02]
software/jetson/assets/cad/chassis-v3/指1.SLDPRT
52.3 x 22.7 x 20.0 mm
