Lurk0526/autonomous-water-transport-robot/software/jetson/assets/cad/chassis-v3/拉杆1.SLDPRT

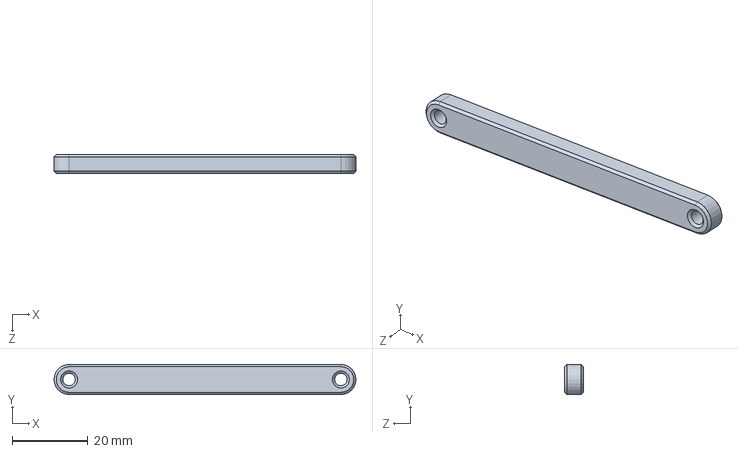
[picture p63: CAD file, 2026-11-02]
software/jetson/assets/cad/chassis-v3/拉杆1.SLDPRT
80.0 x 8.00 x 5.00 mm
