Lurk0526/autonomous-water-transport-robot/software/jetson/assets/cad/chassis-v3/ZXLG零件1.SLDPRT

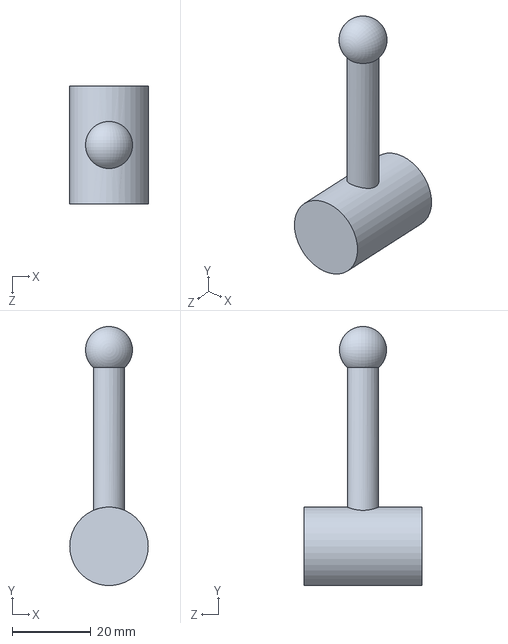
[picture p64: CAD file, 2026-11-02]
software/jetson/assets/cad/chassis-v3/ZXLG零件1.SLDPRT
20.0 x 65.9 x 30.0 mm
