Lurk0526/autonomous-water-transport-robot/software/jetson/assets/cad/chassis-v3/防撞缓冲垫.SLDPRT

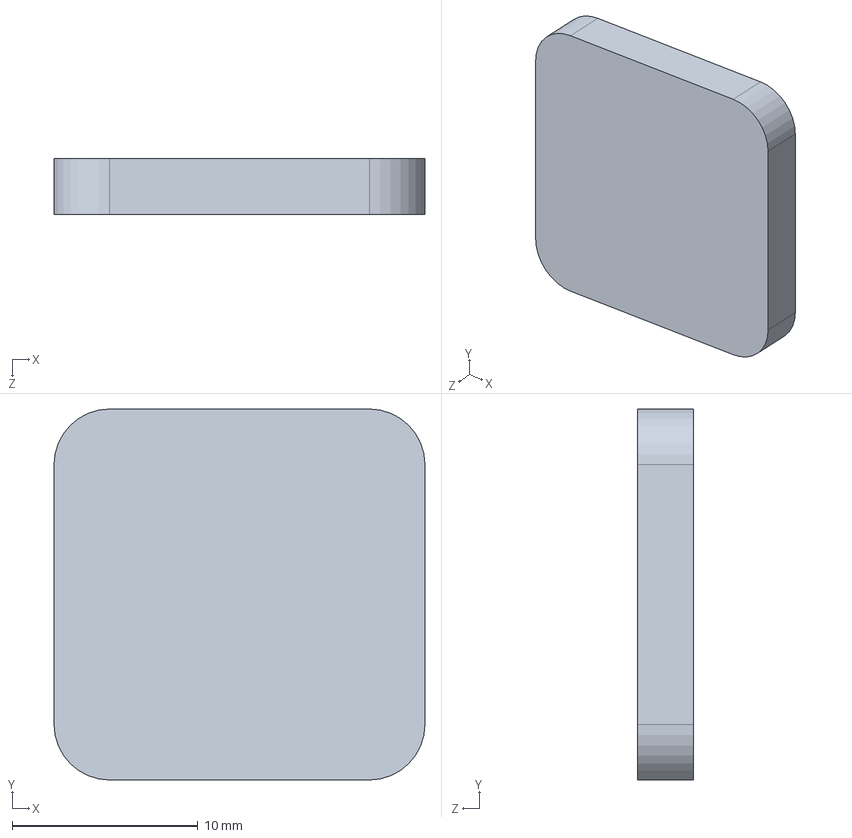
[picture p65: CAD file, 2026-11-02]
software/jetson/assets/cad/chassis-v3/防撞缓冲垫.SLDPRT
20.0 x 20.0 x 3.00 mm
