Lurk0526/autonomous-water-transport-robot/software/jetson/assets/cad/chassis-v3/MG23基座.SLDPRT

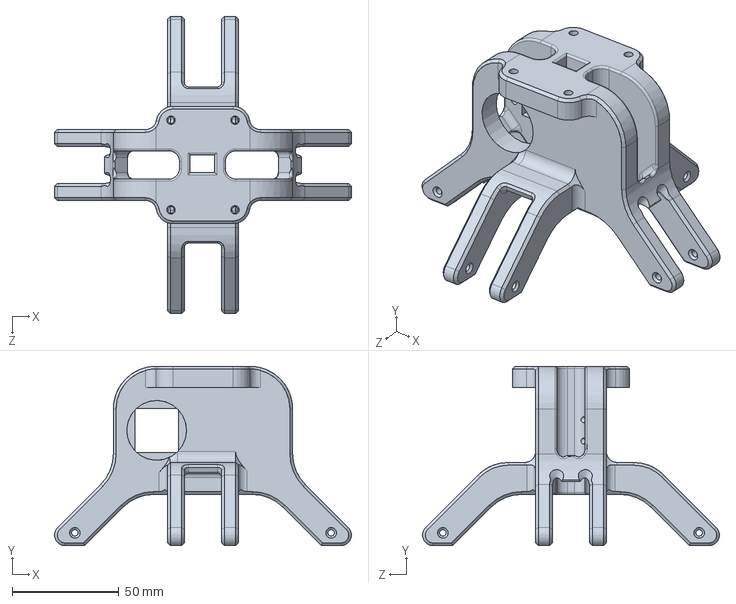
[picture p66: CAD file, 2026-11-02]
software/jetson/assets/cad/chassis-v3/MG23基座.SLDPRT
139.1 x 84.0 x 139.1 mm
