Lurk0526/autonomous-water-transport-robot/software/jetson/assets/cad/chassis-v3/夹爪与机械臂连接件.SLDPRT

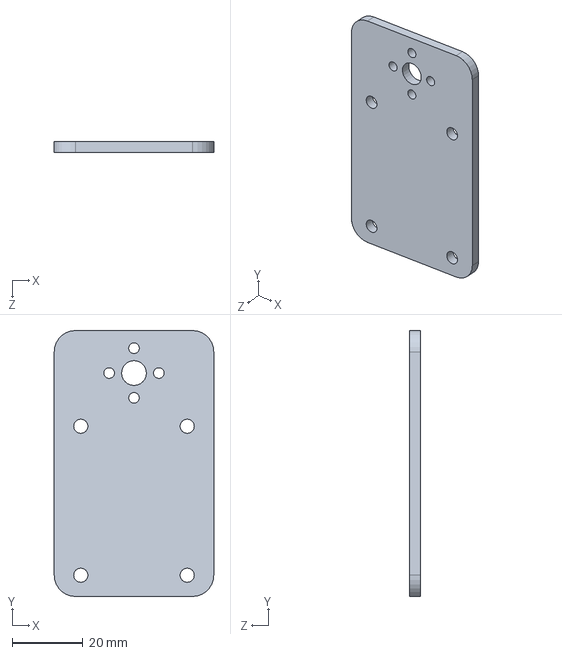
[picture p67: CAD file, 2026-11-02]
software/jetson/assets/cad/chassis-v3/夹爪与机械臂连接件.SLDPRT
45.0 x 75.0 x 3.00 mm
