Lurk0526/autonomous-water-transport-robot/software/jetson/assets/cad/chassis-v3/减震器.SLDPRT

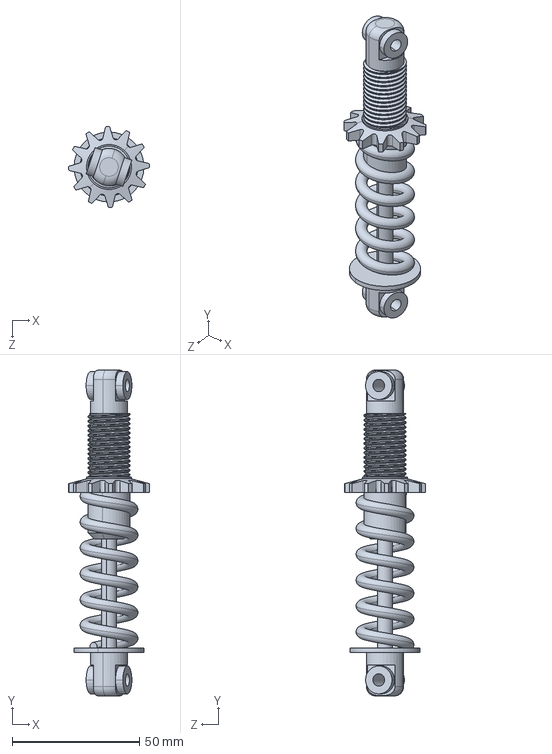
[picture p68: CAD file, 2026-11-02]
software/jetson/assets/cad/chassis-v3/减震器.SLDPRT
31.7 x 128.1 x 31.7 mm
