Lurk0526/autonomous-water-transport-robot/software/jetson/assets/cad/chassis-v3/钣金1.SLDPRT

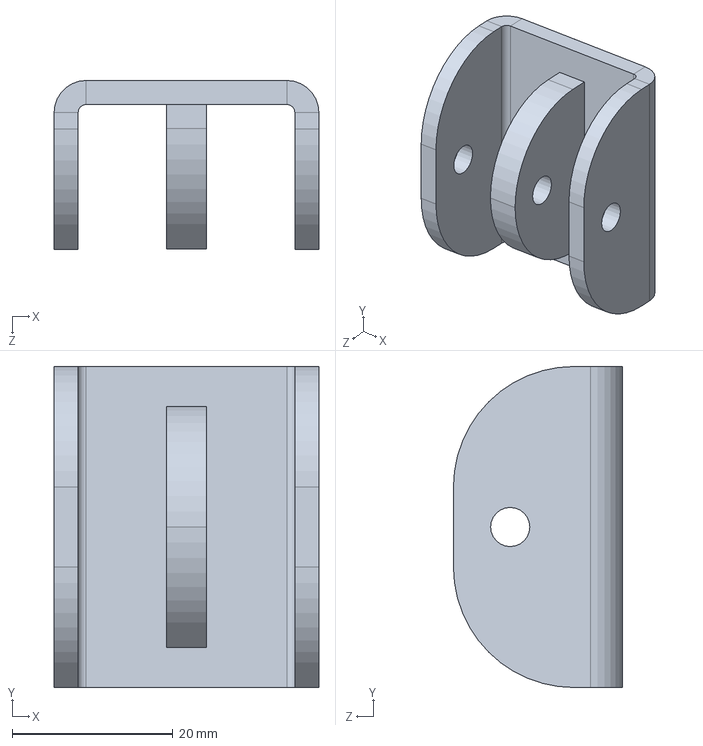
[picture p69: CAD file, 2026-11-02]
software/jetson/assets/cad/chassis-v3/钣金1.SLDPRT
33.0 x 40.0 x 21.1 mm
