Lurk0526/autonomous-water-transport-robot/hardware/cad/v2/arm_parts/机械臂配件/jibot1-240103_asm.SLDASM

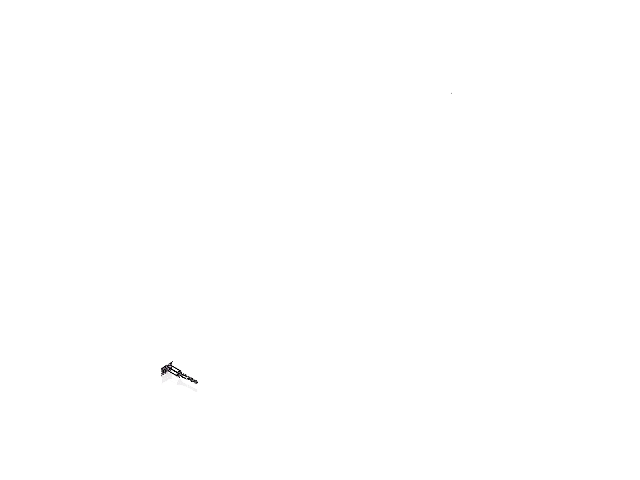
[picture p70: CAD file, 2026-11-02]
hardware/cad/v2/arm_parts/机械臂配件/jibot1-240103_asm.SLDASM
PRODUCT_21630 x 4
PRODUCT_68796 x 5
M4X40________ x 4
钣金件2(1)
PRODUCT_7387
PRODUCT_10168
__U____-55436
钣金件1(1)
__U____-22069
M4X18001 x 8
MD002 x 4
M3X8001 x 16
M2Z001 x 50
ZPK001
TM3S8S x 4
SBJS001
TM3X8D001 x 4
J1DB001
