Lurk0526/autonomous-water-transport-robot/software/jetson/assets/cad/chassis-v3/新机械臂.SLDASM

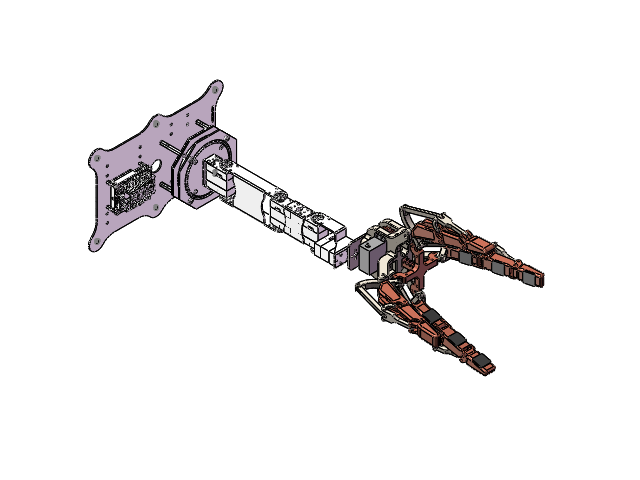
[picture p72: CAD file, 2026-11-02]
software/jetson/assets/cad/chassis-v3/新机械臂.SLDASM
PRODUCT_21630 x 4
PRODUCT_68796 x 5
M4X40________ x 4
__C____
PRODUCT_7387
PRODUCT_10168
__U____-55436
__U____-42848
__U____-22069
ZPK001
TM3S8S x 4
SBJS001
TM3X8D001 x 4
M3X8001 x 16
M4X18001 x 8
J1DB001
MD002 x 4
M2Z001 x 49
MG23基座
MG995舵机
舵机法兰
主动-圆柱齿轮18×2
齿条30×2
指2 x 4
指1 x 4
指3 x 4
拉杆2 x 4
拉杆4 x 8
拉杆5 x 4
拉杆1 x 4
拉杆3 x 4
防撞缓冲垫 x 12
夹爪与机械臂连接件
