Lurk0526/autonomous-water-transport-robot/software/jetson/assets/cad/chassis-v3/机械臂主体.SLDASM

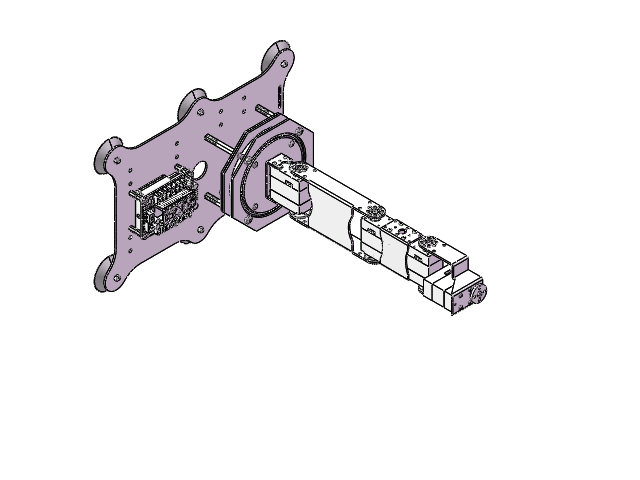
[picture p73: CAD file, 2026-11-02]
software/jetson/assets/cad/chassis-v3/机械臂主体.SLDASM
PRODUCT_21630 x 4
PRODUCT_68796 x 5
M4X40________ x 4
__C____
PRODUCT_7387
PRODUCT_10168
__U____-55436
__U____-42848
__U____-22069
ZPK001
TM3S8S x 4
SBJS001
TM3X8D001 x 4
M3X8001 x 16
M4X18001 x 8
J1DB001
MD002 x 4
M2Z001 x 49
