Lurk0526/autonomous-water-transport-robot/software/jetson/assets/cad/chassis-v3/第三版底盘.SLDASM

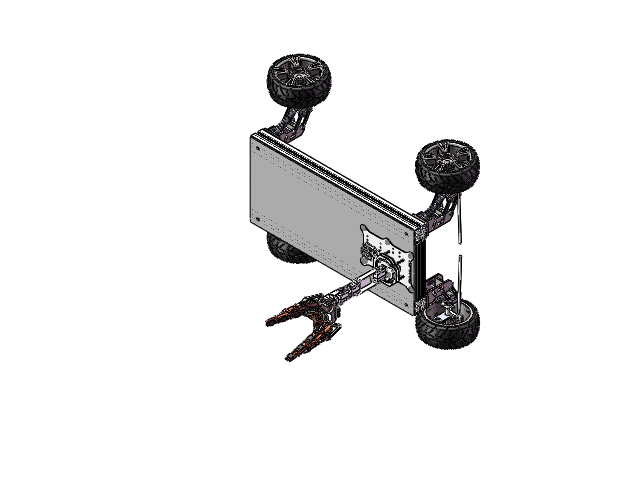
[picture p74: CAD file, 2026-11-02]
software/jetson/assets/cad/chassis-v3/第三版底盘.SLDASM
新车架第三版
减震零件1 x 4
零件4 x 8
双连杆 x 16
螺丝 x 16
减震器 x 4
连接铁片2 x 4
钣金1 x 4
ZXLG零件1 x 4
ZXLG零件2 x 2
轮子杆 x 4
连轮子的片子 x 4
卡丁车车轮 x 4
杆件 x 4
TPGY-4510-4545 x 8
亚克力板
PRODUCT_21630 x 4
PRODUCT_68796 x 5
M4X40________ x 4
__C____
PRODUCT_7387
PRODUCT_10168
__U____-55436
__U____-42848
__U____-22069
ZPK001
TM3S8S x 4
SBJS001
TM3X8D001 x 4
M3X8001 x 16
M4X18001 x 8
J1DB001
MD002 x 4
M2Z001 x 49
MG23基座
MG995舵机
舵机法兰
主动-圆柱齿轮18×2
齿条30×2
指2 x 4
指1 x 4
指3 x 4
拉杆2 x 4
拉杆4 x 8
拉杆5 x 4
拉杆1 x 4
拉杆3 x 4
防撞缓冲垫 x 12
夹爪与机械臂连接件
