Lurk0526/autonomous-water-transport-robot/(list of files, cad)

Other CAD files:
software/jetson/assets/cad/chassis-v3/jibot1-240103_asm(2).SLDASM
hardware/cad/v2/arm_parts/机械臂配件/装配体1.SLDASM
software/jetson/assets/cad/chassis-v3/PRODUCT_49810_ASM.SLDASM
software/jetson/assets/cad/chassis-v3/________JIBOT1__-221125_ASM.SLDASM
software/jetson/assets/cad/chassis-v3/悬架带车轮装配体2.SLDASM
software/jetson/assets/cad/chassis-v3/KSZ001_ASM.SLDASM
software/jetson/assets/cad/chassis-v3/___________STEP_ASM.SLDASM
hardware/cad/v2/arm_parts/机械臂配件/XP001.SLDPRT
hardware/cad/v2/arm_parts/机械臂配件/GB6170-M3_________STEP.SLDPRT
software/jetson/assets/cad/chassis-v3/TPGY-4510-4545.SLDPRT
software/jetson/assets/cad/chassis-v3/PRODUCT_7387.SLDPRT
software/jetson/assets/cad/chassis-v3/M2Z001.SLDPRT
software/jetson/assets/cad/chassis-v3/________1.SLDPRT
software/jetson/assets/cad/chassis-v3/TM3S8S.SLDPRT
software/jetson/assets/cad/chassis-v3/________3.SLDPRT
software/jetson/assets/cad/chassis-v3/PRODUCT_10168.SLDPRT
software/jetson/assets/cad/chassis-v3/MD002.SLDPRT
software/jetson/assets/cad/chassis-v3/PRODUCT_21630.SLDPRT
software/jetson/assets/cad/chassis-v3/ZPK001.SLDPRT
software/jetson/assets/cad/chassis-v3/__U____-22069.SLDPRT
software/jetson/assets/cad/chassis-v3/TM3X8D001.SLDPRT
software/jetson/assets/cad/chassis-v3/PRODUCT_68796.SLDPRT
software/jetson/assets/cad/chassis-v3/__C____.SLDPRT
software/jetson/assets/cad/chassis-v3/__U____-42848.SLDPRT
software/jetson/assets/cad/chassis-v3/__U____-55436.SLDPRT
software/jetson/assets/cad/chassis-v3/J1DB001.SLDPRT
software/jetson/assets/cad/chassis-v3/________2.SLDPRT
software/jetson/assets/cad/chassis-v3/SBJS001.SLDPRT
software/jetson/assets/cad/chassis-v3/M3X8001.SLDPRT
software/jetson/assets/cad/chassis-v3/M4X18001.SLDPRT
software/jetson/assets/cad/chassis-v3/M4X40________.SLDPRT
