Lurk0526/autonomous-water-transport-robot/software/jetson/docs/gemini-max-setup-report-20261029.md

# Gemini MAX 环境实测记录（2026-10-29）

结果：驱动编译、真实数据流、相机内部 TF、点云几何一致性、服务重启和源码复现均通过。

| 数据流 | 15 秒最终实测帧率（Hz） |
|---|---:|
| rgb | 30.13 |
| depth | 30.11 |
| rectified_depth | 30.11 |
| rgb_info | 30.13 |
| depth_info | 30.11 |
| points | 30.11 |
| scan | 30.11 |

当前场景深度有效像素比例：91.67%；深度中位数：2.25 米。
扫描有效角度范围约 67.75°，当前最近回波约 1.91 米。

点云检查比较了同一时间戳的 234436 个有效点。以深度图和内参反投影，与 SDK 点云 XYZ 对比，中位误差均小于 0.001 毫米。该检查验证软件坐标和单位一致性，不代表真实测距精度。

GPU 检查：现有项目环境 PyTorch 2.8.0、CUDA runtime 12.9，识别 GPU Orin，CUDA 张量矩阵乘法执行成功。
用户服务 gemini-max 已启用，当前运行；服务停止后重新启动、再次检查数据流通过。
源码提取与 Jazzy 补丁可完整复现当前驱动源码，文件逐一比较无差异。

任务场地已明确为试验场西北角室外砖路，包含直线、颠簸、转弯、避障、加速。
未进行车体安装外参标定、地面过滤调参或真实底盘闭环避障；未加载经过该砖路场景验证的路径识别模型。
用户已确认相机仍在调试、尚未固定；当前画面倒置，保留原始输出，安装外参和最终朝向校正留待固定后处理。

检查数据：work/gemini/health.json、work/gemini/geometry.json。
配置与操作说明：docs/gemini-max-ros2.md。
