Lurk0526/autonomous-water-transport-robot/software/jetson/CHANGELOG.md

# 版本记录

## 循迹主导航与真实输入接入 — 2026-11-01

- 根据用户最新要求，循迹为主、无标线为备用，线色先兼容黑/白/黄。新增图像检测、已标定地面投影、连续帧确认、丢线切换与不确定路口停车。
- 增加10项图像闭环循迹主方案，备用场景从22项扩到38项；包含曲线走廊绕障、交叉路线进度、模型不匹配、冻结位姿、未来时间戳及无绝对校正的不确定度增长。
- 实际接通Gemini MAX并恢复热插拔后的RGB流，记录深度全零及用户调整后恢复。321帧RGB/320帧深度约30Hz、同步/内参/内部TF/投影检查通过；补录带感知输出和元数据的真实记录。
- 新增只读底盘/IMU/转角/感知适配器、参数证据导入、轮速/陀螺仪定位基线、真实RGB-D帧间PnP筛查、保守地面网格、候选制动拟合、现场采集与接入验收入口。
- 真实底盘、参数、安装外参和现场赛道仍未提供/验收；对应项保持待接入，未发送运动指令，未将室内记录作为现场通过。

## 无标线整车算法仿真 — 2026-11-01

- 新增标准库运行的前轮转向运动学、Pure Pursuit、转角/加速度/jerk 限制、独立传感器与指令延迟。
- 新增已知直走廊内的平滑候选绕障、车体几何检查与受阻停车；道路边界不随绕障路径改变。
- 取放监督器接入运行中的模拟车辆；抓取、承托、运输夹持反馈缺失分别检查。反馈与参数均明确为合成数据，不修改原实体控制配置。
- 保存 22 项导航、4 项流程、27 组敏感性场景，以及单独展示的碰撞反例、全采样 CSV 和离线交互报告。新增独立几何、时步、约束与闭环回归测试。
- 没有运行 Isaac Sim/Lab，没有模拟物理液体，没有发送硬件命令；真实定位、外参、制动、关节接触和洒水留待后续验收。

## v1.2.0 — 2026-10-25

- 居中保持门槛由约 9 px 缩小为 4.8 px；位置滤波、近距离增益和肘腕分配提高小幅移动响应。
- 动作时间 500→400 ms，动作后等待 200→60 ms；规划周期 80→60 ms，连续续接 220→200 ms，续接误差门槛 30→12 px。
- 关节分配变化时依据真实停止反馈释放旧动作，并等待新图像重新规划；不再等待旧动作自然结束。
- 多次短动作均无实测位移时，按累计有效动作时间逐步补偿方向死区；正常进展和间隔过久的动作不会触发这项补偿。
- 清晰、唯一的目标碗连续出现三帧后可在画面任意位置重新锁定；连续快速移动与仍然新鲜的跳帧减少重复确认，多个清晰候选仍保持停止。
- 六关节 P500～P2500 启动与端点接力继续生效；个别关节图像响应为零时，由仍可观测的关节完成纠偏。
- 206 项测试通过，另验证 64 种六关节端点组合与 4 种图像旋转下的可行纠偏；记录见 `docs/responsive-follow-20261025.md`。
- 用户移动测试最终反馈“可以”。配置已持久保存；整机断电重启流程尚未实测，不作为本轮已验证项目。

## v1.1.0 — 2026-10-25

- 根据用户明确要求及安全确认，使用六关节 P500～P2500 全范围启动，配置持久保存在 `config/bowl-follow.runtime.json`。
- 启动、控制规划、位移窗口和自动标定共用所选范围；已有工作目录也会应用当前配置，重启不会恢复原来的局部范围。
- 与保存模型差异较大的新姿态自动在当前位置测量方向，避免直接套用远处姿态的响应。
- 192 项测试通过，包含六关节两端启动、当前 P1229/P590 姿态、端点向内规划及上下端点双向标定模拟；实机记录见 `docs/full-range-follow-20261025.md`。

- 本机相机、检测、Isaac 与跟随节点默认使用回环 DDS 通信，避免 Wi-Fi 地址改变后继续向旧地址发送；保留显式中间件和 DDS 配置。
- 从当前位置启动时，先报告所有超出所选范围的关节、实测位置及允许范围，避免等待目标后只报 `Invalid calibrated bounds/direction for joint 2`。
- 保留 v1.0.0 的控制参数、原姿态模型和发布快照；全范围配置与新姿态测量单独保存。
- 跨进程 ROS 收发、实机 RGB/识别/Isaac BGR 数据流均通过检查。
- 实机从肘部约 P1229、腕部约 P590 的低位姿态完成新测量并居中；停止并重启视觉界面后，7.18 秒直接恢复跟随，未生成新探测报告。

## v1.0.0 — 2026-10-23

用户实机确认：“不卡了，成功，把这次调参定位初版”。

- 底座、肘、腕三轴跟随；肘部参与常规纠偏，并与腕部渐进交接。
- 位移向量平滑、0.22 s 同向续接、近目标减速、居中及丢目标停止。
- 肘部负向偏差单独补偿，预计实际单步位移仍限制为 65 P。
- 核对最后运动轨迹内的肘部负载回弹，避免已观察到的 14 P 回弹误触发退出。
- 重启时读取当前位置、选择已测模型，无需恢复初始姿态或重新探测。
- 固定参数与模型保存到 `config/bowl-follow.v1.json`、`config/pose-response-library.v1.json`。
- 132 项离线测试通过，包括没有工作目录时直接从初版参数与模型启动。

源码、参数和验收记录归档为 `releases/bowl-follow-v1.0.0.zip`。后续调参另建版本，保留此初版快照。
