Lurk0526/autonomous-water-transport-robot/(commit log)

2026-11-02 Organize AstraGO project documentation, v2 CAD and stage evidence
    [GB6170-M3_________STEP.SLDPRT, J1DB001.SLDPRT, KSZ001_ASM.SLDASM, M2Z001.SLDPRT, M3X8001.SLDPRT, M4X18001.SLDPRT, M4X40________.SLDPRT, MD002.SLDPRT]
2026-11-02 Add Jetson runtime entry points and dependency records
2026-11-02 Add camera, perception, training and cart configs
    [gemini-max-color-calibration.yaml]
2026-11-02 Add Jetson deployment and algorithm documentation
2026-11-02 Add recorded serial and Gemini driver patches
2026-11-02 Add joint and grasp measurement worksheets
    [01_关节与夹爪记录.csv, 02_关节运动采样.csv, 03_抓放关键姿态.csv, 04_遥控抓放试验.csv]
2026-11-02 Add bowl and course CAD reference images
2026-11-02 Index the existing Jetson implementation
2026-11-02 Preserve Jetson CAD assets part 1 of 3
    [J1DB001.SLDPRT, KSZ001_ASM.SLDASM, M2Z001.SLDPRT, M3X8001.SLDPRT, M4X18001.SLDPRT, M4X40________.SLDPRT, MD002.SLDPRT, MG23基座.SLDPRT]
2026-11-02 Preserve Jetson CAD assets part 2 of 3
    [减震器.SLDPRT, 减震零件1.SLDPRT, 卡丁车车轮.SLDPRT, 双连杆.SLDPRT, 夹爪与机械臂连接件.SLDPRT, 悬架带车轮装配体1.SLDASM, 悬架带车轮装配体2.SLDASM, 悬架带车轮装配体无拉杆.SLDASM]
2026-11-02 Preserve Jetson CAD assets part 3 of 3
    [指1.SLDPRT, 指2.SLDPRT, 指3.SLDPRT, 新机械臂.SLDASM, 新车架第三版.SLDPRT, 机械臂主体.SLDASM, 杆件.SLDPRT, 第三版底盘.SLDASM]
